jrytio/desiccant-dryer/docs/datasheets/README.md

# Component datasheets

Reference copies of the manufacturer documents for the parts in the
hardware BOMs ([protoboard](../hardware.md#bill-of-materials-protoboard-build),
[PCB](../hardware.md#printed-circuit-board-rev-a)), so the driver-stage numbers
and the protoboard layout can be checked against datasheets without leaving
the repo, and so a later re-check sees the same revision. All files were
retrieved on 2026-09-15 from the source in the table, except the SEFUSE
thermal-cutoff catalogue (2026-09-16), the PCB parts in `discretes/` (CJ, MDD,
NationStar, KENTO, UNI-ROYAL, Murata, YAGEO, Lelon), `fuses/`, `connectors/` and the two
module files in `power/` (K78, TSR-1), all retrieved 2026-10-14, the PTF-77, BLX-A and JST XH
files (2026-10-15, for the two-board rev A), and the four ESP32-C6 files
(2026-10-12, SparkFun's repository at commit `fb7352f`, which has no
`LICENSE.md` of its own; its README calls the hardware open source and
SparkFun's standing hardware licence is the CC BY-SA 4.0 in
`mcu/SPARKFUN-LICENSE.md`); the SHA-256 prefix is there to tell
whether a file was replaced. Manufacturer datasheets stay
their owners' copyright and are kept here for reference only; SparkFun's
hardware files are CC BY-SA 4.0 (`mcu/SPARKFUN-LICENSE.md`).

Prefer the manufacturer's current document when a number matters: a copy
here may be a revision behind. Where the manufacturer site refused a scripted
download, the table says whose copy this is.

| File | Part / where used | Document | Source | Pages | SHA-256 (first 16) | What to read |
|---|---|---|---|---|---|---|
| [mcu/sparkfun-esp32-s2-thing-plus.brd](mcu/sparkfun-esp32-s2-thing-plus.brd) | SparkFun ESP32-S2 Thing Plus (WRL-17743), the controller board | Eagle board file (CC BY-SA 4.0, see SPARKFUN-LICENSE.md) | [link](https://github.com/sparkfun/ESP32-S2_Thing_Plus/blob/main/Hardware/ESP32-S2_Thing_Plus.brd) |  | `3f91041525fae7df` | Outline (layer 20) is 22.86 × 64.77 mm; header pad positions; connector placement |
| [mcu/sparkfun-esp32-s2-thing-plus.sch](mcu/sparkfun-esp32-s2-thing-plus.sch) | SparkFun ESP32-S2 Thing Plus | Eagle schematic (CC BY-SA 4.0) | [link](https://github.com/sparkfun/ESP32-S2_Thing_Plus/blob/main/Hardware/ESP32-S2_Thing_Plus.sch) |  | `0bbf12487fef34cc` | Nets behind pinout-verification.md: V_USB → D2 → VIN → AP2112 → 3.3V; GPIO13 LED; USB jumper; no I2C pull-ups on the board |
| [mcu/sparkfun-esp32-s2-thing-plus-dimensions.pdf](mcu/sparkfun-esp32-s2-thing-plus-dimensions.pdf) | SparkFun ESP32-S2 Thing Plus | Dimensional drawing (inches) | [link](https://github.com/sparkfun/ESP32-S2_Thing_Plus/blob/main/Documents/ESP32-S2_Thing_Plus_DIMENSIONS.pdf) | 1 | `a04efc248ad8fc7d` | Board 2.55 × 0.90 in; header rows start 0.55 in (16-pin) and 0.95 in (12-pin) from the USB end; Qwiic at the USB end |
| [mcu/sparkfun-esp32-s2-thing-plus-dimensions.png](mcu/sparkfun-esp32-s2-thing-plus-dimensions.png) | SparkFun ESP32-S2 Thing Plus | Same drawing as PNG | [link](https://github.com/sparkfun/ESP32-S2_Thing_Plus/blob/main/Documents/ESP32-S2_Thing_Plus_DIMENSIONS.png) |  | `3d97430a1adcbfc2` |  |
| [mcu/espressif-esp32-s2-wroom-datasheet.pdf](mcu/espressif-esp32-s2-wroom-datasheet.pdf) | ESP32-S2-WROOM module on the Thing Plus | Espressif datasheet v1.1 (2020), SparkFun's copy | [link](https://github.com/sparkfun/ESP32-S2_Thing_Plus/blob/main/Documents/esp32-s2-wroom_esp32-s2-wroom-i_datasheet_en.pdf) | 27 | `f9521959bb886423` | Module pinout, antenna keep-out (Fig. 3, Fig. 8), current consumption (Tables 7–8: 310 mA peak) |
| [mcu/espressif-esp32-s2-datasheet.pdf](mcu/espressif-esp32-s2-datasheet.pdf) | ESP32-S2 chip | Espressif datasheet v1.1 (2020), SparkFun's copy | [link](https://github.com/sparkfun/ESP32-S2_Thing_Plus/blob/main/Documents/esp32-s2_datasheet_en.pdf) | 45 | `58cc0a634ddb939a` | Strapping pins, GPIO drive strength (Table 10), USB pins 19/20 |
| [mcu/sparkfun-esp32-c6-thing-plus.brd](mcu/sparkfun-esp32-c6-thing-plus.brd) | SparkFun Thing Plus ESP32-C6 (DEV-22924), the second supported controller board | Eagle board file (CC BY-SA 4.0, see SPARKFUN-LICENSE.md) | [link](https://github.com/sparkfun/SparkFun_Thing_Plus_ESP32_C6/blob/fb7352f770b885fa9d5767bd25a168b90a11d4e5/Hardware/Thing_Plus_ESP32_C6.brd) |  | `24b289329c3f9c98` | Outline is 22.86 × 58.42 mm; header pads at the same coordinates as the S2 board's (12-pin from 1.27, 24.13; 16-pin from 21.59, 13.97) |
| [mcu/sparkfun-esp32-c6-thing-plus.sch](mcu/sparkfun-esp32-c6-thing-plus.sch) | SparkFun Thing Plus ESP32-C6 | Eagle schematic (CC BY-SA 4.0) | [link](https://github.com/sparkfun/SparkFun_Thing_Plus_ESP32_C6/blob/fb7352f770b885fa9d5767bd25a168b90a11d4e5/Hardware/Thing_Plus_ESP32_C6.sch) |  | `aa89ff067b61ef02` | Nets behind pinout-verification.md: header J1; jumpers ALRT, SD_DET, LP, RGB, I2C; R1 100 kΩ on IO8; R11 100 kΩ on RESET; V_USB → D3 → RT9080 → 3.3V; USB D−/D+ straight to IO12/IO13 |
| [mcu/espressif-esp32-c6-wroom-1-datasheet.pdf](mcu/espressif-esp32-c6-wroom-1-datasheet.pdf) | ESP32-C6-WROOM-1 module on the C6 Thing Plus | Espressif datasheet, pre-release v0.6, SparkFun's copy | [link](https://github.com/sparkfun/SparkFun_Thing_Plus_ESP32_C6/blob/fb7352f770b885fa9d5767bd25a168b90a11d4e5/Documents/ESP32-C6-WROOM-1-Datasheet.pdf) | 37 | `b0ae5c4c27f051bb` | Module pin layout and pin descriptions |
| [mcu/espressif-esp32-c6-datasheet.pdf](mcu/espressif-esp32-c6-datasheet.pdf) | ESP32-C6 chip | Espressif datasheet, pre-release v0.5, SparkFun's copy | [link](https://github.com/sparkfun/SparkFun_Thing_Plus_ESP32_C6/blob/fb7352f770b885fa9d5767bd25a168b90a11d4e5/Documents/ESP32-C6-Datasheet.pdf) | 69 | `1338481686672951` | Section 2.6, strapping pins: Table 2-14 boot mode (GPIO8 low with GPIO9 low is invalid), Table 2-13 MTMS/MTDI |
| [relay/songle-srd-relay.pdf](relay/songle-srd-relay.pdf) | Songle SRD-05VDC-SL-C heater relays | Songle SRD series datasheet (2-page mirror hosted by circuitbasics.com) | [link](https://www.circuitbasics.com/wp-content/uploads/2015/11/SRD-05VDC-SL-C-Datasheet.pdf) | 2 | `9967e9a62db84c57` | Coil table (5 V: 70 Ω, 71.4 mA for the 0.36 W "L" coil), contact ratings, 1500 VAC coil–contact, outline and hole pattern |
| [thermal-fuse/nec-sefuse-thermal-cutoff.pdf](thermal-fuse/nec-sefuse-thermal-cutoff.pdf) | SEFUSE SF129E heater over-temp cutouts (sold as BOJACK SF129E) | NEC SCHOTT SEFUSE thermal cutoff catalogue, SF/SM series; distributor copy (Selli Fuse). The site answers a scripted download with a JavaScript challenge page, so this copy came from a browser download |  [link](http://www.sellifuse.com/pdf/NEC%20SEFUSE%20Thermal%20Cutoff.pdf) | 16 | `80c1d5b3843ec457` | SF/E standard rating table: SF129E is Tf 133 °C, operating 129 ± 2 °C, holding temperature Th 118 °C, maximum Tm 159 °C, 10 A / 250 VAC. Th is what the firmware `overtemp` limit has to stay below |
| [discretes/onsemi-pn2222a.pdf](discretes/onsemi-pn2222a.pdf) | PN2222A relay driver (the usual "2N2222" in TO-92) | onsemi PN2222/PN2222A, Rev. 1.1.0 | [link](https://web.archive.org/web/2022id_/https://www.onsemi.com/pdf/datasheet/pn2222a-d.pdf) | 8 | `f1eda8482f5f227f` | TO-92 pin order is E-B-C (flat face toward you, legs down); hFE and V<sub>CE(sat)</sub> tables |
| [discretes/onsemi-p2n2222a.pdf](discretes/onsemi-p2n2222a.pdf) | P2N2222A, an alternative TO-92 "2N2222" with the REVERSE pin order | onsemi P2N2222A, Rev. 7 | [link](https://cdn.sparkfun.com/datasheets/Components/General/P2N2222A-D.PDF) | 6 | `e8d9dd9bde7e379f` | Pin 1 is the collector: C-B-E. Check which part you have before fitting |
| [discretes/infineon-irlz44n.pdf](discretes/infineon-irlz44n.pdf) | IRLZ44N valve and fan drivers | Infineon / IR IRLZ44NPbF, PD-94831 | [link](https://www.infineon.com/dgdl/irlz44npbf.pdf?fileId=5546d462533600a40153567217c32129) | 10 | `b4f1361a4486b8ec` | V<sub>GS(th)</sub>, R<sub>DS(on)</sub> at 4 V and 5 V, transfer characteristic (3.3 V drive is not a specified point), TO-220 pin order G-D-S |
| [discretes/vishay-1n4001-1n4007.pdf](discretes/vishay-1n4001-1n4007.pdf) | 1N4007 flyback diodes | Vishay General Semiconductor, Revision 29-Apr-2020 | [link](https://www.vishay.com/docs/88503/1n4001.pdf) | 5 | `56a77c6615c90c11` | Ratings; the colour band marks the cathode, which goes to the supply side |
| [power/meanwell-lrs-35.pdf](power/meanwell-lrs-35.pdf) | Mean Well LRS-35-24 supply | Mean Well LRS-35 spec sheet, 2025-04-07 | [link](https://www.meanwell.com/Upload/PDF/LRS-35/LRS-35-SPEC.PDF) | 4 | `43ceb7255f0613bf` | 24 V / 1.5 A, hiccup overload 110–150 %, 45 A cold-start inrush, FG terminal, derating; an open-frame Class I component supply |
| [power/mps-mp1584.pdf](power/mps-mp1584.pdf) | MPS MP1584, the IC on the 24 V → 5 V "MP1584 mini" buck module | MPS MP1584 Rev. 1.0 (2011), RS Components' copy; monolithicpower.com serves datasheets through a viewer | [link](https://docs.rs-online.com/b924/A700000013716646.pdf) | 17 | `4b850bd18a8ce88b` | 4.5–28 V input, non-synchronous (cannot sink current), 3 A, feedback 0.8 V ±3 %, input capacitor requirement |
| [power/st-bat20j.pdf](power/st-bat20j.pdf) | BAT20J Schottky on the Thing Plus (D2, USB pin → VIN) | ST BAT20J, April 2004 Ed. 1 | [link](https://www.st.com/resource/en/datasheet/bat20j.pdf) | 5 | `c134fbb1f476bc20` | Forward drop vs current (0.40 V max at 100 mA, ~0.5 V at 400 mA): the drop budget when the buck feeds the USB pin |
| [power/diodes-ap2112.pdf](power/diodes-ap2112.pdf) | AP2112K-3.3 LDO on the Thing Plus (U3) | Diodes Inc. AP2112, DS39724 Rev. 2-2 (June 2017) | [link](https://www.diodes.com/assets/Datasheets/AP2112.pdf) | 18 | `ef8d376f2ec356e2` | 600 mA, dropout vs current, 6.0 V recommended / 6.5 V absolute maximum input |
| [power/diodes-dmg2307l.pdf](power/diodes-dmg2307l.pdf) | DMG2307L battery cut-off P-FET on the Thing Plus (Q1) | Diodes Inc. DMG2307L, DS35415 Rev. 6-3 (marked not for new design) | [link](https://www.diodes.com/assets/Datasheets/DMG2307L.pdf) | 7 | `51e506995ea31c15` | Why 5 V must not be fed into the BAT pin |
| [power/microchip-mcp73831.pdf](power/microchip-mcp73831.pdf) | MCP73831 LiPo charger on the Thing Plus (U4) | Microchip DS20001984H | [link](https://ww1.microchip.com/downloads/aemDocuments/documents/APID/ProductDocuments/DataSheets/MCP73831-Family-Data-Sheet-DS20001984H.pdf) | 29 | `75297f2a52355993` | Behaviour with no battery while V_USB is fed from the buck; 7 V absolute maximum input |
| [sensors/sensirion-sht4x.pdf](sensors/sensirion-sht4x.pdf) | Sensirion SHT45 outlet humidity sensor | Sensirion SHT4x datasheet, Version 7.3 (June 2026) | [link](https://sensirion.com/resource/datasheet/sht4x) | 25 | `8db4a43f17149b76` | Supply range, I2C address 0x44, accuracy at low RH (Fig. 5, Fig. 9), bus pull-up limits, heater |
| [sensors/analog-ds18b20.pdf](sensors/analog-ds18b20.pdf) | DS18B20 pack and case temperature probes | Maxim / Analog Devices DS18B20 (REV 042208), Adafruit's copy; analog.com refuses scripted downloads | [link](https://cdn-shop.adafruit.com/datasheets/DS18B20.pdf) | 22 | `39d191cd1fb657e4` | 3.0–5.5 V supply, ~5 kΩ pull-up, die −55 to +125 °C, ±0.5 °C only from −10 to +85 °C (±2 °C above), +85 °C power-on value |
| [sensors/sitronix-st7789v.pdf](sensors/sitronix-st7789v.pdf) | ST7789V controller in the 1.54" 240×240 display | Sitronix ST7789V, Version 1.3 (hosted by Newhaven Display) | [link](https://www.newhavendisplay.com/appnotes/datasheets/LCDs/ST7789V.pdf) | 316 | `8ecf0e438aa25554` | Logic supply range, 4-line SPI timing (16 ns write cycle), reset timing |
| [sensors/lcdwiki-msp1541-user-manual.pdf](sensors/lcdwiki-msp1541-user-manual.pdf) | LCDWIKI MSP1541, a typical 1.54" 8-pin ST7789 module | LCDWIKI MSP1541 user manual Rev1.0 | [link](http://www.lcdwiki.com/res/MSP1541/1.54inch_4-line-SPI_IPS_Module_MSP1541_User_Manual_EN.pdf) | 18 | `f942da1ba5fbb2ce` | Pin order GND VCC SCL SDA RES DC CS BLK (matches the display header in the layout); 3.3 V only |
| [sensors/lcdwiki-msp1541-schematic.pdf](sensors/lcdwiki-msp1541-schematic.pdf) | LCDWIKI MSP1541 module schematic | QDtech, 2019-11-14 | [link](https://www.lcdwiki.com/res/MSP1541/1.54IPS_MSP1541_Schematic.pdf) | 1 | `75ed8127fa6adc81` | BLK drives an S8050 transistor through 1 kΩ (10 kΩ pull-up to VCC), so a GPIO can drive it directly and the backlight defaults on |
| [sensors/waveshare-1.54inch-lcd-module-schematic.pdf](sensors/waveshare-1.54inch-lcd-module-schematic.pdf) | Waveshare 1.54inch LCD Module, another common ST7789 module | Waveshare schematic, 2020 | [link](https://files.waveshare.com/wiki/1.54inch_LCD_Module/1.54inch_LCD_Module_SchDoc.pdf) | 2 | `dc7c6c569e05ea48` | Different header order (VCC GND DIN CLK CS DC RST BL): a straight cable from the layout's header would swap power and ground |
| [sensors/adafruit-1.54in-ips-tft-schematic.png](sensors/adafruit-1.54in-ips-tft-schematic.png) | Adafruit 1.54" IPS TFT (product 3787) | Adafruit schematic rev G, 2019 | [link](https://cdn-learn.adafruit.com/assets/assets/000/079/157/original/adafruit_products_1-54in_IPS_TFT_Sch.png) |  | `7912d71e033c8786` | Backlight through a BSS138; third example of a transistor-driven BLK |
| [valves/smc-vdw-series-catalog-current.pdf](valves/smc-vdw-series-catalog-current.pdf) | SMC VDW22QABXB vent valves | SMC "Compact Direct Operated 2 Port Solenoid Valve, VDW Series" (current series, catalogue pp. 453–470, 2022 revision) | [link](https://content2.smcetech.com/pdf/VDWb.pdf) | 20 | `f2e8a214297826bc` | How-to-order table that decodes VDW22QABXB (size 2, water type, brass 1/8 NPT ø3.2, 24 VDC grommet, bracket); 3 W DC coil, no built-in suppressor; 50 °C limit; 0.2 MPa differential for ø3.2 |
| [valves/smc-vdw10-20-30-catalog-discontinued.pdf](valves/smc-vdw10-20-30-catalog-discontinued.pdf) | SMC VDW10/20/30 (previous series) | SMC "VDW Series for Water and Air", catalogue pp. 471–495, marked discontinued | [link](https://content2.smcetech.com/pdf/VDW.pdf) | 25 | `734f57eeaacf824a` | The catalogue a search for "VDW22" finds first; its hyphenated ordering table cannot decode the BOM part number |
| [fan/sunon-mf80252v1-1000u-g99.pdf](fan/sunon-mf80252v1-1000u-g99.pdf) | Example 24 V 80 mm case fan (Sunon MF80252V1-1000U-G99); no fan has been chosen yet | Sunon specification D08064510G-01, rev 2021-07-26 (distributor copy) | [link](https://www.fansco.com/datasheets/sunon/MF80252V1-1000U-G99.pdf) | 15 | `84b13dafba699f3b` | 24 V, 65 mA rated / 75 mA max, 8–27.6 V operating, polarity protected: sizes the fan channel |
| [discretes/cj-mmbt2222a.pdf](discretes/cj-mmbt2222a.pdf) | CJ MMBT2222A 1P (LCSC C8512), PCB relay drivers Q1, Q2 | Changjiang (JCET) MMBT2222A, LCSC's copy | [link](https://wmsc.lcsc.com/wmsc/upload/file/pdf/v2/lcsc/1811081957_Jiangsu-Changjing-Electronics-Technology-Co---Ltd--MMBT2222A-1P_C8512.pdf) | 2 | `af383629b6a3bbb5` | SOT-23 pin order 1 B, 2 E, 3 C; 600 mA, 40 V |
| [discretes/cj-cj2310.pdf](discretes/cj-cj2310.pdf) | CJ CJ2310 (LCSC C75882), PCB valve and fan switches Q3–Q5 | Changjiang (JCET) CJ2310, LCSC's copy | [link](https://wmsc.lcsc.com/wmsc/upload/file/pdf/v2/lcsc/1810010214_Jiangsu-Changjing-Electronics-Technology-Co---Ltd--CJ2310_C75882.pdf) | 5 | `8095c146e18963bb` | 60 V; V<sub>GS(th)</sub> 0.5–2 V; R<sub>DS(on)</sub> 125 mΩ max at 4.5 V (3.3 V is not a specified point); pins 1 G, 2 S, 3 D |
| [discretes/mdd-m7.pdf](discretes/mdd-m7.pdf) | MDD M7 (LCSC C95872), PCB flyback diodes D1, D2, D5–D7 (the S1M rating) | MDD M1–M7, LCSC's copy | [link](https://wmsc.lcsc.com/wmsc/upload/file/pdf/v2/lcsc/2407101107_MDD-Microdiode-Semiconductor-M7_C95872.pdf) | 3 | `ab203b9979af54e0` | 1 A, 1000 V, SMA; the band marks the cathode |
| [discretes/mdd-ss34.pdf](discretes/mdd-ss34.pdf) | MDD SS34 (LCSC C8678), PCB D11 reverse-polarity and D14 USB feed | MDD SS32–SS320, LCSC's copy | [link](https://wmsc.lcsc.com/wmsc/upload/file/pdf/v2/lcsc/2407101107_MDD-Microdiode-Semiconductor-SS34_C8678.pdf) | 3 | `fb49708757796969` | 3 A, 40 V, 0.55 V at 3 A |
| [discretes/nationstar-ncd0805r1.pdf](discretes/nationstar-ncd0805r1.pdf) | NationStar NCD0805R1 red LED (LCSC C84256), PCB D3, D4 | NationStar NCD0805R1, LCSC's copy | [link](https://wmsc.lcsc.com/wmsc/upload/file/pdf/v2/lcsc/2409272203_Foshan-NationStar-Optoelectronics-NCD0805R1_C84256.pdf) | 2 | `3a6caf350b158166` | V<sub>F</sub> 1.5–2.6 V at 20 mA; polarity mark |
| [discretes/kento-kt-0805y.pdf](discretes/kento-kt-0805y.pdf) | KENTO KT-0805Y yellow LED (LCSC C2296), PCB D8–D10 | KENTO KT-0805Y, LCSC's copy | [link](https://wmsc.lcsc.com/wmsc/upload/file/pdf/v2/lcsc/1806151129_Hubei-KENTO-Elec-KT-0805Y_C2296.pdf) | 11 | `d8a2b8369f288161` | V<sub>F</sub> 1.8–2.4 V at 10 mA |
| [discretes/kento-kt-0805g.pdf](discretes/kento-kt-0805g.pdf) | KENTO KT-0805G green LED (LCSC C2297), PCB D12, D13 | KENTO KT-0805G, LCSC's copy | [link](https://wmsc.lcsc.com/wmsc/upload/file/pdf/v2/lcsc/1806151820_Hubei-KENTO-Elec-KT-0805G_C2297.pdf) | 11 | `853e6752f600e247` | V<sub>F</sub> 2.6–3.1 V at 5 mA |
| [discretes/uniroyal-0805w8f.pdf](discretes/uniroyal-0805w8f.pdf) | UNI-ROYAL 0805W8F thick-film resistors, all PCB resistors (LCSC C17408, C17513, C17520, C27834, C17414) | UNI-ROYAL chip resistor series, LCSC's copy (the same file for every value) | [link](https://wmsc.lcsc.com/wmsc/upload/file/pdf/v2/lcsc/2411221126_UNI-ROYAL-Uniroyal-Elec-0805W8F1000T5E_C17408.pdf) | 9 | `11cd644d5d8a34a6` | 1 %, 125 mW, 150 V working voltage at 0805 |
| [discretes/murata-grm21br61h106ke43l.pdf](discretes/murata-grm21br61h106ke43l.pdf) | Murata GRM21BR61H106KE43L (LCSC C440198), PCB C2 | Murata product datasheet, LCSC's copy | [link](https://wmsc.lcsc.com/wmsc/upload/file/pdf/v2/lcsc/2411041759_Murata-Electronics-GRM21BR61H106KE43L_C440198.pdf) | 31 | `ff8de8901544f5f4` | 10 µF 50 V X5R 0805; DC-bias derating |
| [discretes/yageo-cc0805-x7r.pdf](discretes/yageo-cc0805-x7r.pdf) | YAGEO CC0805KRX7R9BB104 (LCSC C49678), PCB C5 | YAGEO CC series X7R, LCSC's copy | [link](https://wmsc.lcsc.com/wmsc/upload/file/pdf/v2/lcsc/2304140030_YAGEO-CC0805KRX7R9BB104_C49678.pdf) | 29 | `61a606825ab314ea` | 100 nF 50 V X7R 0805 |
| [discretes/lelon-vzh.pdf](discretes/lelon-vzh.pdf) | Lelon VZH electrolytics, PCB C1 (VZH101M1HTR-0810, LCSC C294509) and C4 (VZH101M1CTR-0607, LCSC C231174) | Lelon VZH series, Cat. 2025E3, LCSC's copy (the same file for both) | [link](https://wmsc.lcsc.com/wmsc/upload/file/pdf/v2/lcsc/2304140030_Lelon-VZH101M1HTR-0810_C294509.pdf) | 3 | `c50f58036daa6123` | Dimension table: 8 × 10 terminals 3.1 mm apart, 9.0 overall; 6.3 × 7.7 terminals 2.0 apart, 7.2 overall (both inside the KiCad CP_Elec pads) |
| [fuses/littelfuse-1812l.pdf](fuses/littelfuse-1812l.pdf) | Littelfuse 1812L110/33MR (LCSC C142747), PCB F2 24 V input PPTC | Littelfuse 1812L series, LCSC's copy | [link](https://wmsc.lcsc.com/wmsc/upload/file/pdf/v2/lcsc/2304140030_Littelfuse-1812L110-33MR_C142747.pdf) | 7 | `6208de21968a51c9` | 1812L110/33: I<sub>hold</sub> 1.10 A, I<sub>trip</sub> 1.95 A, 33 V max |
| [fuses/xfcn-ptf-76-b.pdf](fuses/xfcn-ptf-76-b.pdf) | XFCN PTF-76-B covered 5 × 20 mm fuse holder (LCSC C48603682), mains-board F1 again from 2026-10-16 (the single-board rev A's choice; the holders on hand do not fit beside the vertical plug) | XFCN drawing PTF-76-B rev A1 (2025-04-23), LCSC's copy | [link](https://wmsc.lcsc.com/wmsc/upload/file/pdf/v2/lcsc/2504281715_XFCN-PTF-76-B_C48603682.pdf) | 1 | `866386d6da1c64c0` | Pins 15 mm apart, 0.5 × 1.03 mm, PCB hole Ø1.6; body 24.4 × 9.4 × 15 mm; UL 250 VAC 20 A, VDE 6.3 A; PC1 shock-safe cap |
| [fuses/xfcn-ptf-77.pdf](fuses/xfcn-ptf-77.pdf) | XFCN PTF-77 covered 5 × 20 mm fuse holder (LCSC C717030), a 22.5 mm covered holder; not an alternative for mains-board F1 beside the vertical plug (its body would reach into the plug's courtyard), only for a right-angle-plug layout | XFCN drawing PTF-77 rev A2 (2024-10-31), LCSC's copy | [link](https://datasheet.lcsc.com/datasheet/pdf/4d0d950ca032c4cb948cbbb43ce1e88c.pdf?productCode=C717030) | 1 | `1149838c5e30dc7b` | Pins 22.50 mm apart, 0.5 × 1.03 mm, PCB hole Ø1.6; the PTF-76-B body (24.4 × 9.4, 15 mm tall); UL 250 VAC 20 A, VDE 6.3 A |
| [fuses/jksemi-blx-a.pdf](fuses/jksemi-blx-a.pdf) | BLX-A covered 5 × 20 mm PCB fuse holder, the moulding the holders on hand (Amazon B0FCS5MK1Y, 10 A 250 V) match by their dimensions; not fitted on the mains board (the body does not fit beside the vertical plug) | JKSEMI BLX-A rev 1.0 | [link](https://img03.71360.com/w3/772o3g/20250716/01c82b612508a7961211755f06253753.pdf) | 2 | `c2f9afe90a399a08` | Pins 22.3 ± 1.0 mm apart (21.5 to 22.7 accepted), 1.31 mm blades, R 1.5 pads; base 25.8 × 9.7 × 10.2, 13.45 mm with the cover; the Amazon listing's drawing gives the same 25.8 and 13.4 but no pitch; the reviewer's first 12.5 mm reading (2026-10-15) came from the listing's picture; he then confirmed about 22 mm on the holders, matching this sheet |
| [connectors/dorabo-db2erc-5.08.pdf](connectors/dorabo-db2erc-5.08.pdf) | DORABO DB2ERC-5.08-8P-GN right-angle header (LCSC C395786), PCB J_MAINS until 2026-10-15; the vertical DB2EV-5.08-8P-GN (LCSC C395787, 630 V 15 A per LCSC) replaced it and its drawing is not retrieved (LCSC: `datasheet/C395787.pdf`) | DORABO drawing DB2ERC-5.08-XXP-C rev M1, LCSC's copy | [link](https://wmsc.lcsc.com/wmsc/upload/file/pdf/v2/lcsc/2303271530_DORABO-DB2ERC-5-08-8P-GN_C395786.pdf) | 1 | `87e383dca46af68b` | Pitch 5.08, 1.0 mm pins, hole Ø1.7, body 12.0 deep with the pins 2.0 from the rear; UL 300 V 15 A, IEC 250 V/15 A (III/3) |
| [connectors/dorabo-db2evc-5.08.pdf](connectors/dorabo-db2evc-5.08.pdf) | DORABO DB2EVC-5.08 vertical headers, PCB J_LOADS (6P, LCSC C395768) and J_24V (2P, LCSC C395734) | DORABO drawing DB2EVC-5.08-XXP-C rev M1, LCSC's copy (the same file for both) | [link](https://wmsc.lcsc.com/wmsc/upload/file/pdf/v2/lcsc/2303271600_DORABO-DB2EVC-5-08-6P-GN_C395768.pdf) | 1 | `ca60a84814ef0e6e` | Pitch 5.08, 1.0 mm pins, hole Ø1.7, body 7.8 deep (8.65 with the latch), pins 3.9 from the back |
| [connectors/dorabo-db2evc-3.5.pdf](connectors/dorabo-db2evc-3.5.pdf) | DORABO DB2EVC-3.5-9P-GN vertical header (LCSC C430559), PCB J_SENS | DORABO drawing DB2EVC-3.5-XXP-C rev T0-1, LCSC's copy | [link](https://wmsc.lcsc.com/wmsc/upload/file/pdf/v2/lcsc/2303271530_DORABO-DB2EVC-3-5-9P-GN_C430559.pdf) | 1 | `30e5f93cc9237795` | Pitch 3.5, 0.8 × 0.8 mm pins, hole Ø1.4, body N × 3.5 + 1.0 by 7.0 |
| [connectors/dorabo-db2ek-5.08.pdf](connectors/dorabo-db2ek-5.08.pdf) | DORABO DB2EK-5.08 screw plugs (loose): 8P C395791, 6P C395774, 2P C395732 | DORABO drawing DB2EK-5.08, LCSC's copy (the same file for all three) | [link](https://wmsc.lcsc.com/wmsc/upload/file/pdf/v2/lcsc/2303271530_DORABO-DB2EK-5-08-8P-GN-S_C395791.pdf) | 1 | `18b9159a3f026e80` | Mating plugs for J_MAINS, J_LOADS, J_24V; wire range |
| [connectors/dorabo-db2ek-3.5.pdf](connectors/dorabo-db2ek-3.5.pdf) | DORABO DB2EK-3.5-9P-GN-S screw plug (loose, LCSC C430561) | DORABO drawing DB2EK-3.5, LCSC's copy | [link](https://wmsc.lcsc.com/wmsc/upload/file/pdf/v2/lcsc/2301061509_DORABO-DB2EK-3-5-9P-GN-S_C430561.pdf) | 1 | `5e8dfb0508795183` | Mating plug for J_SENS |
| [connectors/xfcn-pz254v-11-08p.pdf](connectors/xfcn-pz254v-11-08p.pdf) | XFCN PZ254V-11-08P pin header (LCSC C492407), PCB J_DISP | XFCN drawing, LCSC's copy | [link](https://wmsc.lcsc.com/wmsc/upload/file/pdf/v2/lcsc/2003191006_XFCN-PZ254V-11-08P_C492407.pdf) | 1 | `d4cb67e0fd15267b` | 2.54 pitch, 0.64 mm square pins, hole Ø1.02 |
| [connectors/kinghelm-kh-2.54fh-1x16p-h8.5.pdf](connectors/kinghelm-kh-2.54fh-1x16p-h8.5.pdf) | Kinghelm KH-2.54FH-1X16P-H8.5 socket (LCSC C2905421), PCB J_ESP16 | Kinghelm drawing, LCSC's copy | [link](https://wmsc.lcsc.com/wmsc/upload/file/pdf/v2/lcsc/2110191530_Shenzhen-Kinghelm-Elec-KH-2-54FH-1X16P-H8-5_C2905421.pdf) | 1 | `3146e4188cce064f` | 2.54 pitch, 8.5 mm insulator, 0.64 × 0.4 mm pins, hole Ø1.02 |
| [connectors/kinghelm-kh-2.54fh-1x12p-h8.5.pdf](connectors/kinghelm-kh-2.54fh-1x12p-h8.5.pdf) | Kinghelm KH-2.54FH-1X12P-H8.5 socket (LCSC C2905419), PCB J_ESP12 | Kinghelm drawing, LCSC's copy | [link](https://wmsc.lcsc.com/wmsc/upload/file/pdf/v2/lcsc/2110191530_Shenzhen-Kinghelm-Elec-KH-2-54FH-1X12P-H8-5_C2905419.pdf) | 1 | `9dbea449c7a25dd6` | As the 16-pin |
| [connectors/jst-xh.pdf](connectors/jst-xh.pdf) | JST XH series, B4B-XH-A(LF)(SN) 4-way header (LCSC C144395), PCB J_RLY (controller) and J_CTRL (mains), the board-to-board link; XHP-4 housing and SXH crimps for the cable | JST XH connector catalogue, jst-mfg.com | [link](https://www.jst-mfg.com/product/pdf/eng/eXH.pdf) | 9 | `9426b136902f1190` | 2.50 mm pitch, 0.64 mm square pins, PCB hole Ø0.9 (KiCad's footprint drills 0.95); B4B-XH-A top-entry dimensions; 3 A, 250 V |
| [connectors/sofng-ss-12d00.pdf](connectors/sofng-ss-12d00.pdf) | SOFNG SS-12D00-G3 slide switch (LCSC C22355741), PCB SW1 (SW-USB) | SOFNG SS-12D00 series, LCSC's copy | [link](https://wmsc.lcsc.com/wmsc/upload/file/pdf/v2/lcsc/2405291526_SOFNG-SS-12D00-G3_C22355741.pdf) | 1 | `c7b840388e60f1b7` | Pitch 2.5 mm (not 2.54), 0.5 × 0.3 mm pins, body 8.8 × 3.9; 0.5 A 24 V DC; middle pin common |
| [power/mornsun-k78xx-1000r3.pdf](power/mornsun-k78xx-1000r3.pdf) | MornSun K7805-1000R3 5 V module, PCB U1 (hand-fitted) | MornSun K78xx-1000R3(L), 2021.01.8-A/3, chipdip.ru's copy (mornsun-power.com's direct link is 404) | [link](https://static.chipdip.ru/lib/187/DOC043187583.pdf) | 4 | `8377b7879d3c08d9` | Pin 1 +Vin, 2 GND, 3 +Vout; 22 µF/50 V input capacitor above 30 V in |
| [power/traco-tsr-1.pdf](power/traco-tsr-1.pdf) | TRACO TSR 1-2450, the TSR-1 footprint's own part and U1's Mouser source (495-TSR-1-2450) | TRACO TSR-1 series datasheet | [link](https://www.tracopower.com/sites/default/files/products/datasheets/tsr1_datasheet.pdf) | 4 | `bedf240fea9eebaf` | Same 78xx pinout and SIP-3 outline as the K78; input range |

## Not included

- Songle's current SRD revision (V1, 3 pages, 13 MB, a CorelDRAW print with a
  broken text layer) is at
  <https://www.songlerelay.com/upload/8670/srd-t73-relay-290486.pdf>. Left
  out for its size; the 2-page mirror above is the earlier revision with the
  same coil table and hole pattern (COM at the coil end, 2.0 mm outboard;
  rows 12.0 mm and columns 12.2 mm apart; holes 1.3 mm).
- The DS18B20 document's canonical home is
  <https://www.analog.com/media/en/technical-documentation/data-sheets/DS18B20.pdf>
  (Rev 6 there); analog.com refuses scripted downloads, so the copy here is
  Adafruit's, an older revision with the same tables.
- The buck module itself has no datasheet: "MP1584 mini" boards come from
  many vendors at 22 × 17 mm with a trimmer and no fixed part number. The
  MPS datasheet above covers the IC.
- The Samsung CL21A MLCC catalogue for PCB C3 (CL21A226MAQNNNE, LCSC C45783) and C6
  (CL21A106KAYNNNE, LCSC C15850) is at
  <https://wmsc.lcsc.com/wmsc/upload/file/pdf/v2/lcsc/2304140030_Samsung-Electro-Mechanics-CL21A226MAQNNNE_C45783.pdf>.
  Left out for its size (84 pages, 7.8 MB).
- KENTO's red KT-0805R (LCSC C2295) has no datasheet at LCSC or JLCPCB, which is why the
  red LEDs are NationStar NCD0805R1 instead (checked 2026-10-14).
