jrytio/desiccant-dryer/docs/superpowers/plans/2026-10-14-pcb-design-kicad.md

# PCB Design in KiCad Implementation Plan

> **For agentic workers:** REQUIRED SUB-SKILL: Use superpowers:subagent-driven-development (recommended) or superpowers:executing-plans to implement this plan task-by-task. Steps use checkbox (`- [ ]`) syntax for tracking.

**Goal:** One fab-assembled KiCad 10 board, generated from Python in `hardware/`, that replaces the two protoboards, with ERC, DRC (including a 6 mm mains clearance rule) and fab exports run by `scripts/hardware.sh` locally and in CI.

**Architecture:** `hardware/dryer_board/circuit.py` is the single table of parts, pins and nets; everything else derives from it. `schematic.py` writes a label-style `.kicad_sch` by embedding stock symbols; `board.py` builds the `.kicad_pcb` through KiCad's bundled `pcbnew` Python from a placement table and exports a DSN; `route.py` runs Freerouting in Docker and imports the SES; `kicad-cli` checks and exports. The committed KiCad files are regenerated by the generator and compared in CI; routing stays local.

**Deviation from the spec:** exports are driven by `export.py` calling `kicad-cli` directly instead of a `.kicad_jobset`; same commands, no GUI-authored JSON to maintain.

**Tech Stack:** KiCad 10.0.6 (`kicad-cli`, bundled Python 3.9 with `pcbnew`), Docker image `ghcr.io/freerouting/freerouting:2.5.0`, CI image `kicad/kicad:10.0`, Python 3.9 standard library only (no pip), bash.

**Spec:** `docs/superpowers/specs/2026-10-14-pcb-design-kicad-design.md`

## Global Constraints

- Python in `hardware/` runs under KiCad's bundled Python **3.9** (no `match`, no `X | Y` type unions, no pip packages). Tests use `unittest`.
- **No Java on the Mac.** Freerouting runs only as `ghcr.io/freerouting/freerouting:2.5.0` in Docker.
- Generated files are deterministic: UUIDs from `uuid.uuid5(NAMESPACE, "dryer/<key>")`, dictionaries emitted in sorted order, no timestamps.
- Mains nets are exactly `L_IN`, `L_FUSED`, `L_SW_A`, `L_SW_B`, `N`; they form netclass `MAINS` (1.5 mm tracks, 1.0 mm in-class clearance, no pours). Mains to any other net: 6 mm, relaxed to 3.5 mm only inside rule areas named `relay_pads`. Copper to edge and slot 0.5 mm; mains copper to edge 1 mm.
- Relay K1/K2: pad 1 = COM, pads 2 and 5 = coil, **pad 3 = NO** (heater), **pad 4 = NC** (no copper). Derived from the KiCad `SANYOU_SRD_Form_C` symbol drawing and Songle's wiring diagram; the first-article continuity check confirms it on the real part.
- The pin map by header position is fixed (spec, `pinmap.py`); 12-pin positions 9 and 10 and 16-pin positions 15 and 16 stay unconnected; I2C stays on the ESP's Qwiic connector.
- Part choices: every part carries an LCSC number or `hand_fit=True`; no part is "tested" or "verified" in docs unless it was.
- Repo rules: no device IPs, no VMD-08/Azco branding in titles, numbers sourced from `docs/datasheets/`, unverified values marked as such.
- Commit after every task with a message in the repo's style (imperative, what and why); end commit messages with `Co-Authored-By: Claude Fable 5.1 <noreply@anthropic.com>`.
- Never `cp` onto `esphome/secrets.yaml` in a worktree (it is a symlink to the real secrets).

## Review Focus

1. **A footprint whose pad numbers do not match the symbol's pin numbers** (the slide switch and fuse holder are the likely ones): the part would be wired to the wrong pads. Task 5's test asserts every footprint has every pad number the model assigns.
2. **Relay NO/NC swapped**: the heater would be live with the relay off. Task 3's test pins K1/K2 pad 3 to `L_SW_x` and pad 4 to NC, and Task 17's continuity check confirms it on the real relay.
3. **A mains net left out of the `MAINS` netclass pattern** (`N` does not match `L_*`): the 6 mm rule would silently not apply. Task 8's test asserts each of the five mains nets resolves to `MAINS` and no other net does.
4. **Copper under the antenna**: a track or pour routed into the keep-out would detune the WiFi antenna. Task 10's test scans the routed board for any copper inside the antenna rectangle.
5. **Electrolytic or LED polarity reversed in the model**: a reversed 100 µF at 24 V vents. Task 3's test asserts pad 1 of every `C_Polarized` is on a rail and pad 2 on GND, and that every LED's anode side goes to its resistor and its cathode to the switched node or GND.

---

## File Structure

```
hardware/
  README.md                      how to generate, route, check, export; tool locations
  dryer_board/
    __init__.py
    kicad_env.py                 find kicad-cli, KiCad's python, symbol and footprint dirs
    sexp.py                      S-expression parse/dump (schematic, libraries)
    circuit.py                   REVISION, nets, the parts table, netlist(), invariants
    pinmap.py                    header position -> function (shared with tests/test_pinmap.py)
    libs.py                      read stock symbols (flatten `extends`), locate footprints, pad numbers
    schematic.py                 write dryer-controller.kicad_sch, sym-lib-table, fp-lib-table
    project.py                   write dryer-controller.kicad_pro and .kicad_dru
    placement.py                 board outline, zones, slot gaps, placement table, silkscreen text
    board.py                     build/update dryer-controller.kicad_pcb with pcbnew; export DSN
    route.py                     Freerouting in Docker; import SES; fill zones
    export.py                    kicad-cli exports, JLCPCB BOM/CPL conversion, renders, zip
    check_sync.py                committed files == regenerated model
    cli.py                       `python -m dryer_board <generate|route|check|export|test>`
  dryer-controller/
    dryer-controller.kicad_pro   generated
    dryer-controller.kicad_sch   generated
    dryer-controller.kicad_pcb   generated + routed (tracks are the only hand/route-owned content)
    dryer-controller.kicad_dru   generated
    sym-lib-table, fp-lib-table  generated
    lib/dryer.pretty/            local footprints (only if a stock one is missing)
  tests/
    test_sexp.py test_circuit.py test_libs.py test_schematic.py test_project.py
    test_board.py test_route.py test_export.py
  out/                           gitignored fab outputs
scripts/hardware.sh              wrapper: finds KiCad, runs the subcommands
tests/test_pinmap.py             repo-level: firmware board packages vs pinmap (plain python3)
.github/workflows/hardware.yml   check + export + release on pcb-* tags
docs/hardware/                   schematic.pdf, top.svg, render-top.png, render-iso.png
```

The tasks run in this order; each is independently testable. Tasks 1 to 7 need no Docker. Task 10 needs Docker. Task 15 needs internet (LCSC lookups).

---

### Task 1: Tool locator and wrapper script

**Files:**
- Create: `hardware/dryer_board/__init__.py`, `hardware/dryer_board/kicad_env.py`, `hardware/dryer_board/cli.py`, `scripts/hardware.sh`, `hardware/README.md`
- Create: `hardware/tests/__init__.py`, `hardware/tests/test_kicad_env.py`
- Modify: `.gitignore` (add `hardware/out/`)

**Interfaces:**
- Produces: `kicad_env.kicad_cli() -> str`, `kicad_env.symbol_dir() -> str`, `kicad_env.footprint_dir() -> str`, `kicad_env.run_cli(*args) -> subprocess.CompletedProcess` (raises on nonzero), `kicad_env.REPO`, `kicad_env.PROJECT_DIR` (`hardware/dryer-controller`), `kicad_env.OUT_DIR` (`hardware/out`).

- [ ] **Step 1: Write the failing test**

```python
# hardware/tests/test_kicad_env.py
import os, unittest
from dryer_board import kicad_env

class KicadEnv(unittest.TestCase):
    def test_tools_exist(self):
        self.assertTrue(os.path.isfile(kicad_env.kicad_cli()))
        self.assertTrue(os.path.isfile(os.path.join(kicad_env.symbol_dir(), "Device.kicad_sym")))
        self.assertTrue(os.path.isdir(os.path.join(kicad_env.footprint_dir(), "Relay_THT.pretty")))

    def test_run_cli_version(self):
        out = kicad_env.run_cli("version").stdout
        self.assertRegex(out.strip(), r"^10\.")

    def test_paths(self):
        self.assertTrue(kicad_env.PROJECT_DIR.endswith("hardware/dryer-controller"))
        self.assertTrue(os.path.isfile(os.path.join(kicad_env.REPO, "CLAUDE.md")))
```

- [ ] **Step 2: Run it to see it fail**

Run: `/Applications/KiCad/KiCad.app/Contents/Frameworks/Python.framework/Versions/Current/bin/python3 -m unittest discover -s hardware/tests -t hardware -v`
Expected: `ModuleNotFoundError: No module named 'dryer_board'`

- [ ] **Step 3: Write kicad_env.py**

```python
# hardware/dryer_board/kicad_env.py
"""Where KiCad lives. macOS app bundle first, then the kicad/kicad Docker image layout,
then anything on PATH. Override with KICAD_CLI, KICAD_SYMBOL_DIR, KICAD_FOOTPRINT_DIR."""
import os, shutil, subprocess

HERE = os.path.dirname(os.path.abspath(__file__))
REPO = os.path.abspath(os.path.join(HERE, "..", ".."))
PROJECT_DIR = os.path.join(REPO, "hardware", "dryer-controller")
OUT_DIR = os.path.join(REPO, "hardware", "out")
PROJECT = "dryer-controller"

_MAC_APP = "/Applications/KiCad/KiCad.app/Contents"
_CANDIDATES = {
    "cli": [os.environ.get("KICAD_CLI", ""), _MAC_APP + "/MacOS/kicad-cli", "/usr/bin/kicad-cli"],
    "symbols": [os.environ.get("KICAD_SYMBOL_DIR", ""), _MAC_APP + "/SharedSupport/symbols", "/usr/share/kicad/symbols"],
    "footprints": [os.environ.get("KICAD_FOOTPRINT_DIR", ""), _MAC_APP + "/SharedSupport/footprints", "/usr/share/kicad/footprints"],
}

def _first(kind, test):
    for c in _CANDIDATES[kind]:
        if c and test(c):
            return c
    found = shutil.which("kicad-cli") if kind == "cli" else None
    if found:
        return found
    raise FileNotFoundError("KiCad %s not found; set KICAD_CLI / KICAD_SYMBOL_DIR / KICAD_FOOTPRINT_DIR" % kind)

def kicad_cli():
    return _first("cli", os.path.isfile)

def symbol_dir():
    return _first("symbols", os.path.isdir)

def footprint_dir():
    return _first("footprints", os.path.isdir)

def run_cli(*args, cwd=None):
    """Run kicad-cli with args; raise with stdout+stderr on failure."""
    proc = subprocess.run([kicad_cli(), *args], cwd=cwd, capture_output=True, text=True)
    if proc.returncode != 0:
        raise RuntimeError("kicad-cli %s failed (%d):\n%s\n%s" % (" ".join(args), proc.returncode, proc.stdout, proc.stderr))
    return proc
```

- [ ] **Step 4: Write cli.py and scripts/hardware.sh**

```python
# hardware/dryer_board/cli.py
"""python -m dryer_board <command>. Commands are added by later tasks; keep this table in step."""
import sys, unittest, os
from . import kicad_env

def cmd_test(_args):
    suite = unittest.defaultTestLoader.discover(os.path.join(kicad_env.REPO, "hardware", "tests"),
                                                top_level_dir=os.path.join(kicad_env.REPO, "hardware"))
    result = unittest.TextTestRunner(verbosity=1).run(suite)
    return 0 if result.wasSuccessful() else 1

def cmd_env(_args):
    print("kicad-cli:", kicad_env.kicad_cli())
    print("symbols:  ", kicad_env.symbol_dir())
    print("footprints:", kicad_env.footprint_dir())
    print("python:   ", sys.executable, sys.version.split()[0])
    return 0

COMMANDS = {"test": cmd_test, "env": cmd_env}

def main(argv):
    if len(argv) < 2 or argv[1] not in COMMANDS:
        print("usage: python -m dryer_board <%s>" % "|".join(sorted(COMMANDS)))
        return 2
    return COMMANDS[argv[1]](argv[2:])

if __name__ == "__main__":
    sys.exit(main(sys.argv))
```

```python
# hardware/dryer_board/__main__.py
import sys
from .cli import main
sys.exit(main(sys.argv))
```

```bash
#!/usr/bin/env bash
# scripts/hardware.sh — run the board generator with KiCad's own Python.
#   scripts/hardware.sh env|test|generate|route|check|export
# KiCad's bundled interpreter has pcbnew; a plain python3 does not. In the
# kicad/kicad Docker image (CI) python3 is that interpreter.
set -euo pipefail
cd "$(dirname "$0")/.."
PY="${KICAD_PYTHON:-}"
if [[ -z "$PY" ]]; then
  for c in /Applications/KiCad/KiCad.app/Contents/Frameworks/Python.framework/Versions/Current/bin/python3 /usr/bin/python3; do
    if [[ -x "$c" ]] && "$c" -c 'import pcbnew' 2>/dev/null; then PY="$c"; break; fi
  done
fi
[[ -n "$PY" ]] || { echo "no Python with pcbnew found; install KiCad or set KICAD_PYTHON" >&2; exit 1; }
export PYTHONPATH="hardware${PYTHONPATH:+:$PYTHONPATH}"
exec "$PY" -m dryer_board "$@" 2> >(grep -v 'assert ""traits"" failed' >&2)
```

The `grep -v` hides one harmless wx assertion KiCad's Python prints on import outside the GUI.

- [ ] **Step 5: Write hardware/README.md (first version) and gitignore**

```markdown
# Hardware: the controller PCB

Generated from `dryer_board/` (see `docs/superpowers/specs/2026-10-14-pcb-design-kicad-design.md`).

    scripts/hardware.sh env       # where KiCad was found
    scripts/hardware.sh test      # unit tests (KiCad's Python)
    scripts/hardware.sh generate  # schematic, project, board (keeps existing tracks)
    scripts/hardware.sh route     # Freerouting in Docker, imports the result
    scripts/hardware.sh check     # committed files match the model; ERC; DRC
    scripts/hardware.sh export    # fab files to hardware/out/, renders to docs/hardware/

Needs KiCad 10 (`brew install --cask kicad`) and Docker for `route`. No Java.
```

Append `hardware/out/` to `.gitignore`.

- [ ] **Step 6: Run the tests**

Run: `chmod +x scripts/hardware.sh && scripts/hardware.sh test`
Expected: 3 tests OK.

- [ ] **Step 7: Commit**

```bash
git add hardware scripts/hardware.sh .gitignore
git commit -m "Add the hardware generator scaffold and KiCad locator"
```

---

### Task 2: S-expression reader and writer

**Files:**
- Create: `hardware/dryer_board/sexp.py`, `hardware/tests/test_sexp.py`

**Interfaces:**
- Produces: `sexp.parse(text) -> list` (nested lists; atoms are `str`, quoted strings become `Str` instances so they round-trip quoted), `sexp.dump(node, indent=0) -> str`, `sexp.Str(str)`, `sexp.find(node, key) -> first child list whose head == key or None`, `sexp.find_all(node, key) -> list`.

- [ ] **Step 1: Write the failing tests**

```python
# hardware/tests/test_sexp.py
import unittest
from dryer_board import sexp

class Sexp(unittest.TestCase):
    def test_roundtrip_quoted_and_bare(self):
        src = '(pin passive line (at 0 3.81 270) (name "~" (effects (font (size 1.27 1.27)))) (number "1"))'
        tree = sexp.parse(src)
        self.assertEqual(tree[0], "pin")
        self.assertEqual(sexp.find(tree, "number")[1], "1")
        self.assertIsInstance(sexp.find(tree, "number")[1], sexp.Str)
        self.assertEqual(sexp.dump(tree, indent=None), src)

    def test_escapes(self):
        tree = sexp.parse(r'(property "Value" "1 \"kΩ\" x")')
        self.assertEqual(tree[2], '1 "kΩ" x')
        self.assertEqual(sexp.dump(tree, indent=None), r'(property "Value" "1 \"kΩ\" x")')

    def test_find_all(self):
        tree = sexp.parse('(a (pin 1) (pin 2) (x))')
        self.assertEqual([p[1] for p in sexp.find_all(tree, "pin")], ["1", "2"])
        self.assertIsNone(sexp.find(tree, "nope"))
```

- [ ] **Step 2: Run to see failure**

Run: `scripts/hardware.sh test`
Expected: `ImportError` for `sexp`.

- [ ] **Step 3: Implement**

```python
# hardware/dryer_board/sexp.py
"""Minimal S-expression support for KiCad files. Quoted strings parse to Str so they
are written back quoted; bare tokens stay str."""
import re

class Str(str):
    """A token that was (and must be) double-quoted."""

_TOKEN = re.compile(r'\(|\)|"(?:[^"\\]|\\.)*"|[^\s()"]+')

def _unescape(s):
    return s.replace('\\"', '"').replace("\\\\", "\\")

def _escape(s):
    return s.replace("\\", "\\\\").replace('"', '\\"')

def parse(text):
    stack = [[]]
    for tok in _TOKEN.findall(text):
        if tok == "(":
            stack.append([])
        elif tok == ")":
            done = stack.pop()
            stack[-1].append(done)
        elif tok.startswith('"'):
            stack[-1].append(Str(_unescape(tok[1:-1])))
        else:
            stack[-1].append(tok)
    if len(stack) != 1 or len(stack[0]) != 1:
        raise ValueError("unbalanced S-expression")
    return stack[0][0]

def _atom(a):
    if isinstance(a, Str):
        return '"%s"' % _escape(a)
    return a

def dump(node, indent=0):
    """indent=None gives one line; an int gives KiCad-like one-child-per-line output."""
    if not isinstance(node, list):
        return _atom(node)
    if indent is None or not any(isinstance(c, list) for c in node):
        return "(" + " ".join(dump(c, None) for c in node) + ")"
    pad = "\t" * (indent + 1)
    head = [dump(c, None) for c in node if not isinstance(c, list)]
    kids = [pad + dump(c, indent + 1) for c in node if isinstance(c, list)]
    return "(" + " ".join(head) + "\n" + "\n".join(kids) + "\n" + "\t" * indent + ")"

def find(node, key):
    for c in node:
        if isinstance(c, list) and c and c[0] == key:
            return c
    return None

def find_all(node, key):
    return [c for c in node if isinstance(c, list) and c and c[0] == key]
```

- [ ] **Step 4: Run the tests** — Expected: all OK.

- [ ] **Step 5: Commit**

```bash
git add hardware/dryer_board/sexp.py hardware/tests/test_sexp.py
git commit -m "Add an S-expression reader and writer for KiCad files"
```

---

### Task 3: The circuit model

**Files:**
- Create: `hardware/dryer_board/pinmap.py`, `hardware/dryer_board/circuit.py`, `hardware/tests/test_circuit.py`

**Interfaces:**
- Produces: `pinmap.FUNCTIONS: dict[str, tuple[int, int]]` function → (header, position); `pinmap.POSITION_GPIO: dict[str, dict[tuple[int,int], int]]` board id (`"s2"`, `"c6"`) → position → GPIO.
- Produces: `circuit.REVISION = "A"`, `circuit.PROJECT = "dryer-controller"`, `circuit.Part` dataclass `(ref, value, symbol, footprint, pins: dict[str,str], lcsc="", hand_fit=False, description="")`, `circuit.PARTS: list[Part]`, `circuit.MAINS_NETS`, `circuit.NETCLASSES`, `circuit.NC = "NC"`, `circuit.by_ref(ref) -> Part`, `circuit.nets() -> dict[str, list[tuple[str,str]]]` net → [(ref, pad)], `circuit.check() -> list[str]` (invariant violations, empty when sound).

- [ ] **Step 1: Write the failing tests**

```python
# hardware/tests/test_circuit.py
import unittest
from dryer_board import circuit, pinmap

class Circuit(unittest.TestCase):
    def test_invariants_hold(self):
        self.assertEqual(circuit.check(), [])

    def test_refs_unique_and_pins_named(self):
        refs = [p.ref for p in circuit.PARTS]
        self.assertEqual(len(refs), len(set(refs)))
        for p in circuit.PARTS:
            for pad, net in p.pins.items():
                self.assertTrue(net, "%s pad %s has an empty net" % (p.ref, pad))

    def test_relay_contacts(self):
        for ref, lsw in (("K1", "L_SW_A"), ("K2", "L_SW_B")):
            k = circuit.by_ref(ref)
            self.assertEqual(k.pins["1"], "L_FUSED")   # COM
            self.assertEqual(k.pins["3"], lsw)         # NO -> heater
            self.assertEqual(k.pins["4"], circuit.NC)  # NC: no copper
            self.assertEqual(k.pins["2"], "+5V")       # coil
            self.assertIn(k.pins["5"], ("COIL_A", "COIL_B"))

    def test_heater_interlock_wiring(self):
        """Each heater has its own relay, driver and header pins; nothing shared but L_FUSED and N."""
        nets = circuit.nets()
        self.assertEqual(sorted(r for r, _ in nets["L_SW_A"]), ["J_MAINS", "K1"])
        self.assertEqual(sorted(r for r, _ in nets["L_SW_B"]), ["J_MAINS", "K2"])
        self.assertEqual(sorted(r for r, _ in nets["L_FUSED"]), ["F1", "J_MAINS", "K1", "K2"])
        self.assertEqual(sorted(r for r, _ in nets["L_IN"]), ["F1", "J_MAINS"])

    def test_sockets_follow_pinmap(self):
        j16, j12 = circuit.by_ref("J_ESP16"), circuit.by_ref("J_ESP12")
        self.assertEqual(j12.pins[str(pinmap.FUNCTIONS["heater_a"][1])], "HTR_A")
        self.assertEqual(j12.pins[str(pinmap.FUNCTIONS["fan"][1])], "FAN")
        self.assertEqual(j16.pins[str(pinmap.FUNCTIONS["onewire"][1])], "OW_DQ")
        self.assertEqual(j16.pins[str(pinmap.FUNCTIONS["lcd_cs"][1])], "LCD_CS")
        for pos in (9, 10, 11, 12, 1, 2):
            self.assertEqual(j12.pins[str(pos)], circuit.NC, "12-pin %d must be free" % pos)
        for pos in (1, 3, 6, 7, 14, 15, 16):
            self.assertEqual(j16.pins[str(pos)], circuit.NC, "16-pin %d must be free" % pos)
        self.assertEqual(j12.pins["3"], "VBUS")
        self.assertEqual(j16.pins["2"], "+3V3")
        self.assertEqual(j16.pins["4"], "GND")

    def test_polarity(self):
        for p in circuit.PARTS:
            if p.symbol == "Device:C_Polarized":
                self.assertIn(p.pins["1"], ("+24V", "+5V"), p.ref)
                self.assertEqual(p.pins["2"], "GND", p.ref)
            if p.symbol == "Device:LED":
                self.assertTrue(p.pins["2"].startswith("LED_"), "%s anode must go to its resistor" % p.ref)
                self.assertIn(p.pins["1"], ("GND", "COIL_A", "COIL_B", "SW_VA", "SW_VB", "SW_FAN"), p.ref)
            if p.symbol in ("Device:D", "Device:D_Schottky") and p.ref in ("D1", "D2"):
                self.assertEqual(p.pins["1"], "+5V")   # flyback cathode to the coil supply
            if p.ref in ("D5", "D6", "D7"):
                self.assertEqual(p.pins["1"], "+24V")

    def test_mains_nets_declared(self):
        nets = circuit.nets()
        for n in circuit.MAINS_NETS:
            self.assertIn(n, nets)
        for n in circuit.MAINS_NETS:
            for ref, _ in nets[n]:
                self.assertIn(ref, ("J_MAINS", "F1", "K1", "K2"), "%s touches mains net %s" % (ref, n))

    def test_every_part_has_catalogue_status(self):
        for p in circuit.PARTS:
            if p.symbol.startswith("Mechanical:") or p.symbol.startswith("power:") or p.symbol == "Connector:TestPoint":
                continue
            self.assertTrue(p.lcsc or p.hand_fit, "%s needs an LCSC number or hand_fit" % p.ref)
```

The last test fails until Task 15 fills the LCSC numbers; mark it `@unittest.expectedFailure` now and remove the decorator in Task 15.

- [ ] **Step 2: Run to see failure** — Expected: ImportError.

- [ ] **Step 3: Write pinmap.py**

```python
# hardware/dryer_board/pinmap.py
"""Header position -> function, the wiring the main board commits to. The GPIO behind a
position differs per Thing Plus and lives in esphome/packages/board-*.yaml; tests/test_pinmap.py
holds both against each other. Source: docs/pinout-verification.md."""

# function: (header pin count, position counted from the USB end)
FUNCTIONS = {
    "usb_5v":    (12, 3),
    "heater_a":  (12, 4),
    "heater_b":  (12, 5),
    "valve_a":   (12, 6),
    "valve_b":   (12, 7),
    "fan":       (12, 8),
    "i2c_scl":   (12, 11),   # Qwiic; not wired on the main board
    "i2c_sda":   (12, 12),   # Qwiic; not wired on the main board
    "3v3":       (16, 2),
    "gnd":       (16, 4),
    "lcd_bl":    (16, 5),
    "lcd_rst":   (16, 8),
    "lcd_dc":    (16, 9),
    "lcd_cs":    (16, 10),
    "spi_clk":   (16, 11),
    "spi_mosi":  (16, 12),
    "onewire":   (16, 13),
}

# Positions that must stay unconnected because a board gives them a job.
RESERVED = {(12, 9): "C6 RGB LED data", (12, 10): "C6 boot strap GPIO15",
            (16, 15): "C6 UART0 TX", (16, 16): "C6 BOOT strap GPIO9",
            (16, 1): "ESP reset", (12, 2): "LDO enable", (12, 1): "battery"}

# position -> GPIO, per board, from docs/pinout-verification.md
POSITION_GPIO = {
    "s2": {(16, 5): 17, (16, 8): 9, (16, 9): 7, (16, 10): 5, (16, 11): 36, (16, 12): 35, (16, 13): 37,
           (12, 4): 13, (12, 5): 12, (12, 6): 11, (12, 7): 10, (12, 8): 8, (12, 11): 2, (12, 12): 1},
    "c6": {(16, 5): 0, (16, 8): 3, (16, 9): 4, (16, 10): 5, (16, 11): 19, (16, 12): 20, (16, 13): 21,
           (12, 4): 18, (12, 5): 22, (12, 6): 11, (12, 7): 10, (12, 8): 8, (12, 11): 7, (12, 12): 6},
}

# firmware substitution name -> function
SUBSTITUTIONS = {"pin_heater_a": "heater_a", "pin_heater_b": "heater_b", "pin_valve_a": "valve_a",
                 "pin_valve_b": "valve_b", "pin_fan": "fan", "pin_i2c_sda": "i2c_sda", "pin_i2c_scl": "i2c_scl",
                 "pin_onewire": "onewire", "pin_spi_clk": "spi_clk", "pin_spi_mosi": "spi_mosi",
                 "pin_lcd_cs": "lcd_cs", "pin_lcd_dc": "lcd_dc", "pin_lcd_rst": "lcd_rst", "pin_lcd_bl": "lcd_bl"}
```

- [ ] **Step 4: Write circuit.py**

Symbols and footprints below were checked against KiCad 10.0.6's stock libraries; pin numbers come from the symbol files (relay: 1 COM, 2/5 coil, 3 NO, 4 NC; MMBT2222A: 1 B, 2 E, 3 C; Q_NMOS_GSD: 1 G, 2 S, 3 D; LED and diodes: 1 K, 2 A; SW_SPDT: 2 is the common pole; TSR_1-2450: 1 Vin, 2 GND, 3 Vout; C_Polarized: 1 is +). LCSC numbers are filled in Task 15; three parts are marked for a footprint decision there (SW1, F1, J_SENS).

```python
# hardware/dryer_board/circuit.py
"""The circuit: one table of parts, their pins and the nets they join. Everything
(schematic, board, BOM, position file) derives from this file. Values and reasoning:
docs/hardware.md and the spec."""
from dataclasses import dataclass, field
from typing import Dict, List, Tuple
from . import pinmap

REVISION = "A"
PROJECT = "dryer-controller"
TITLE = "ESP32 desiccant dryer controller"
NC = "NC"

MAINS_NETS = ["L_IN", "L_FUSED", "L_SW_A", "L_SW_B", "N"]

# name -> (track width mm, clearance mm, via diameter mm, via drill mm, net name patterns)
NETCLASSES = {
    "Default": (0.3, 0.2, 0.6, 0.3, []),
    "MAINS":   (1.5, 1.0, 1.2, 0.6, MAINS_NETS),
    "P24":     (0.8, 0.2, 0.8, 0.4, ["+24V*", "SW_VA", "SW_VB", "SW_FAN"]),
    "P5":      (0.8, 0.2, 0.8, 0.4, ["+5V", "V5_D", "VBUS", "COIL_A", "COIL_B"]),
}

@dataclass(frozen=True)
class Part:
    ref: str
    value: str
    symbol: str          # "Library:Name" in KiCad's stock symbol libraries
    footprint: str       # "Library:Name" in KiCad's stock footprint libraries (or dryer:Name, local)
    pins: Dict[str, str] # pad/pin number -> net name, or NC
    lcsc: str = ""       # LCSC part number, filled by Task 15
    hand_fit: bool = False
    description: str = ""

def _r(ref, value, a, b, lcsc="", desc=""):
    return Part(ref, value, "Device:R", "Resistor_SMD:R_0805_2012Metric", {"1": a, "2": b}, lcsc, False, desc)

def _c(ref, value, a, b, lcsc="", desc=""):
    return Part(ref, value, "Device:C", "Capacitor_SMD:C_0805_2012Metric", {"1": a, "2": b}, lcsc, False, desc)

def _led(ref, colour, k, a, lcsc=""):
    return Part(ref, "LED " + colour, "Device:LED", "LED_SMD:LED_0805_2012Metric", {"1": k, "2": a}, lcsc, False, colour + " 0805")

def _s1m(ref, k, a, lcsc=""):
    return Part(ref, "S1M", "Device:D", "Diode_SMD:D_SMA", {"1": k, "2": a}, lcsc, False, "1 A 1000 V flyback, SMA")

def _npn(ref, base, emitter, collector, lcsc=""):
    return Part(ref, "MMBT2222A", "Transistor_BJT:MMBT2222A", "Package_TO_SOT_SMD:SOT-23",
                {"1": base, "2": emitter, "3": collector}, lcsc, False, "relay driver")

def _nfet(ref, gate, source, drain, lcsc=""):
    return Part(ref, "SI2308", "Transistor_FET:Q_NMOS_GSD", "Package_TO_SOT_SMD:SOT-23",
                {"1": gate, "2": source, "3": drain}, lcsc, False, "60 V logic-level N-MOSFET, SOT-23")

def _socket_pins(header):
    """Net for every position of the 16- or 12-pin socket from pinmap."""
    net_for = {"usb_5v": "VBUS", "heater_a": "HTR_A", "heater_b": "HTR_B", "valve_a": "VLV_A",
               "valve_b": "VLV_B", "fan": "FAN", "3v3": "+3V3", "gnd": "GND", "lcd_bl": "LCD_BL",
               "lcd_rst": "LCD_RST", "lcd_dc": "LCD_DC", "lcd_cs": "LCD_CS", "spi_clk": "SPI_CLK",
               "spi_mosi": "SPI_MOSI", "onewire": "OW_DQ"}
    pins = {str(i): NC for i in range(1, header + 1)}
    for fn, (hdr, pos) in pinmap.FUNCTIONS.items():
        if hdr == header and fn in net_for:
            pins[str(pos)] = net_for[fn]
    return pins

PARTS: List[Part] = [
    # ESP sockets (female headers). Rotated 180 on the board so pin 1 is at the USB end.
    Part("J_ESP16", "Thing Plus 16-pin", "Connector_Generic:Conn_01x16",
         "Connector_PinSocket_2.54mm:PinSocket_1x16_P2.54mm_Vertical", _socket_pins(16), description="ESP socket, 16-pin row"),
    Part("J_ESP12", "Thing Plus 12-pin", "Connector_Generic:Conn_01x12",
         "Connector_PinSocket_2.54mm:PinSocket_1x12_P2.54mm_Vertical", _socket_pins(12), description="ESP socket, 12-pin row"),

    # 24 V input: plug -> PPTC -> Schottky -> bulk -> LED
    Part("J_24V", "24 V in", "Connector_Generic:Conn_01x02",
         "Connector_Phoenix_MSTB:PhoenixContact_MSTBVA_2,5_2-G-5,08_1x02_P5.08mm_Vertical", {"1": "+24V_RAW", "2": "GND"},
         description="24 V supply, 2-pin 5.08 mm pluggable header"),
    Part("F2", "PPTC 1.1 A 30 V", "Device:Polyfuse", "Fuse:Fuse_1812_4532Metric", {"1": "+24V_RAW", "2": "+24V_F"},
         description="resettable fuse on the 24 V input (F-03, G-11)"),
    Part("D11", "SS34", "Device:D_Schottky", "Diode_SMD:D_SMA", {"1": "+24V", "2": "+24V_F"},
         description="reverse-polarity series Schottky"),
    Part("C1", "100u 50V", "Device:C_Polarized", "Capacitor_SMD:CP_Elec_8x10.5", {"1": "+24V", "2": "GND"},
         description="24 V bulk"),
    _r("R16", "10k", "+24V", "LED_24V_R"),
    _led("D12", "green", "GND", "LED_24V_R"),

    # 5 V: fixed module in the TSR-1 / 78xx footprint
    Part("U1", "K7805-1000R3", "Converter_DCDC:TSR_1-2450", "Converter_DCDC:Converter_DCDC_TRACO_TSR-1_THT",
         {"1": "+24V", "2": "GND", "3": "+5V"}, description="fixed 5 V 1 A switching module, 78xx pinout"),
    _c("C2", "10u 50V", "+24V", "GND", desc="module input, per datasheet"),
    _c("C3", "22u 10V", "+5V", "GND", desc="module output, per datasheet"),
    Part("C4", "100u 16V", "Device:C_Polarized", "Capacitor_SMD:CP_Elec_6.3x7.7", {"1": "+5V", "2": "GND"},
         description="5 V bulk for the relay coils"),
    _r("R17", "2.2k", "+5V", "LED_5V_R"),
    _led("D13", "green", "GND", "LED_5V_R"),

    # USB pin feed: 5 V -> Schottky -> slide switch -> ESP 12-pin 3
    Part("D14", "SS34", "Device:D_Schottky", "Diode_SMD:D_SMA", {"1": "V5_D", "2": "+5V"},
         description="blocks a USB host back-feeding the 5 V bus"),
    Part("SW1", "SW-USB", "Switch:SW_SPDT", "Button_Switch_THT:SW_Slide_SPDT_Straight_CK_OS102011MS2Q",
         {"1": "VBUS", "2": "V5_D", "3": NC}, description="OFF before any USB-C cable; footprint pinned in Task 15"),

    # Relay stage A (heater A): 1k series, 1k pulldown, MMBT2222A, S1M flyback, LED, Songle relay
    _r("R1", "1k", "HTR_A", "BASE_A"), _r("R2", "1k", "BASE_A", "GND"),
    _npn("Q1", "BASE_A", "GND", "COIL_A"),
    _s1m("D1", "+5V", "COIL_A"),
    _r("R3", "2.2k", "+5V", "LED_HA_R"), _led("D3", "red", "COIL_A", "LED_HA_R"),
    Part("K1", "SRD-05VDC-SL-C", "Relay:SANYOU_SRD_Form_C", "Relay_THT:Relay_SPDT_SANYOU_SRD_Series_Form_C",
         {"1": "L_FUSED", "2": "+5V", "5": "COIL_A", "3": "L_SW_A", "4": NC}, "C35449", False, "heater A relay"),
    # Relay stage B (heater B)
    _r("R4", "1k", "HTR_B", "BASE_B"), _r("R5", "1k", "BASE_B", "GND"),
    _npn("Q2", "BASE_B", "GND", "COIL_B"),
    _s1m("D2", "+5V", "COIL_B"),
    _r("R6", "2.2k", "+5V", "LED_HB_R"), _led("D4", "red", "COIL_B", "LED_HB_R"),
    Part("K2", "SRD-05VDC-SL-C", "Relay:SANYOU_SRD_Form_C", "Relay_THT:Relay_SPDT_SANYOU_SRD_Series_Form_C",
         {"1": "L_FUSED", "2": "+5V", "5": "COIL_B", "3": "L_SW_B", "4": NC}, "C35449", False, "heater B relay"),

    # MOSFET stages: valve A, valve B, fan (100 R gate, 10k pulldown, S1M flyback, LED from 24 V)
    _r("R7", "100", "VLV_A", "GATE_A"), _r("R8", "10k", "GATE_A", "GND"),
    _nfet("Q3", "GATE_A", "GND", "SW_VA"), _s1m("D5", "+24V", "SW_VA"),
    _r("R9", "10k", "+24V", "LED_VA_R"), _led("D8", "yellow", "SW_VA", "LED_VA_R"),
    _r("R10", "100", "VLV_B", "GATE_B"), _r("R11", "10k", "GATE_B", "GND"),
    _nfet("Q4", "GATE_B", "GND", "SW_VB"), _s1m("D6", "+24V", "SW_VB"),
    _r("R12", "10k", "+24V", "LED_VB_R"), _led("D9", "yellow", "SW_VB", "LED_VB_R"),
    _r("R13", "100", "FAN", "GATE_C"), _r("R14", "10k", "GATE_C", "GND"),
    _nfet("Q5", "GATE_C", "GND", "SW_FAN"), _s1m("D7", "+24V", "SW_FAN"),
    _r("R15", "10k", "+24V", "LED_FAN_R"), _led("D10", "yellow", "SW_FAN", "LED_FAN_R"),

    # Mains: fuse and the single 8-pin plug
    Part("F1", "T 3.15 A 5x20", "Device:Fuse", "Fuse:Fuseholder_Clip-5x20mm_Littelfuse_111_Inline_P20.00x5.00mm_D1.05mm_Horizontal",
         {"1": "L_IN", "2": "L_FUSED"}, description="covered holder chosen in Task 15; clips are the stand-in footprint"),
    Part("J_MAINS", "120 VAC", "Connector_Generic:Conn_01x08",
         "Connector_Phoenix_MSTB:PhoenixContact_MSTBA_2,5_8-G-5,08_1x08_P5.08mm_Horizontal",
         {"1": "L_IN", "2": "N", "3": "L_SW_A", "4": "N", "5": "L_SW_B", "6": "N", "7": "L_FUSED", "8": "N"},
         description="L in, N in, heater A L-sw/N, heater B L-sw/N, PSU L (fused)/N; 300 V rated"),

    # 24 V loads and sensors
    Part("J_LOADS", "valves + fan", "Connector_Generic:Conn_01x06",
         "Connector_Phoenix_MSTB:PhoenixContact_MSTBVA_2,5_6-G-5,08_1x06_P5.08mm_Vertical",
         {"1": "+24V", "2": "SW_VA", "3": "+24V", "4": "SW_VB", "5": "+24V", "6": "SW_FAN"},
         description="valve A, valve B, fan: 24+ and SW each"),
    Part("J_SENS", "DS18B20 x3", "Connector_Generic:Conn_01x09",
         "Connector_Phoenix_MC:PhoenixContact_MCV_1,5_9-G-3.5_1x09_P3.50mm_Vertical",
         {"1": "+3V3", "2": "OW_DQ", "3": "GND", "4": "+3V3", "5": "OW_DQ", "6": "GND", "7": "+3V3", "8": "OW_DQ", "9": "GND"},
         description="three 3V3/DQ/GND triples, 3.5 mm pluggable"),
    _r("R18", "5.1k", "+3V3", "OW_DQ", desc="1-wire pullup"),
    _c("C5", "100n", "+3V3", "GND", desc="3V3 at the sensor header"),
    _c("C6", "10u 10V", "+3V3", "GND", desc="3V3 at the sensor header"),
    Part("J_DISP", "ST7789 240x240", "Connector_Generic:Conn_01x08",
         "Connector_PinHeader_2.54mm:PinHeader_1x08_P2.54mm_Vertical",
         {"1": "GND", "2": "+3V3", "3": "SPI_CLK", "4": "SPI_MOSI", "5": "LCD_RST", "6": "LCD_DC", "7": "LCD_CS", "8": "LCD_BL"},
         description="GND 3V3 SCL SDA RES DC CS BLK"),

    # Test points, mounting holes, power flags
    Part("TP1", "GND", "Connector:TestPoint", "TestPoint:TestPoint_Pad_D1.5mm", {"1": "GND"}),
    Part("TP2", "3V3", "Connector:TestPoint", "TestPoint:TestPoint_Pad_D1.5mm", {"1": "+3V3"}),
    Part("TP3", "5V", "Connector:TestPoint", "TestPoint:TestPoint_Pad_D1.5mm", {"1": "+5V"}),
    Part("TP4", "24V", "Connector:TestPoint", "TestPoint:TestPoint_Pad_D1.5mm", {"1": "+24V"}),
    Part("TP5", "HTR_A", "Connector:TestPoint", "TestPoint:TestPoint_Pad_D1.5mm", {"1": "HTR_A"}),
    Part("TP6", "HTR_B", "Connector:TestPoint", "TestPoint:TestPoint_Pad_D1.5mm", {"1": "HTR_B"}),
    Part("TP7", "VLV_A", "Connector:TestPoint", "TestPoint:TestPoint_Pad_D1.5mm", {"1": "VLV_A"}),
    Part("TP8", "VLV_B", "Connector:TestPoint", "TestPoint:TestPoint_Pad_D1.5mm", {"1": "VLV_B"}),
    Part("TP9", "FAN", "Connector:TestPoint", "TestPoint:TestPoint_Pad_D1.5mm", {"1": "FAN"}),
    Part("H1", "M3", "Mechanical:MountingHole", "MountingHole:MountingHole_3.2mm_M3", {}),
    Part("H2", "M3", "Mechanical:MountingHole", "MountingHole:MountingHole_3.2mm_M3", {}),
    Part("H3", "M3", "Mechanical:MountingHole", "MountingHole:MountingHole_3.2mm_M3", {}),
    Part("H4", "M3", "Mechanical:MountingHole", "MountingHole:MountingHole_3.2mm_M3", {}),
    Part("#FLG1", "PWR_FLAG", "power:PWR_FLAG", "", {"1": "+24V"}),
    Part("#FLG2", "PWR_FLAG", "power:PWR_FLAG", "", {"1": "GND"}),
    Part("#FLG3", "PWR_FLAG", "power:PWR_FLAG", "", {"1": "+3V3"}),
]

def by_ref(ref):
    for p in PARTS:
        if p.ref == ref:
            return p
    raise KeyError(ref)

def nets():
    out = {}
    for p in PARTS:
        for pad, net in sorted(p.pins.items()):
            if net != NC:
                out.setdefault(net, []).append((p.ref, pad))
    return out

def board_parts():
    """Parts that exist on the PCB (everything with a footprint)."""
    return [p for p in PARTS if p.footprint]

def check():
    """Invariants the table must satisfy. Returns a list of violations."""
    errs = []
    n = nets()
    for net, pads in n.items():
        if len(pads) < 2:
            errs.append("net %s has one connection: %s" % (net, pads))
    for hdr, pos in pinmap.RESERVED:
        ref = "J_ESP16" if hdr == 16 else "J_ESP12"
        if by_ref(ref).pins[str(pos)] != NC:
            errs.append("%s position %d is reserved (%s)" % (ref, pos, pinmap.RESERVED[(hdr, pos)]))
    for k in ("K1", "K2"):
        if by_ref(k).pins["4"] != NC:
            errs.append("%s NC contact must stay unconnected" % k)
    for net in MAINS_NETS:
        for ref, _ in n.get(net, []):
            if ref not in ("J_MAINS", "F1", "K1", "K2"):
                errs.append("mains net %s reaches %s" % (net, ref))
    return errs
```

- [ ] **Step 5: Run the tests** — Expected: all OK except the expected failure on catalogue status.

- [ ] **Step 6: Commit**

```bash
git add hardware/dryer_board/pinmap.py hardware/dryer_board/circuit.py hardware/tests/test_circuit.py
git commit -m "Describe the controller board as a parts and nets table"
```

---

### Task 4: Pin-map guard between firmware and hardware

**Files:**
- Create: `tests/test_pinmap.py`
- Modify: `.github/workflows/build.yml` (lint-config job: run the test), `tests/README.md` (one paragraph)

**Interfaces:**
- Consumes: `hardware/dryer_board/pinmap.py` (`FUNCTIONS`, `POSITION_GPIO`, `SUBSTITUTIONS`), `esphome/packages/board-s2.yaml`, `board-c6.yaml`.

- [ ] **Step 1: Write the test (it is the deliverable; it must pass against today's packages)**

```python
#!/usr/bin/env python3
"""The main board is wired by header position; each board package names the GPIO behind
each position. This holds the two against each other so neither can drift. Plain python3,
no PyYAML: the substitutions are parsed with a regex."""
import os, re, sys, unittest

REPO = os.path.dirname(os.path.dirname(os.path.abspath(__file__)))
sys.path.insert(0, os.path.join(REPO, "hardware"))
from dryer_board import pinmap  # noqa: E402

def substitutions(path):
    """pin_* -> GPIO number from a board package. Handles `pin_x: GPIO8` and the nested
    `pin_x:\n    number: GPIO8` form."""
    text = open(path, encoding="utf-8").read()
    out = {}
    for m in re.finditer(r"^  (pin_\w+):(?:[ \t]+GPIO(\d+)|\s*\n\s+number:\s*GPIO(\d+))", text, re.M):
        out[m.group(1)] = int(m.group(2) or m.group(3))
    return out

class PinMap(unittest.TestCase):
    def check(self, board, path):
        subs = substitutions(path)
        for sub, fn in pinmap.SUBSTITUTIONS.items():
            self.assertIn(sub, subs, "%s missing from %s" % (sub, path))
            pos = pinmap.FUNCTIONS[fn]
            self.assertEqual(subs[sub], pinmap.POSITION_GPIO[board][pos],
                             "%s: %s is GPIO%d but position %s carries GPIO%d" % (board, sub, subs[sub], pos, pinmap.POSITION_GPIO[board][pos]))
        self.assertEqual(set(subs), set(pinmap.SUBSTITUTIONS), "substitution list changed; update pinmap.py")

    def test_s2(self):
        self.check("s2", os.path.join(REPO, "esphome", "packages", "board-s2.yaml"))

    def test_c6(self):
        self.check("c6", os.path.join(REPO, "esphome", "packages", "board-c6.yaml"))

    def test_reserved_positions_have_no_function(self):
        for pos in pinmap.RESERVED:
            self.assertNotIn(pos, pinmap.FUNCTIONS.values())

if __name__ == "__main__":
    unittest.main()
```

- [ ] **Step 2: Run it**

Run: `python3 tests/test_pinmap.py -v`
Expected: 3 tests OK. If `test_s2` fails on a GPIO, the regex or `POSITION_GPIO` is wrong, not the firmware: fix the test side.

- [ ] **Step 3: Add to CI**

In `.github/workflows/build.yml`, lint-config job, after "Test the release manifest script":

```yaml
      - name: Hold the firmware pin map against the hardware pin map
        run: python3 tests/test_pinmap.py
```

Add to `tests/README.md` under the runners list: "`tests/test_pinmap.py` holds `esphome/packages/board-*.yaml` against `hardware/dryer_board/pinmap.py` (the PCB's header-position wiring); it runs in the `lint-config` job and in `hardware.yml`."

- [ ] **Step 4: Commit**

```bash
git add tests/test_pinmap.py tests/README.md .github/workflows/build.yml
git commit -m "Hold the firmware pin substitutions against the board's pin map"
```

---

### Task 5: Stock library access: symbols, footprints, pad numbers

**Files:**
- Create: `hardware/dryer_board/libs.py`, `hardware/tests/test_libs.py`

**Interfaces:**
- Consumes: `sexp`, `kicad_env.symbol_dir()`, `kicad_env.footprint_dir()`, `circuit.PARTS`.
- Produces: `libs.load_symbol(lib_id) -> list` (the symbol's S-expression, flattened if it `extends` another, renamed to `"Lib:Name"`), `libs.symbol_pins(lib_id) -> dict[str, tuple[float, float, int, str]]` number → (x, y, angle, electrical type) in symbol units (mm, y up), `libs.footprint_path(lib_id) -> str` (the `.pretty` directory; raises if missing), `libs.footprint_pads(lib_id) -> set[str]`.

- [ ] **Step 1: Write the failing tests**

```python
# hardware/tests/test_libs.py
import unittest
from dryer_board import libs, circuit, sexp

class Libs(unittest.TestCase):
    def test_plain_symbol(self):
        pins = libs.symbol_pins("Device:R")
        self.assertEqual(set(pins), {"1", "2"})
        self.assertEqual(pins["1"][:3], (0.0, 3.81, 270))

    def test_extends_is_flattened(self):
        sym = libs.load_symbol("Transistor_BJT:MMBT2222A")
        self.assertEqual(sym[1], "Transistor_BJT:MMBT2222A")
        self.assertIsNone(sexp.find(sym, "extends"))
        pins = libs.symbol_pins("Transistor_BJT:MMBT2222A")
        self.assertEqual({n: p[3] for n, p in pins.items()}, {"1": "input", "2": "passive", "3": "passive"})
        units = [u[1] for u in sexp.find_all(sym, "symbol")]
        self.assertTrue(all(u.startswith("MMBT2222A_") for u in units), units)
        self.assertEqual(sexp.find(sym, "property")[1], "Reference")
        values = [p[2] for p in sexp.find_all(sym, "property") if p[1] == "Value"]
        self.assertEqual(values, ["MMBT2222A"])

    def test_every_part_symbol_and_footprint(self):
        for p in circuit.PARTS:
            pins = libs.symbol_pins(p.symbol)
            self.assertTrue(set(p.pins) <= set(pins), "%s: pins %s not in symbol %s" % (p.ref, set(p.pins) - set(pins), p.symbol))
            if p.footprint:
                pads = libs.footprint_pads(p.footprint)
                self.assertTrue(set(p.pins) <= pads, "%s: pads %s not in footprint %s" % (p.ref, set(p.pins) - pads, p.footprint))

    def test_relay_pad_geometry_matches_songle(self):
        """docs/hardware.md: COM (0,0), coil (2.0, ±6.0), NO/NC (14.2, ±6.0); KiCad's SANYOU pattern is within 0.1 mm."""
        pos = libs.footprint_pad_positions("Relay_THT:Relay_SPDT_SANYOU_SRD_Series_Form_C")
        self.assertAlmostEqual(pos["1"][0], 0.0, delta=0.1); self.assertAlmostEqual(pos["1"][1], 0.0, delta=0.1)
        for pad in ("2", "5"):
            self.assertAlmostEqual(pos[pad][0], 2.0, delta=0.1); self.assertAlmostEqual(abs(pos[pad][1]), 6.0, delta=0.1)
        for pad in ("3", "4"):
            self.assertAlmostEqual(pos[pad][0], 14.2, delta=0.1); self.assertAlmostEqual(abs(pos[pad][1]), 6.0, delta=0.1)
        self.assertGreater(pos["3"][1], 0)   # NO at +y (KiCad y-down); NC at -y
        self.assertLess(pos["4"][1], 0)

    def test_regulator_footprint_pitch(self):
        pos = libs.footprint_pad_positions("Converter_DCDC:Converter_DCDC_TRACO_TSR-1_THT")
        self.assertAlmostEqual(pos["2"][0] - pos["1"][0], 2.54, delta=0.01)
        self.assertAlmostEqual(pos["3"][0] - pos["2"][0], 2.54, delta=0.01)
```

- [ ] **Step 2: Run to see failure** — Expected: ImportError.

- [ ] **Step 3: Implement libs.py**

```python
# hardware/dryer_board/libs.py
"""Read KiCad's stock symbol and footprint libraries. A derived symbol (`extends`) is
flattened the way KiCad embeds it in a schematic: the parent's drawing and pins with the
child's properties, units renamed to the child's name."""
import os, functools
from . import sexp, kicad_env

def split(lib_id):
    lib, name = lib_id.split(":", 1)
    return lib, name

@functools.lru_cache(maxsize=None)
def _library(lib):
    path = os.path.join(kicad_env.symbol_dir(), lib + ".kicad_sym")
    return sexp.parse(open(path, encoding="utf-8").read())

def _raw_symbol(lib, name):
    for node in _library(lib)[1:]:
        if isinstance(node, list) and node and node[0] == "symbol" and node[1] == name:
            return node
    raise KeyError("symbol %s:%s not in the stock libraries" % (lib, name))

def load_symbol(lib_id):
    lib, name = split(lib_id)
    sym = list(_raw_symbol(lib, name))
    ext = sexp.find(sym, "extends")
    if ext:
        parent_name = ext[1]
        parent = list(_raw_symbol(lib, parent_name))
        child_props = {p[1]: p for p in sexp.find_all(sym, "property")}
        merged = []
        seen = set()
        for node in parent:
            if isinstance(node, list) and node and node[0] == "property":
                merged.append(child_props.get(node[1], node)); seen.add(node[1])
            elif isinstance(node, list) and node and node[0] == "symbol":
                unit = list(node); unit[1] = sexp.Str(name + node[1][len(parent_name):]); merged.append(unit)
            else:
                merged.append(node)
        extra = [p for k, p in child_props.items() if k not in seen]
        sym = merged[:2] + extra + merged[2:]
    sym[1] = sexp.Str(lib_id)
    return sym

def symbol_pins(lib_id):
    out = {}
    for unit in sexp.find_all(load_symbol(lib_id), "symbol"):
        for pin in sexp.find_all(unit, "pin"):
            at = sexp.find(pin, "at")
            number = sexp.find(pin, "number")[1]
            out[number] = (float(at[1]), float(at[2]), int(float(at[3])), pin[1])
    return out

def footprint_path(lib_id):
    lib, name = split(lib_id)
    if lib == "dryer":
        base = os.path.join(kicad_env.PROJECT_DIR, "lib", "dryer.pretty")
    else:
        base = os.path.join(kicad_env.footprint_dir(), lib + ".pretty")
    if not os.path.isfile(os.path.join(base, name + ".kicad_mod")):
        raise FileNotFoundError("footprint %s not found under %s" % (lib_id, base))
    return base

@functools.lru_cache(maxsize=None)
def _footprint(lib_id):
    base = footprint_path(lib_id)
    return sexp.parse(open(os.path.join(base, split(lib_id)[1] + ".kicad_mod"), encoding="utf-8").read())

def footprint_pad_positions(lib_id):
    """pad number -> (x, y) mm in the footprint's frame (KiCad: y down). Unnumbered pads are skipped."""
    out = {}
    for pad in sexp.find_all(_footprint(lib_id), "pad"):
        if pad[1] == "":
            continue
        at = sexp.find(pad, "at")
        out[pad[1]] = (float(at[1]), float(at[2]))
    return out

def footprint_pads(lib_id):
    return set(footprint_pad_positions(lib_id))
```

- [ ] **Step 4: Run the tests**

Run: `scripts/hardware.sh test`
Expected: OK. If `test_every_part_symbol_and_footprint` reports a missing footprint, check the name with `ls /Applications/KiCad/KiCad.app/Contents/SharedSupport/footprints/<Lib>.pretty | grep <fragment>` and fix the name in `circuit.py`; do not invent names. The three vertical Phoenix headers (`MSTBVA_2,5_2-G-5,08`, `MSTBVA_2,5_6-G-5,08` in `Connector_Phoenix_MSTB`, `MCV_1,5_9-G-3.5` in `Connector_Phoenix_MC`) were confirmed present in 10.0.6; note the `MSTBVA` spelling.

- [ ] **Step 5: Commit**

```bash
git add hardware/dryer_board/libs.py hardware/tests/test_libs.py
git commit -m "Read stock symbols and footprints, flattening derived symbols"
```

---

### Task 6: Generate the schematic and library tables

**Files:**
- Create: `hardware/dryer_board/schematic.py`, `hardware/tests/test_schematic.py`
- Modify: `hardware/dryer_board/cli.py` (add `generate`, which for now writes only the schematic and tables)

**Interfaces:**
- Consumes: `circuit`, `libs`, `sexp`, `kicad_env`.
- Produces: `schematic.write(project_dir) -> str` (path of the `.kicad_sch`), `schematic.write_lib_tables(project_dir)`, `schematic.netlist_from_kicad(sch_path) -> dict[str, set[tuple[str,str]]]` (nets as `kicad-cli sch export netlist` sees them), `schematic.uuid_for(key) -> str`.

**Layout rules.** One A2 sheet. Parts in `circuit.PARTS` order on a grid of 38.1 mm cells, 10 per row, origin (25.4, 25.4). Each symbol at its cell origin, rotation 0. For every pin: connection point = `(cx + px, cy - py)` (symbol y is up, sheet y is down); a global label with the net name sits exactly there, angled away from the body (pin angle 0 → label 180, 180 → 0, 90 → 270, 270 → 90); an `NC` pin gets a `no_connect` marker instead. Reference text 2.54 mm above the origin, value 2.54 mm below. All coordinates are multiples of 1.27 mm so ERC's off-grid check stays quiet.

- [ ] **Step 1: Write the failing tests**

```python
# hardware/tests/test_schematic.py
import os, tempfile, unittest
from dryer_board import schematic, circuit, kicad_env

class Schematic(unittest.TestCase):
    @classmethod
    def setUpClass(cls):
        cls.dir = tempfile.mkdtemp()
        schematic.write_lib_tables(cls.dir)
        cls.sch = schematic.write(cls.dir)

    def test_deterministic(self):
        a = open(self.sch).read()
        schematic.write(self.dir)
        self.assertEqual(a, open(self.sch).read())

    def test_kicad_sees_the_model_netlist(self):
        got = schematic.netlist_from_kicad(self.sch)
        want = {net: set(pads) for net, pads in circuit.nets().items()}
        for net in want:
            want[net] = {(r, p) for r, p in want[net] if not r.startswith("#")}
        self.assertEqual(got, want)

    def test_erc_clean(self):
        rpt = os.path.join(self.dir, "erc.rpt")
        proc = kicad_env.run_cli("sch", "erc", "--severity-all", "-o", rpt, self.sch)
        text = open(rpt).read()
        self.assertIn("** ERC messages: 0", text, text)
```

- [ ] **Step 2: Run to see failure** — Expected: ImportError.

- [ ] **Step 3: Implement schematic.py**

```python
# hardware/dryer_board/schematic.py
"""Write the schematic as a net-label grid: every symbol in its own cell, a global label on
every pin. KiCad 8 file format (version 20231120), which KiCad 10 reads."""
import os, re, uuid
from . import circuit, libs, sexp, kicad_env

NAMESPACE = uuid.uuid5(uuid.NAMESPACE_URL, "https://github.com/jrytio/desiccant-dryer/hardware")
CELL = 38.1
COLS = 10
ORIGIN = 25.4
ROOT = None  # set in write()

def uuid_for(key):
    return str(uuid.uuid5(NAMESPACE, "dryer/" + key))

def _q(s):
    return '"%s"' % str(s).replace("\\", "\\\\").replace('"', '\\"')

def _prop(name, value, x, y, hide=False, size=1.27):
    h = " (hide yes)" if hide else ""
    return '(property %s %s (at %.2f %.2f 0) (effects (font (size %s %s))%s))' % (_q(name), _q(value), x, y, size, size, h)

def _symbol_instance(part, cx, cy):
    props = [_prop("Reference", part.ref, cx, cy - 2.54), _prop("Value", part.value, cx, cy + 2.54),
             _prop("Footprint", part.footprint, cx, cy, hide=True), _prop("Datasheet", "~", cx, cy, hide=True),
             _prop("LCSC", part.lcsc, cx, cy, hide=True), _prop("Description", part.description, cx, cy, hide=True)]
    if part.hand_fit:
        props.append(_prop("Hand fit", "yes", cx, cy, hide=True))
    pins = " ".join('(pin %s (uuid %s))' % (_q(n), _q(uuid_for(part.ref + "/pin/" + n))) for n in sorted(libs.symbol_pins(part.symbol)))
    in_bom = "no" if part.ref.startswith("#") else "yes"
    return ('(symbol (lib_id %s) (at %.2f %.2f 0) (unit 1) (exclude_from_sim no) (in_bom %s) (on_board yes) (dnp no) (uuid %s) %s %s '
            '(instances (project %s (path %s (reference %s) (unit 1)))))'
            % (_q(part.symbol), cx, cy, in_bom, _q(uuid_for(part.ref)), " ".join(props), pins,
               _q(circuit.PROJECT), _q("/" + ROOT), _q(part.ref)))

_LABEL_ANGLE = {0: 180, 180: 0, 90: 270, 270: 90}

def _label(net, x, y, angle, key):
    return ('(global_label %s (shape input) (at %.2f %.2f %d) (effects (font (size 1.27 1.27)) (justify left)) (uuid %s))'
            % (_q(net), x, y, angle, _q(uuid_for("label/" + key))))

def _no_connect(x, y, key):
    return '(no_connect (at %.2f %.2f) (uuid %s))' % (x, y, _q(uuid_for("nc/" + key)))

def _cell(i):
    return ORIGIN + (i % COLS) * CELL, ORIGIN + (i // COLS) * CELL

def write(project_dir):
    global ROOT
    ROOT = uuid_for("root")
    body, embedded, seen = [], [], set()
    for i, part in enumerate(circuit.PARTS):
        cx, cy = _cell(i)
        if part.symbol not in seen:
            seen.add(part.symbol); embedded.append(sexp.dump(libs.load_symbol(part.symbol), indent=None))
        body.append(_symbol_instance(part, cx, cy))
        pins = libs.symbol_pins(part.symbol)
        for number, (px, py, angle, _etype) in sorted(pins.items()):
            x, y = cx + px, cy - py
            net = part.pins.get(number, circuit.NC)
            key = part.ref + "/" + number
            if net == circuit.NC:
                body.append(_no_connect(x, y, key))
            else:
                body.append(_label(net, x, y, _LABEL_ANGLE[angle % 360], key))
    doc = ('(kicad_sch (version 20231120) (generator "dryer_board") (generator_version "1.0") (uuid %s) (paper "A2")\n'
           '(title_block (title %s) (rev %s) (company "AGPL-3.0, github.com/jrytio/desiccant-dryer"))\n'
           '(lib_symbols %s)\n%s\n(sheet_instances (path "/" (page "1"))))\n'
           % (_q(ROOT), _q(circuit.TITLE), _q(circuit.REVISION), "\n".join(embedded), "\n".join(body)))
    path = os.path.join(project_dir, circuit.PROJECT + ".kicad_sch")
    with open(path, "w", encoding="utf-8") as f:
        f.write(doc)
    return path

def write_lib_tables(project_dir):
    """Project-local tables for the stock libraries the parts use, plus the local footprint
    library. kicad-cli has no global tables in CI, so these are required for ERC and DRC."""
    sym_libs = sorted({libs.split(p.symbol)[0] for p in circuit.PARTS})
    fp_libs = sorted({libs.split(p.footprint)[0] for p in circuit.PARTS if p.footprint and not p.footprint.startswith("dryer:")})
    with open(os.path.join(project_dir, "sym-lib-table"), "w") as f:
        f.write("(sym_lib_table (version 7)\n")
        for lib in sym_libs:
            f.write('  (lib (name "%s") (type "KiCad") (uri "${KICAD10_SYMBOL_DIR}/%s.kicad_sym") (options "") (descr ""))\n' % (lib, lib))
        f.write(")\n")
    with open(os.path.join(project_dir, "fp-lib-table"), "w") as f:
        f.write("(fp_lib_table (version 7)\n")
        for lib in fp_libs:
            f.write('  (lib (name "%s") (type "KiCad") (uri "${KICAD10_FOOTPRINT_DIR}/%s.pretty") (options "") (descr ""))\n' % (lib, lib))
        f.write('  (lib (name "dryer") (type "KiCad") (uri "${KIPRJMOD}/lib/dryer.pretty") (options "") (descr "local footprints"))\n')
        f.write(")\n")
    os.makedirs(os.path.join(project_dir, "lib", "dryer.pretty"), exist_ok=True)

def netlist_from_kicad(sch_path):
    out_path = sch_path + ".net"
    kicad_env.run_cli("sch", "export", "netlist", "--format", "kicadsexpr", "-o", out_path, sch_path)
    tree = sexp.parse(open(out_path, encoding="utf-8").read())
    nets = {}
    for net in sexp.find_all(sexp.find(tree, "nets"), "net"):
        name = sexp.find(net, "name")[1]
        nodes = {(sexp.find(n, "ref")[1], sexp.find(n, "pin")[1]) for n in sexp.find_all(net, "node")}
        nodes = {(r, p) for r, p in nodes if not r.startswith("#")}
        if len(nodes) > 1:
            nets[name] = nodes
    return nets
```

Add to `cli.py`:

```python
def cmd_generate(_args):
    from . import schematic
    os.makedirs(kicad_env.PROJECT_DIR, exist_ok=True)
    schematic.write_lib_tables(kicad_env.PROJECT_DIR)
    print("wrote", schematic.write(kicad_env.PROJECT_DIR))
    return 0
COMMANDS["generate"] = cmd_generate
```

- [ ] **Step 4: Run the tests and fix what ERC reports**

Run: `scripts/hardware.sh test`
Expected: OK. If `test_erc_clean` fails, read the report in the assertion message. Known causes and fixes: a label at an off-grid point means a symbol whose pin offsets are not multiples of 1.27 (check `libs.symbol_pins`); "Input Power pin not driven" means a net with a `power_in` pin and no PWR_FLAG: add a `#FLGn` part on that net in `circuit.py`; "Label connected to only one pin" means a net with a single connection, which `circuit.check()` should already have caught. Nets named by KiCad with a leading "/" are local labels, which this generator never emits.

- [ ] **Step 5: Generate and commit the schematic**

Run: `scripts/hardware.sh generate && ls hardware/dryer-controller`
Expected: `dryer-controller.kicad_sch`, `sym-lib-table`, `fp-lib-table`, `lib/`.

```bash
git add hardware/dryer_board/schematic.py hardware/dryer_board/cli.py hardware/tests/test_schematic.py hardware/dryer-controller
git commit -m "Generate the schematic as a labelled grid from the circuit table"
```

---

### Task 7: Project file and the mains clearance rules

**Files:**
- Create: `hardware/dryer_board/project.py`, `hardware/tests/test_project.py`
- Modify: `hardware/dryer_board/cli.py` (`generate` also writes the project and rules)

**Interfaces:**
- Consumes: `circuit.NETCLASSES`, `circuit.PROJECT`.
- Produces: `project.write(project_dir)` → writes `<project>.kicad_pro` and `<project>.kicad_dru`; `project.RULES` (the `.kicad_dru` text); `project.netclass_patterns() -> list[tuple[str, str]]` (pattern, class).

- [ ] **Step 1: Write the failing tests**

The red/green boards are built directly with `pcbnew`: two parallel tracks, one on `L_IN` (class MAINS) and one on `GND`, 4 mm apart (red) or 8 mm apart (green). DRC must fail the red one with the rule by name and pass the green one. This is the test that proves CI's DRC actually enforces the mains rule.

```python
# hardware/tests/test_project.py
import os, json, tempfile, unittest
import pcbnew
from dryer_board import project, circuit, kicad_env

def _two_track_board(path, gap_mm):
    b = pcbnew.BOARD()
    edge = pcbnew.PCB_SHAPE(b); edge.SetShape(pcbnew.SHAPE_T_RECT)
    edge.SetStart(pcbnew.VECTOR2I_MM(0, 0)); edge.SetEnd(pcbnew.VECTOR2I_MM(60, 40))
    edge.SetLayer(pcbnew.Edge_Cuts); edge.SetWidth(pcbnew.FromMM(0.1)); b.Add(edge)
    for name, y, w in (("L_IN", 10, 1.5), ("GND", 10 + gap_mm, 0.3)):
        net = pcbnew.NETINFO_ITEM(b, name); b.Add(net)
        t = pcbnew.PCB_TRACK(b); t.SetStart(pcbnew.VECTOR2I_MM(10, y)); t.SetEnd(pcbnew.VECTOR2I_MM(50, y))
        t.SetWidth(pcbnew.FromMM(w)); t.SetLayer(pcbnew.F_Cu); t.SetNet(net); b.Add(t)
    pcbnew.SaveBoard(path, b)

class Project(unittest.TestCase):
    def setUp(self):
        self.dir = tempfile.mkdtemp()
        project.write(self.dir)

    def _drc(self, gap):
        pcb = os.path.join(self.dir, circuit.PROJECT + ".kicad_pcb")
        _two_track_board(pcb, gap)
        rpt = os.path.join(self.dir, "drc.rpt")
        proc = kicad_env.run_cli("pcb", "drc", "--severity-error", "-o", rpt, pcb)
        return open(rpt).read()

    def test_red_board_fails_the_mains_rule(self):
        text = self._drc(4.0)
        self.assertIn("rule 'mains to selv'", text, text)

    def test_green_board_passes(self):
        text = self._drc(8.0)
        self.assertIn("** Found 0 DRC violations **", text, text)

    def test_project_json(self):
        pro = json.load(open(os.path.join(self.dir, circuit.PROJECT + ".kicad_pro")))
        names = [c["name"] for c in pro["net_settings"]["classes"]]
        self.assertEqual(names[0], "Default")
        self.assertIn("MAINS", names)
        self.assertIn({"netclass": "MAINS", "pattern": "N"}, pro["net_settings"]["netclass_patterns"])
        self.assertEqual(pro["net_settings"]["meta"]["version"], 5)
```

- [ ] **Step 2: Run to see failure** — Expected: ImportError.

- [ ] **Step 3: Implement project.py**

```python
# hardware/dryer_board/project.py
"""The KiCad project file (netclasses, DRC severities, board rules) and the custom DRC rules.
Net settings use the schema KiCad 10 writes (net_settings meta version 5); an older or
sparser schema is silently ignored by kicad-cli, which is how a rule can fail to apply."""
import json, os
from . import circuit

RULES = """(version 1)
(rule "mains track width"
  (condition "A.NetClass == 'MAINS'")
  (constraint track_width (min 1.5mm)))
(rule "mains to board edge"
  (condition "A.NetClass == 'MAINS'")
  (constraint edge_clearance (min 1mm)))
(rule "mains to selv"
  (condition "A.NetClass == 'MAINS' && B.NetClass != 'MAINS'")
  (constraint clearance (min 6mm)))
(rule "mains to selv at relay pads"
  (condition "A.NetClass == 'MAINS' && B.NetClass != 'MAINS' && A.insideArea('relay_pads')")
  (constraint clearance (min 3.5mm)))
"""

def _class(name, track, clearance, via, drill, priority):
    return {"bus_width": 12, "clearance": clearance, "diff_pair_gap": 0.25, "diff_pair_via_gap": 0.25,
            "diff_pair_width": 0.2, "line_style": 0, "microvia_diameter": 0.3, "microvia_drill": 0.1,
            "name": name, "pcb_color": "rgba(0, 0, 0, 0.000)", "priority": priority,
            "schematic_color": "rgba(0, 0, 0, 0.000)", "track_width": track, "via_diameter": via,
            "via_drill": drill, "wire_width": 6}

def netclass_patterns():
    out = []
    for name, (_t, _c, _v, _d, patterns) in circuit.NETCLASSES.items():
        for p in patterns:
            out.append((p, name))
    return out

def project_dict():
    classes = []
    for i, (name, (track, clearance, via, drill, _p)) in enumerate(circuit.NETCLASSES.items()):
        classes.append(_class(name, track, clearance, via, drill, 2147483647 if name == "Default" else i))
    return {
        "board": {"design_settings": {
            "rules": {"min_clearance": 0.2, "min_track_width": 0.2, "min_copper_edge_clearance": 0.5,
                      "min_via_diameter": 0.6, "min_via_annular_width": 0.15, "min_through_hole_diameter": 0.3,
                      "min_hole_clearance": 0.25, "min_hole_to_hole": 0.5, "min_silk_clearance": 0.0},
            # Silk-over-pad and silk-overlap are cosmetic and the fab clips silk on pads;
            # ignoring them keeps "DRC clean" about copper, clearance and connectivity.
            "rule_severities": {"track_dangling": "warning", "via_dangling": "warning",
                                "silk_overlap": "ignore", "silk_over_copper": "ignore",
                                "silk_edge_clearance": "ignore", "lib_footprint_issues": "ignore",
                                "lib_footprint_mismatch": "ignore"}}},
        "meta": {"filename": circuit.PROJECT + ".kicad_pro", "version": 3},
        "net_settings": {"classes": classes, "meta": {"version": 5}, "net_colors": None,
                         "netclass_assignments": None,
                         "netclass_patterns": [{"netclass": c, "pattern": p} for p, c in netclass_patterns()]},
        "text_variables": {"REVISION": circuit.REVISION},
    }

def write(project_dir):
    with open(os.path.join(project_dir, circuit.PROJECT + ".kicad_pro"), "w") as f:
        json.dump(project_dict(), f, indent=2, sort_keys=True)
        f.write("\n")
    with open(os.path.join(project_dir, circuit.PROJECT + ".kicad_dru"), "w") as f:
        f.write(RULES)
```

In `cli.py`'s `cmd_generate`, call `project.write(kicad_env.PROJECT_DIR)` before the schematic.

- [ ] **Step 4: Run the tests**

Run: `scripts/hardware.sh test`
Expected: OK. If the red test passes DRC (no violation), the project file was not picked up: confirm the `.kicad_pro` sits beside the `.kicad_pcb` with the same stem, and compare the JSON against a demo project in `/Library/Application Support/kicad/demos/*/`.

- [ ] **Step 5: Commit**

```bash
scripts/hardware.sh generate
git add hardware/dryer_board/project.py hardware/tests/test_project.py hardware/dryer_board/cli.py hardware/dryer-controller
git commit -m "Write the project file with netclasses and the mains clearance rules"
```

---

### Task 8: Placement table and board builder

**Files:**
- Create: `hardware/dryer_board/placement.py`, `hardware/dryer_board/board.py`, `hardware/tests/test_board.py`
- Modify: `hardware/dryer_board/cli.py` (`generate` builds the board after the schematic)

**Interfaces:**
- Consumes: `circuit`, `libs`, `project`, `kicad_env`, `pcbnew`.
- Produces: `placement.BOARD_W, BOARD_H`, `placement.PLACE: dict[str, tuple[float, float, int]]` ref → (x, y, rotation), `placement.SLOT_X`, `placement.SLOT_SEGMENTS`, `placement.ANTENNA_KEEPOUT`, `placement.MAINS_ZONE`, `placement.RELAY_AREAS`, `placement.SELV_POUR`, `placement.SILK: list[tuple[str, float, float, float, int, str, str]]` (text, x, y, size, rot, layer, justify), `board.build(pcb_path, fresh=False) -> pcbnew.BOARD`, `board.apply_netclasses(b)`, `board.export_dsn(b, dsn_path)`, `board.drc_report(pcb_path) -> str`.

**Geometry (mm, origin top-left, y down).** Board 110 × 85. Holes at (4,4), (106,4), (4,81), (106,81). Slot x 70.5 to 72.5, in segments y [3,14], [18,26], [30,52], [56,64], [68,82]; the four gaps are where the relay coil tracks cross (relay A coil pads at y 16 and 28, relay B at 54 and 66). Mains zone x ≥ 72.5. Antenna keep-out (5,16)–(36,34.5), no copper on either layer. Relay rule areas `relay_pads` (66,12)–(86,32) and (66,50)–(86,70). GND pour on both layers over (2,2)–(69.5,83). ESP: 12-pin socket pin 1 at (10.27, 63.87), 16-pin socket pin 1 at (30.59, 74.03), both rotated 180 so pin 1 is at the USB end, which overhangs the bottom edge by 3 mm. Every coordinate below was checked against the stock courtyards; DRC's courtyard check is the arbiter, and the implementer moves a part within its block if DRC reports an overlap.

- [ ] **Step 1: Write the failing tests**

```python
# hardware/tests/test_board.py
import os, re, tempfile, unittest
import pcbnew
from dryer_board import board, placement, circuit, project, schematic, kicad_env

class Board(unittest.TestCase):
    @classmethod
    def setUpClass(cls):
        cls.dir = tempfile.mkdtemp()
        project.write(cls.dir); schematic.write_lib_tables(cls.dir); schematic.write(cls.dir)
        cls.pcb = os.path.join(cls.dir, circuit.PROJECT + ".kicad_pcb")
        cls.b = board.build(cls.pcb, fresh=True)

    def test_every_board_part_placed_once(self):
        refs = sorted(f.GetReference() for f in self.b.GetFootprints())
        self.assertEqual(refs, sorted(p.ref for p in circuit.board_parts()))
        self.assertEqual(set(placement.PLACE), set(p.ref for p in circuit.board_parts()))

    def test_pad_nets_match_model(self):
        for part in circuit.board_parts():
            fp = self.b.FindFootprintByReference(part.ref)
            for pad in fp.Pads():
                want = part.pins.get(pad.GetNumber(), circuit.NC)
                got = pad.GetNetname()
                self.assertEqual(got, "" if want == circuit.NC else want, "%s pad %s" % (part.ref, pad.GetNumber()))

    def test_mains_netclass_resolution(self):
        for i in range(1, self.b.GetNetCount()):
            net = self.b.GetNetInfo().GetNetItem(i)
            is_mains = net.GetNetname() in circuit.MAINS_NETS
            self.assertEqual(net.GetNetClassName() == "MAINS", is_mains, net.GetNetname())

    def test_geometry(self):
        bb = self.b.GetBoardEdgesBoundingBox()
        self.assertAlmostEqual(bb.GetWidth() / 1e6, placement.BOARD_W, delta=0.2)
        self.assertAlmostEqual(bb.GetHeight() / 1e6, placement.BOARD_H, delta=0.2)
        names = sorted(z.GetZoneName() for z in self.b.Zones() if z.GetIsRuleArea())
        self.assertEqual(names, ["antenna_keepout", "mains_nopour", "relay_pads", "relay_pads"])
        pours = [z for z in self.b.Zones() if not z.GetIsRuleArea()]
        self.assertEqual(sorted(z.GetNetname() for z in pours), ["GND", "GND"])

    def test_mains_parts_in_mains_zone(self):
        x0 = placement.MAINS_ZONE[0]
        for ref in ("J_MAINS", "F1"):
            self.assertGreater(placement.PLACE[ref][0], x0, ref)
        for part in circuit.board_parts():
            if part.ref in ("J_MAINS", "F1", "K1", "K2"):
                continue
            self.assertLess(placement.PLACE[part.ref][0], placement.SLOT_X[0] - 1, part.ref)

    def test_unrouted_drc_has_only_unconnected_items(self):
        text = board.drc_report(self.pcb)
        bad = [l for l in text.splitlines() if l.startswith("[") and not l.startswith("[unconnected_items]")]
        self.assertEqual(bad, [], "\n".join(bad) + "\n\n" + text)

    def test_dsn_carries_netclasses_and_keepouts(self):
        dsn = os.path.join(self.dir, "t.dsn")
        board.export_dsn(self.b, dsn)
        text = open(dsn).read()
        self.assertIn("(class MAINS", text)
        self.assertIn("(width 1500)", text)
        self.assertGreaterEqual(text.count("(keepout"), 4)

    def test_rebuild_keeps_tracks(self):
        gnd = self.b.FindNet("GND")
        t = pcbnew.PCB_TRACK(self.b); t.SetStart(pcbnew.VECTOR2I_MM(40, 40)); t.SetEnd(pcbnew.VECTOR2I_MM(45, 40))
        t.SetWidth(pcbnew.FromMM(0.3)); t.SetLayer(pcbnew.F_Cu); t.SetNet(gnd); self.b.Add(t)
        pcbnew.SaveBoard(self.pcb, self.b)
        b2 = board.build(self.pcb, fresh=False)
        self.assertEqual(len([x for x in b2.GetTracks()]), 1)
        b3 = board.build(self.pcb, fresh=True)
        self.assertEqual(len([x for x in b3.GetTracks()]), 0)
```

- [ ] **Step 2: Run to see failure** — Expected: ImportError.

- [ ] **Step 3: Write placement.py**

```python
# hardware/dryer_board/placement.py
"""Where everything sits. mm, origin at the board's top-left corner, y down (KiCad's frame).
Rotation is KiCad's (degrees, counter-clockwise on screen). Sources: spec section
'Board layout and clearance'; ESP header positions from docs/pinout-verification.md."""

BOARD_W, BOARD_H = 110.0, 85.0
HOLES = {"H1": (4, 4), "H2": (106, 4), "H3": (4, 81), "H4": (106, 81)}

SLOT_X = (70.5, 72.5)
SLOT_SEGMENTS = [(3, 14), (18, 26), (30, 52), (56, 64), (68, 82)]
MAINS_ZONE = (72.5, 0.0, 110.0, 85.0)
ANTENNA_KEEPOUT = (5.0, 16.0, 36.0, 34.5)
RELAY_AREAS = [(66.0, 12.0, 86.0, 32.0), (66.0, 50.0, 86.0, 70.0)]
SELV_POUR = (2.0, 2.0, 69.5, 83.0)

# ESP sockets: pin 1 at the USB end (y = 88 is the USB-C face, 3 mm past the edge).
_USB_Y = 88.0
_ESP_X = 9.0

PLACE = {
    "J_ESP12": (_ESP_X + 1.27, _USB_Y - 24.13, 180),
    "J_ESP16": (_ESP_X + 21.59, _USB_Y - 13.97, 180),
    "H1": (4, 4, 0), "H2": (106, 4, 0), "H3": (4, 81, 0), "H4": (106, 81, 0),
    # mains zone
    "K1": (76, 22, 0), "K2": (76, 60, 0),
    "F1": (77, 7, 0),
    "J_MAINS": (99.5, 62, 90),
    # top strip: sensors, display
    "J_SENS": (37, 8, 0),
    "J_DISP": (38.3, 17, 90),
    "R18": (40, 21.5, 0), "C5": (44, 21.5, 0), "C6": (48, 21.5, 0),
    # 5 V block
    "U1": (44, 30, 0), "C2": (38.5, 30, 90), "C3": (55, 30, 90), "C4": (62, 29, 0),
    "R17": (40, 36, 0), "D13": (45, 36, 0),
    "D14": (52, 35.5, 0), "SW1": (62, 37, 0),
    # test points
    "TP1": (34, 39.3, 0), "TP2": (37.5, 39.3, 0), "TP3": (41, 39.3, 0), "TP4": (44.5, 39.3, 0),
    "TP5": (48, 39.3, 0), "TP6": (51.5, 39.3, 0), "TP7": (55, 39.3, 0), "TP8": (34, 55, 0), "TP9": (34, 58.5, 0),
    # 24 V input
    "J_24V": (38, 47, 0), "F2": (52, 44, 0), "D11": (60, 44, 0), "C1": (54, 51, 0),
    "R16": (40, 55.5, 0), "D12": (45, 55.5, 0),
    # relay driver A (beside relay A)
    "R1": (62, 14.5, 0), "R2": (62, 17.5, 0), "Q1": (67, 16, 0), "D1": (67, 21.5, 90), "R3": (62, 20.5, 0), "D3": (62, 23.5, 0),
    # relay driver B
    "R4": (64, 48.5, 0), "R5": (64, 51, 0), "D2": (63, 56, 90), "Q2": (67.5, 55, 0), "R6": (67.5, 59.5, 0), "D4": (67.5, 62.5, 0),
    # MOSFET stages A, B, C in columns x = 38, 47.5, 57
    "R7": (38, 58, 0), "R8": (38, 61, 0), "Q3": (38, 65, 0), "D5": (38, 70, 0), "D8": (42.5, 61, 0), "R9": (42.5, 65, 0),
    "R10": (47.5, 58, 0), "R11": (47.5, 61, 0), "Q4": (47.5, 65, 0), "D6": (47.5, 70, 0), "D9": (52, 61, 0), "R12": (52, 65, 0),
    "R13": (57, 58, 0), "R14": (57, 61, 0), "Q5": (57, 65, 0), "D7": (57, 70, 0), "D10": (61.5, 61, 0), "R15": (61.5, 65, 0),
    "J_LOADS": (38, 78, 0),
}

# (text, x, y, size, rotation, layer, justify)
SILK = [
    ("ESP32 desiccant dryer controller  rev ${REVISION}  AGPL-3.0  github.com/jrytio/desiccant-dryer", 53, 1.4, 0.9, 0, "F.SilkS", "center"),
    ("MAINS 120 VAC", 91, 75, 2.0, 0, "F.SilkS", "center"),
    ("keep 6 mm from SELV", 91, 78, 1.0, 0, "F.SilkS", "center"),
    ("SW-USB: OFF before any USB-C cable", 63.5, 40.8, 0.8, 0, "F.SilkS", "center"),
    ("GND 3V3 SCL SDA RES DC CS BLK", 46.5, 19.6, 0.8, 0, "F.SilkS", "center"),
    ("3V3 DQ GND  3V3 DQ GND  3V3 DQ GND", 51, 12.6, 0.8, 0, "F.SilkS", "center"),
    ("24V+  0V", 40.5, 52.3, 0.8, 0, "F.SilkS", "center"),
    ("VA+  VA-  VB+  VB-  F+  F-", 50.7, 84.0, 0.8, 0, "F.SilkS", "center"),
    ("24V", 45, 53.3, 0.7, 0, "F.SilkS", "center"), ("5V", 45, 33.8, 0.7, 0, "F.SilkS", "center"),
    ("HTR A", 57.5, 23.5, 0.7, 0, "F.SilkS", "center"), ("HTR B", 67.5, 64.7, 0.7, 0, "F.SilkS", "center"),
    ("VLV A", 42.5, 58.8, 0.7, 0, "F.SilkS", "center"), ("VLV B", 52, 58.8, 0.7, 0, "F.SilkS", "center"), ("FAN", 61.5, 63.0, 0.7, 0, "F.SilkS", "center"),
    ("1", 10.27, 66.5, 0.8, 0, "F.SilkS", "center"), ("12", 10.27, 33.3, 0.8, 0, "F.SilkS", "center"),
    ("1", 30.59, 76.7, 0.8, 0, "F.SilkS", "center"), ("16", 30.59, 33.3, 0.8, 0, "F.SilkS", "center"),
    ("USB end", 20, 83, 0.8, 0, "B.SilkS", "center"),
]
# Mains header pins, left of the pads, one per position (pin 1 at y 62, pitch 5.08 upward).
SILK += [(name, 97.0, 62 - i * 5.08, 0.8, 0, "F.SilkS", "right")
         for i, name in enumerate(["L IN", "N IN", "HTR A", "N", "HTR B", "N", "PSU L", "PSU N"])]
# Socket functions on the back (readable with the board upside down), mirrored by board.py.
_P12 = {4: "HTR A", 5: "HTR B", 6: "VLV A", 7: "VLV B", 8: "FAN", 3: "USB 5V"}
_P16 = {2: "3V3", 4: "GND", 5: "BL", 8: "RST", 9: "DC", 10: "CS", 11: "SCK", 12: "MOSI", 13: "1-WIRE"}
SILK += [(n, PLACE["J_ESP12"][0] + 3.5, PLACE["J_ESP12"][1] - (p - 1) * 2.54, 0.8, 0, "B.SilkS", "left") for p, n in _P12.items()]
SILK += [(n, PLACE["J_ESP16"][0] - 3.5, PLACE["J_ESP16"][1] - (p - 1) * 2.54, 0.8, 0, "B.SilkS", "right") for p, n in _P16.items()]
```

- [ ] **Step 4: Write board.py**

```python
# hardware/dryer_board/board.py
"""Build or update the .kicad_pcb with pcbnew. The generator owns footprints, nets, outline,
zones, rule areas and text; tracks and vias survive a rebuild unless their net left the
model or fresh=True."""
import os, subprocess
import pcbnew
from . import circuit, libs, placement, kicad_env

MM = pcbnew.VECTOR2I_MM
def mm(v): return pcbnew.FromMM(v)

_JUSTIFY = {"left": pcbnew.GR_TEXT_H_ALIGN_LEFT, "right": pcbnew.GR_TEXT_H_ALIGN_RIGHT, "center": pcbnew.GR_TEXT_H_ALIGN_CENTER}
_LAYER = {"F.SilkS": pcbnew.F_SilkS, "B.SilkS": pcbnew.B_SilkS}

def _rect(b, layer, x1, y1, x2, y2, width=0.1):
    s = pcbnew.PCB_SHAPE(b); s.SetShape(pcbnew.SHAPE_T_RECT)
    s.SetStart(MM(x1, y1)); s.SetEnd(MM(x2, y2)); s.SetLayer(layer); s.SetWidth(mm(width)); b.Add(s)

def _segment(b, layer, x1, y1, x2, y2, width=0.3):
    s = pcbnew.PCB_SHAPE(b); s.SetShape(pcbnew.SHAPE_T_SEGMENT)
    s.SetStart(MM(x1, y1)); s.SetEnd(MM(x2, y2)); s.SetLayer(layer); s.SetWidth(mm(width)); b.Add(s)

def _poly(b, layer, pts, width=0.1):
    s = pcbnew.PCB_SHAPE(b); s.SetShape(pcbnew.SHAPE_T_POLY)
    sps = pcbnew.SHAPE_POLY_SET(); sps.NewOutline()
    for x, y in pts:
        sps.Append(MM(x, y))
    s.SetPolyShape(sps); s.SetLayer(layer); s.SetWidth(mm(width)); s.SetFilled(False); b.Add(s)

def _zone_outline(z, x1, y1, x2, y2):
    o = z.Outline(); o.NewOutline()
    for x, y in ((x1, y1), (x2, y1), (x2, y2), (x1, y2)):
        o.Append(MM(x, y))

def _rule_area(b, name, rect, fills=True, tracks=False, vias=False, pads=False):
    z = pcbnew.ZONE(b); z.SetIsRuleArea(True); z.SetZoneName(name); z.SetLayerSet(pcbnew.LSET.AllCuMask(2))
    z.SetDoNotAllowZoneFills(fills); z.SetDoNotAllowTracks(tracks); z.SetDoNotAllowVias(vias)
    z.SetDoNotAllowPads(pads); z.SetDoNotAllowFootprints(False)
    _zone_outline(z, *rect); b.Add(z)

def _pour(b, layer, net, rect):
    z = pcbnew.ZONE(b); z.SetLayer(layer); z.SetNet(net); z.SetZoneName("gnd_" + ("F" if layer == pcbnew.F_Cu else "B"))
    z.SetLocalClearance(mm(0.3)); z.SetMinThickness(mm(0.25)); z.SetPadConnection(pcbnew.ZONE_CONNECTION_THERMAL)
    _zone_outline(z, *rect); b.Add(z)

def _text(b, text, x, y, size, rot, layer, justify):
    t = pcbnew.PCB_TEXT(b); t.SetText(text); t.SetPosition(MM(x, y)); t.SetLayer(_LAYER[layer])
    t.SetTextSize(MM(size, size)); t.SetTextThickness(mm(max(0.12, size * 0.15)))
    t.SetHorizJustify(_JUSTIFY[justify]); t.SetTextAngleDegrees(rot)
    if layer == "B.SilkS":
        t.SetMirrored(True)
    b.Add(t)

def _clear_generated(b):
    """Remove everything the generator owns: shapes, zones, text. Footprints are reconciled
    separately; tracks are kept."""
    for item in list(b.GetDrawings()):
        b.Remove(item)
    for z in list(b.Zones()):
        b.Remove(z)

def _net(b, name):
    net = b.FindNet(name)
    if net is None:
        net = pcbnew.NETINFO_ITEM(b, name); b.Add(net)
    return net

def _reconcile_footprints(b):
    existing = {f.GetReference(): f for f in b.GetFootprints()}
    for ref, fp in existing.items():
        part = next((p for p in circuit.board_parts() if p.ref == ref), None)
        if part is None or str(fp.GetFPID().Format()) != part.footprint:
            b.Remove(fp)
    for part in circuit.board_parts():
        fp = b.FindFootprintByReference(part.ref)
        if fp is None:
            fp = pcbnew.FootprintLoad(libs.footprint_path(part.footprint), libs.split(part.footprint)[1])
            fp.SetFPIDAsString(part.footprint); fp.SetReference(part.ref); b.Add(fp)
        fp.SetValue(part.value)
        x, y, rot = placement.PLACE[part.ref]
        fp.SetOrientationDegrees(0); fp.SetPosition(MM(x, y)); fp.SetOrientationDegrees(rot)
        for pad in fp.Pads():
            net = part.pins.get(pad.GetNumber(), circuit.NC)
            if net == circuit.NC:
                pad.SetNetCode(0)
            else:
                pad.SetNet(_net(b, net))

def apply_netclasses(b):
    ns = b.GetDesignSettings().m_NetSettings
    for name, (track, clearance, via, drill, patterns) in circuit.NETCLASSES.items():
        if name == "Default":
            continue
        nc = pcbnew.NETCLASS(name)
        nc.SetTrackWidth(mm(track)); nc.SetClearance(mm(clearance)); nc.SetViaDiameter(mm(via)); nc.SetViaDrill(mm(drill))
        ns.SetNetclass(name, nc)
        for p in patterns:
            ns.SetNetclassPatternAssignment(p, name)
    b.SynchronizeNetsAndNetClasses(False)

def _drop_orphan_tracks(b):
    names = set(circuit.nets())
    for t in list(b.GetTracks()):
        if t.GetNetname() not in names:
            b.Remove(t)

def build(pcb_path, fresh=False):
    if os.path.exists(pcb_path) and not fresh:
        b = pcbnew.LoadBoard(pcb_path)
        _clear_generated(b)
    else:
        b = pcbnew.BOARD()
    for name in circuit.nets():
        _net(b, name)
    _reconcile_footprints(b)
    if fresh:
        for t in list(b.GetTracks()):
            b.Remove(t)
    else:
        _drop_orphan_tracks(b)
    # outline and slot
    _rect(b, pcbnew.Edge_Cuts, 0, 0, placement.BOARD_W, placement.BOARD_H)
    x1, x2 = placement.SLOT_X
    for y1, y2 in placement.SLOT_SEGMENTS:
        _poly(b, pcbnew.Edge_Cuts, [(x1, y1), (x2, y1), (x2, y2), (x1, y2)])
    # rule areas and pours
    _rule_area(b, "antenna_keepout", placement.ANTENNA_KEEPOUT, fills=True, tracks=True, vias=True, pads=True)
    _rule_area(b, "mains_nopour", placement.MAINS_ZONE, fills=True)
    for r in placement.RELAY_AREAS:
        _rule_area(b, "relay_pads", r, fills=False)
    gnd = _net(b, "GND")
    _pour(b, pcbnew.F_Cu, gnd, placement.SELV_POUR)
    _pour(b, pcbnew.B_Cu, gnd, placement.SELV_POUR)
    # silkscreen
    for text, x, y, size, rot, layer, justify in placement.SILK:
        _text(b, text.replace("${REVISION}", circuit.REVISION), x, y, size, rot, layer, justify)
    _segment(b, pcbnew.F_SilkS, 73.5, 3, 73.5, 82)
    apply_netclasses(b)
    pcbnew.ZONE_FILLER(b).Fill(b.Zones())
    pcbnew.SaveBoard(pcb_path, b)
    return b

def export_dsn(b, dsn_path):
    if not pcbnew.ExportSpecctraDSN(b, dsn_path):
        raise RuntimeError("DSN export failed")
    return dsn_path

def drc_report(pcb_path):
    """Run DRC and return the report text. kicad-cli exits 5 on violations, so this does
    not go through run_cli."""
    rpt = pcb_path + ".drc.rpt"
    subprocess.run([kicad_env.kicad_cli(), "pcb", "drc", "--severity-all", "--refill-zones", "-o", rpt, pcb_path],
                   capture_output=True, text=True)
    return open(rpt).read()
```

Add to `cli.py`'s `cmd_generate`, after the schematic:

```python
    from . import board, circuit
    pcb = os.path.join(kicad_env.PROJECT_DIR, circuit.PROJECT + ".kicad_pcb")
    board.build(pcb, fresh="--fresh" in _args)
    print("wrote", pcb)
```

- [ ] **Step 5: Run the tests and iterate on placement**

Run: `scripts/hardware.sh test`
Expected: OK. `test_unrouted_drc_has_only_unconnected_items` is the one that iterates: each `[courtyards_overlap]` line names two references; move one of them inside its block (the comment groups in `PLACE`) and rerun. `[copper_edge_clearance]` near the slot means a pad within 0.5 mm of it. `[clearance]` with "mains to selv" names a SELV part too close to a mains pad; if it is a relay coil item, enlarge that `RELAY_AREAS` rectangle, otherwise move the part. Also confirm `test_mains_netclass_resolution` passes: if `N` resolves to Default, the pattern list in `circuit.NETCLASSES` is wrong.

- [ ] **Step 6: Generate, look, commit**

Run: `scripts/hardware.sh generate --fresh && /Applications/KiCad/KiCad.app/Contents/MacOS/kicad-cli pcb render -o /tmp/top.png --width 1600 --height 1200 hardware/dryer-controller/dryer-controller.kicad_pcb` and open `/tmp/top.png`. Check: ESP sockets at the left with the USB end over the bottom edge, mains header on the right edge, relays straddling the slot, nothing inside the antenna box.

```bash
git add hardware/dryer_board/placement.py hardware/dryer_board/board.py hardware/dryer_board/cli.py hardware/tests/test_board.py hardware/dryer-controller
git commit -m "Build the board from the placement table with pcbnew"
```

---

### Task 9: Route with Freerouting in Docker

**Files:**
- Create: `hardware/dryer_board/route.py`, `hardware/tests/test_route.py`
- Modify: `hardware/dryer_board/cli.py` (`route` command), `hardware/README.md`

**Interfaces:**
- Consumes: `board.build`, `board.export_dsn`, `pcbnew.ImportSpecctraSES`.
- Produces: `route.IMAGE = "ghcr.io/freerouting/freerouting:2.5.0"`, `route.run_freerouting(dsn_path, ses_path, passes=50) -> None` (raises if no SES appears), `route.route(pcb_path, passes=50) -> int` (number of tracks after import).

Verified on this machine: the image's entrypoint runs `exec "$@"`, so the full `java -jar /app/freerouting-executable.jar ...` command is passed; `--user_data_path` must point at a writable mount or log4j fails before routing; flags are `-de`, `-do`, `-mp`, `-mt`.

- [ ] **Step 1: Write the failing test**

```python
# hardware/tests/test_route.py
import os, shutil, tempfile, unittest
import pcbnew
from dryer_board import route, board, circuit, project, schematic

@unittest.skipUnless(shutil.which("docker"), "docker not available")
class Route(unittest.TestCase):
    def test_small_board_routes(self):
        """Two footprints, one net, must come back with at least one track."""
        d = tempfile.mkdtemp()
        b = pcbnew.BOARD()
        F = "/Applications/KiCad/KiCad.app/Contents/SharedSupport/footprints"
        from dryer_board import kicad_env, libs
        edge = pcbnew.PCB_SHAPE(b); edge.SetShape(pcbnew.SHAPE_T_RECT)
        edge.SetStart(pcbnew.VECTOR2I_MM(0, 0)); edge.SetEnd(pcbnew.VECTOR2I_MM(30, 20))
        edge.SetLayer(pcbnew.Edge_Cuts); edge.SetWidth(pcbnew.FromMM(0.1)); b.Add(edge)
        net = pcbnew.NETINFO_ITEM(b, "A"); b.Add(net)
        for ref, x in (("R1", 8), ("R2", 22)):
            fp = pcbnew.FootprintLoad(libs.footprint_path("Resistor_SMD:R_0805_2012Metric"), "R_0805_2012Metric")
            fp.SetReference(ref); fp.SetPosition(pcbnew.VECTOR2I_MM(x, 10)); b.Add(fp)
            list(fp.Pads())[0].SetNet(net)
        pcb = os.path.join(d, "t.kicad_pcb"); pcbnew.SaveBoard(pcb, b)
        n = route.route(pcb, passes=5)
        self.assertGreaterEqual(n, 1)
```

- [ ] **Step 2: Run to see failure** — Expected: ImportError (or skip if Docker is absent; it is present here).

- [ ] **Step 3: Implement route.py**

```python
# hardware/dryer_board/route.py
"""Autoroute with Freerouting running in Docker (no Java on the host). Routing is not
deterministic; the routed board is committed and CI never routes."""
import os, subprocess, shutil
import pcbnew

IMAGE = "ghcr.io/freerouting/freerouting:2.5.0"

def run_freerouting(dsn_path, ses_path, passes=50):
    work = os.path.dirname(os.path.abspath(dsn_path))
    os.makedirs(os.path.join(work, ".freerouting"), exist_ok=True)
    cmd = ["docker", "run", "--rm", "-u", "%d:%d" % (os.getuid(), os.getgid()),
           "-v", work + ":/work", IMAGE,
           "java", "-jar", "/app/freerouting-executable.jar",
           "--user_data_path=/work/.freerouting", "--gui-enabled=false",
           "-de", "/work/" + os.path.basename(dsn_path), "-do", "/work/" + os.path.basename(ses_path),
           "-mp", str(passes), "-mt", "4"]
    proc = subprocess.run(cmd, capture_output=True, text=True)
    if not os.path.isfile(ses_path):
        raise RuntimeError("Freerouting produced no SES:\n%s\n%s" % (proc.stdout[-3000:], proc.stderr[-3000:]))
    shutil.rmtree(os.path.join(work, ".freerouting"), ignore_errors=True)

def route(pcb_path, passes=50):
    b = pcbnew.LoadBoard(pcb_path)
    from . import board as board_mod
    board_mod.apply_netclasses(b)
    dsn = pcb_path[:-len(".kicad_pcb")] + ".dsn"
    ses = pcb_path[:-len(".kicad_pcb")] + ".ses"
    for p in (dsn, ses):
        if os.path.exists(p):
            os.remove(p)
    board_mod.export_dsn(b, dsn)
    run_freerouting(dsn, ses, passes)
    if not pcbnew.ImportSpecctraSES(b, ses):
        raise RuntimeError("SES import failed")
    pcbnew.ZONE_FILLER(b).Fill(b.Zones())
    pcbnew.SaveBoard(pcb_path, b)
    for p in (dsn, ses):
        os.remove(p)
    return len(list(b.GetTracks()))
```

Add to `cli.py`:

```python
def cmd_route(args):
    from . import route, circuit
    pcb = os.path.join(kicad_env.PROJECT_DIR, circuit.PROJECT + ".kicad_pcb")
    passes = int(args[0]) if args else 50
    print("tracks:", route.route(pcb, passes))
    return 0
COMMANDS["route"] = cmd_route
```

- [ ] **Step 4: Run the test**

Run: `scripts/hardware.sh test`
Expected: OK. If Freerouting exits without an SES, run the Docker command by hand with `-h` to check the flag spelling against the installed image, and look for "Couldn't get screen resolution" followed by routing progress lines in stdout; a `--gui-enabled` rejection shows up there.

- [ ] **Step 5: Route the real board and commit**

Run: `scripts/hardware.sh route 100` (several minutes). Then `scripts/hardware.sh test` again (the DRC test in Task 8 builds its own board, so it is unaffected). Add `*.dsn`, `*.ses` and `.freerouting/` to `.gitignore`.

```bash
git add hardware/dryer_board/route.py hardware/dryer_board/cli.py hardware/tests/test_route.py hardware/dryer-controller .gitignore hardware/README.md
git commit -m "Route the board with Freerouting in Docker and keep the result"
```

---

### Task 10: The routed-board gate

**Files:**
- Create: `hardware/tests/test_routed_board.py`
- Modify: `hardware/dryer_board/cli.py` (`check` command, first half: ERC and DRC on the committed files)

**Interfaces:**
- Consumes: the committed `hardware/dryer-controller/dryer-controller.kicad_pcb` and `.kicad_sch`, `board.drc_report`, `kicad_env.run_cli`.
- Produces: `cli.cmd_check` (exit 1 on any ERC or DRC violation, prints the reports).

- [ ] **Step 1: Write the tests (they run against the committed board, so they are the gate)**

```python
# hardware/tests/test_routed_board.py
import os, unittest
import pcbnew
from dryer_board import board, circuit, placement, kicad_env

PCB = os.path.join(kicad_env.PROJECT_DIR, circuit.PROJECT + ".kicad_pcb")

@unittest.skipUnless(os.path.exists(PCB), "no committed board yet")
class RoutedBoard(unittest.TestCase):
    @classmethod
    def setUpClass(cls):
        cls.b = pcbnew.LoadBoard(PCB)

    def test_drc_clean(self):
        text = board.drc_report(PCB)
        bad = [l for l in text.splitlines() if l.startswith("[")]
        self.assertEqual(bad, [], "\n".join(bad))

    def test_fully_routed(self):
        self.assertIn("** Found 0 unconnected pads **", board.drc_report(PCB))

    def test_no_copper_in_antenna_keepout(self):
        x1, y1, x2, y2 = placement.ANTENNA_KEEPOUT
        box = pcbnew.BOX2I(pcbnew.VECTOR2I_MM(x1, y1), pcbnew.VECTOR2I_MM(x2 - x1, y2 - y1))
        for t in self.b.GetTracks():
            self.assertFalse(t.GetBoundingBox().Intersects(box), "track in the antenna keep-out at %s" % t.GetStart())
        for z in self.b.Zones():
            if z.GetIsRuleArea():
                continue
            for layer in (pcbnew.F_Cu, pcbnew.B_Cu):
                fill = z.GetFilledPolysList(layer)
                self.assertFalse(fill.BBox().Intersects(box) and fill.Collide(box.Centre()), "pour inside the antenna keep-out")

    def test_mains_tracks_are_wide(self):
        for t in self.b.GetTracks():
            if t.GetNetname() in circuit.MAINS_NETS and t.GetClass() == "PCB_TRACK":
                self.assertGreaterEqual(t.GetWidth(), pcbnew.FromMM(1.5), t.GetNetname())

    def test_nc_pads_bare(self):
        for ref in ("K1", "K2"):
            fp = self.b.FindFootprintByReference(ref)
            pad4 = [p for p in fp.Pads() if p.GetNumber() == "4"][0]
            self.assertEqual(pad4.GetNetCode(), 0)
            for t in self.b.GetTracks():
                self.assertFalse(t.HitTest(pad4.GetPosition()), "%s NC pad has a track" % ref)
```

- [ ] **Step 2: Run** — Expected: `test_drc_clean` and `test_fully_routed` may fail on the first routed board. Remedies, in order: run `scripts/hardware.sh route 200`; for a stubborn unconnected pair, nudge the two parts closer in `placement.py`, `generate` (keeps tracks), `route` again; for a `[clearance]` "mains to selv" hit on a coil track, widen the slot gap or the `relay_pads` rectangle. Repeat until all five pass.

- [ ] **Step 3: Add the `check` command (first half)**

```python
def cmd_check(_args):
    from . import board as board_mod, circuit
    sch = os.path.join(kicad_env.PROJECT_DIR, circuit.PROJECT + ".kicad_sch")
    pcb = os.path.join(kicad_env.PROJECT_DIR, circuit.PROJECT + ".kicad_pcb")
    ok = True
    import subprocess
    erc = subprocess.run([kicad_env.kicad_cli(), "sch", "erc", "--severity-all", "--exit-code-violations", "-o", sch + ".erc.rpt", sch], capture_output=True, text=True)
    print(open(sch + ".erc.rpt").read()); ok &= erc.returncode == 0
    text = board_mod.drc_report(pcb); print(text); ok &= "** Found 0 DRC violations **" in text and "** Found 0 unconnected pads **" in text
    return 0 if ok else 1
COMMANDS["check"] = cmd_check
```

Add `*.rpt` to `.gitignore`.

- [ ] **Step 4: Run `scripts/hardware.sh check`** — Expected: exit 0, both reports printed with zero violations.

- [ ] **Step 5: Commit**

```bash
git add hardware/tests/test_routed_board.py hardware/dryer_board/cli.py hardware/dryer-controller .gitignore
git commit -m "Gate the routed board on DRC, full routing and the antenna keep-out"
```

---

### Task 11: Committed files match the model (the CI sync check)

**Files:**
- Create: `hardware/dryer_board/check_sync.py`, `hardware/tests/test_check_sync.py`
- Modify: `hardware/dryer_board/cli.py` (`check` runs the sync check before ERC and DRC)

**Interfaces:**
- Consumes: `schematic.write`, `schematic.netlist_from_kicad`, `project.project_dict`, `project.RULES`, `placement.PLACE`, `circuit.board_parts`, `pcbnew`.
- Produces: `check_sync.schematic_diffs(project_dir) -> list[str]`, `check_sync.board_diffs(pcb_path) -> list[str]`, `check_sync.all_diffs(project_dir) -> list[str]`.

- [ ] **Step 1: Write the failing tests**

```python
# hardware/tests/test_check_sync.py
import os, shutil, tempfile, unittest
from unittest import mock
from dryer_board import check_sync, project, schematic, board, circuit, placement

class CheckSync(unittest.TestCase):
    def setUp(self):
        self.dir = tempfile.mkdtemp()
        project.write(self.dir); schematic.write_lib_tables(self.dir); schematic.write(self.dir)
        self.pcb = os.path.join(self.dir, circuit.PROJECT + ".kicad_pcb")
        board.build(self.pcb, fresh=True)

    def test_fresh_output_is_in_sync(self):
        self.assertEqual(check_sync.all_diffs(self.dir), [])

    def test_moved_part_is_reported(self):
        moved = dict(placement.PLACE); moved["R1"] = (20, 20, 0)
        with mock.patch.object(placement, "PLACE", moved):
            diffs = check_sync.board_diffs(self.pcb)
        self.assertTrue(any("R1" in d for d in diffs), diffs)

    def test_edited_rules_are_reported(self):
        with open(os.path.join(self.dir, circuit.PROJECT + ".kicad_dru"), "a") as f:
            f.write("\n; edited by hand\n")
        self.assertTrue(any("kicad_dru" in d for d in check_sync.all_diffs(self.dir)))

    def test_renetted_pad_is_reported(self):
        import pcbnew
        b = pcbnew.LoadBoard(self.pcb)
        fp = b.FindFootprintByReference("R1")
        list(fp.Pads())[0].SetNet(b.FindNet("GND")); pcbnew.SaveBoard(self.pcb, b)
        self.assertTrue(any("R1" in d and "pad" in d for d in check_sync.board_diffs(self.pcb)))
```

- [ ] **Step 2: Run to see failure** — Expected: ImportError.

- [ ] **Step 3: Implement check_sync.py**

```python
# hardware/dryer_board/check_sync.py
"""Is the committed KiCad project what the model would generate? Compared semantically
(netlists, footprints, pad nets, positions, rules), not byte for byte, so a GUI re-save that
changes only formatting still passes."""
import json, os, tempfile
import pcbnew
from . import circuit, placement, project, schematic

def schematic_diffs(project_dir):
    diffs = []
    tmp = tempfile.mkdtemp()
    schematic.write_lib_tables(tmp); schematic.write(tmp); project.write(tmp)
    committed = os.path.join(project_dir, circuit.PROJECT + ".kicad_sch")
    if not os.path.exists(committed):
        return ["%s missing" % committed]
    want = schematic.netlist_from_kicad(os.path.join(tmp, circuit.PROJECT + ".kicad_sch"))
    got = schematic.netlist_from_kicad(committed)
    for net in sorted(set(want) | set(got)):
        if want.get(net) != got.get(net):
            diffs.append("schematic net %s: model %s, committed %s" % (net, sorted(want.get(net, [])), sorted(got.get(net, []))))
    for name in (circuit.PROJECT + ".kicad_dru", "sym-lib-table", "fp-lib-table"):
        if open(os.path.join(tmp, name)).read() != open(os.path.join(project_dir, name)).read():
            diffs.append("%s differs from the generator's output" % name)
    pro = circuit.PROJECT + ".kicad_pro"
    if json.load(open(os.path.join(tmp, pro))) != json.load(open(os.path.join(project_dir, pro))):
        diffs.append("%s differs from the generator's output" % pro)
    return diffs

def board_diffs(pcb_path):
    diffs = []
    if not os.path.exists(pcb_path):
        return ["%s missing" % pcb_path]
    b = pcbnew.LoadBoard(pcb_path)
    have = {f.GetReference(): f for f in b.GetFootprints()}
    for part in circuit.board_parts():
        fp = have.pop(part.ref, None)
        if fp is None:
            diffs.append("%s missing from the board" % part.ref); continue
        if str(fp.GetFPID().Format()) != part.footprint:
            diffs.append("%s footprint %s, model %s" % (part.ref, fp.GetFPID().Format(), part.footprint))
        x, y, rot = placement.PLACE[part.ref]
        px, py = fp.GetPosition().x / 1e6, fp.GetPosition().y / 1e6
        if abs(px - x) > 0.01 or abs(py - y) > 0.01 or (fp.GetOrientationDegrees() - rot) % 360 > 0.01:
            diffs.append("%s at (%.2f, %.2f, %.0f), model (%.2f, %.2f, %d)" % (part.ref, px, py, fp.GetOrientationDegrees(), x, y, rot))
        for pad in fp.Pads():
            want = part.pins.get(pad.GetNumber(), circuit.NC)
            got = pad.GetNetname() or circuit.NC
            if want != got:
                diffs.append("%s pad %s on %s, model %s" % (part.ref, pad.GetNumber(), got, want))
    for ref in have:
        diffs.append("%s on the board but not in the model" % ref)
    names = sorted(z.GetZoneName() for z in b.Zones() if z.GetIsRuleArea())
    if names != ["antenna_keepout", "mains_nopour", "relay_pads", "relay_pads"]:
        diffs.append("rule areas %s" % names)
    return diffs

def all_diffs(project_dir):
    return schematic_diffs(project_dir) + board_diffs(os.path.join(project_dir, circuit.PROJECT + ".kicad_pcb"))
```

In `cli.py`'s `cmd_check`, before ERC:

```python
    from . import check_sync
    diffs = check_sync.all_diffs(kicad_env.PROJECT_DIR)
    for d in diffs:
        print("OUT OF SYNC:", d)
    ok = not diffs
```

(and keep `ok &= ...` for ERC and DRC as before).

- [ ] **Step 4: Run the tests and `scripts/hardware.sh check`** — Expected: OK and exit 0.

- [ ] **Step 5: Commit**

```bash
git add hardware/dryer_board/check_sync.py hardware/dryer_board/cli.py hardware/tests/test_check_sync.py
git commit -m "Check the committed KiCad files against the generator in CI"
```

---

### Task 12: Fab exports, JLCPCB BOM and position files, renders

**Files:**
- Create: `hardware/dryer_board/export.py`, `hardware/tests/test_export.py`, `docs/hardware/` (renders)
- Modify: `hardware/dryer_board/cli.py` (`export` command), `hardware/README.md` (ordering section)

**Interfaces:**
- Consumes: `kicad_env.run_cli`, the committed project.
- Produces: `export.export_all(project_dir, out_dir, docs_dir=None) -> dict[str, str]` of produced paths; `export.jlc_cpl(kicad_pos_csv, out_csv)`; `export.GERBER_LAYERS`.

Verified `kicad-cli` options (10.0.6): `pcb export gerbers -o DIR -l LAYERS` (protel extensions by default, which JLCPCB expects), `pcb export drill -o DIR --format excellon --excellon-units mm --generate-map --map-format gerberx2`, `pcb export pos --format csv --units mm --side front --exclude-dnp -o FILE` (columns `Ref,Val,Package,PosX,PosY,Rot,Side`), `sch export bom --fields --labels --group-by --exclude-dnp`, `sch export pdf -o FILE`, `pcb export svg -l LAYERS --page-size-mode 2 --exclude-drawing-sheet --mode-single -o FILE`, `pcb render -o FILE.png --width --height [--rotate 'X,Y,Z' --perspective]`.

- [ ] **Step 1: Write the failing test**

```python
# hardware/tests/test_export.py
import csv, os, tempfile, unittest, zipfile
from dryer_board import export, circuit, kicad_env

PCB = os.path.join(kicad_env.PROJECT_DIR, circuit.PROJECT + ".kicad_pcb")

@unittest.skipUnless(os.path.exists(PCB), "no committed board yet")
class Export(unittest.TestCase):
    @classmethod
    def setUpClass(cls):
        cls.out = tempfile.mkdtemp()
        cls.paths = export.export_all(kicad_env.PROJECT_DIR, cls.out)

    def test_files(self):
        for key in ("gerber_zip", "bom", "cpl", "schematic_pdf", "top_svg", "render_top", "render_iso", "erc", "drc"):
            self.assertTrue(os.path.isfile(self.paths[key]), key)
        names = zipfile.ZipFile(self.paths["gerber_zip"]).namelist()
        self.assertEqual(len([n for n in names if n.endswith((".gbr", ".gtl", ".gbl", ".gts", ".gbs", ".gto", ".gbo", ".gtp", ".gbp", ".gm1"))]), 9)
        self.assertTrue(any(n.endswith(".drl") for n in names))

    def test_cpl_format(self):
        rows = list(csv.reader(open(self.paths["cpl"])))
        self.assertEqual(rows[0], ["Designator", "Mid X", "Mid Y", "Layer", "Rotation"])
        self.assertTrue(all(r[3] == "Top" for r in rows[1:]))
        self.assertIn("K1", [r[0] for r in rows[1:]])
        self.assertNotIn("H1", [r[0] for r in rows[1:]])

    def test_bom_format(self):
        rows = list(csv.reader(open(self.paths["bom"])))
        self.assertEqual(rows[0], ["Comment", "Designator", "Footprint", "LCSC Part #"])
        relay = [r for r in rows if "K1" in r[1]][0]
        self.assertEqual(relay[3], "C35449")
        self.assertFalse(any("H1" in r[1] for r in rows[1:]))
```

- [ ] **Step 2: Run to see failure** — Expected: ImportError.

- [ ] **Step 3: Implement export.py**

```python
# hardware/dryer_board/export.py
"""Everything the fab and the reviewer need, from the committed project, with kicad-cli."""
import csv, os, shutil, subprocess, zipfile
from . import circuit, kicad_env

GERBER_LAYERS = "F.Cu,B.Cu,F.Paste,B.Paste,F.SilkS,B.SilkS,F.Mask,B.Mask,Edge.Cuts"

def _cli(*args):
    return subprocess.run([kicad_env.kicad_cli(), *args], capture_output=True, text=True)

def jlc_cpl(kicad_csv, out_csv):
    """KiCad position CSV -> JLCPCB CPL. Mounting holes and test points carry no part, so
    rows without a package in the BOM sense are kept anyway: JLCPCB ignores designators
    absent from the BOM. Rotation is KiCad's; JLCPCB's viewer is where any per-footprint
    offset (SOT-23, SMA) is corrected before ordering."""
    with open(kicad_csv) as f, open(out_csv, "w", newline="") as g:
        r = csv.DictReader(f); w = csv.writer(g)
        w.writerow(["Designator", "Mid X", "Mid Y", "Layer", "Rotation"])
        for row in r:
            if row["Ref"].startswith(("H", "TP")):
                continue
            w.writerow([row["Ref"], row["PosX"], row["PosY"], "Top" if row["Side"] == "top" else "Bottom", row["Rot"]])

def export_all(project_dir, out_dir, docs_dir=None):
    sch = os.path.join(project_dir, circuit.PROJECT + ".kicad_sch")
    pcb = os.path.join(project_dir, circuit.PROJECT + ".kicad_pcb")
    stem = "%s-rev%s" % (circuit.PROJECT, circuit.REVISION)
    os.makedirs(out_dir, exist_ok=True)
    gerbers = os.path.join(out_dir, "gerbers"); shutil.rmtree(gerbers, ignore_errors=True); os.makedirs(gerbers)
    paths = {}
    paths["erc"] = os.path.join(out_dir, "erc.rpt"); _cli("sch", "erc", "--severity-all", "-o", paths["erc"], sch)
    paths["drc"] = os.path.join(out_dir, "drc.rpt"); _cli("pcb", "drc", "--severity-all", "--refill-zones", "-o", paths["drc"], pcb)
    kicad_env.run_cli("pcb", "export", "gerbers", "-o", gerbers + "/", "-l", GERBER_LAYERS, pcb)
    kicad_env.run_cli("pcb", "export", "drill", "-o", gerbers + "/", "--format", "excellon", "--excellon-units", "mm",
                      "--generate-map", "--map-format", "gerberx2", pcb)
    paths["gerber_zip"] = os.path.join(out_dir, stem + "-gerbers.zip")
    with zipfile.ZipFile(paths["gerber_zip"], "w", zipfile.ZIP_DEFLATED) as z:
        for name in sorted(os.listdir(gerbers)):
            z.write(os.path.join(gerbers, name), name)
    kpos = os.path.join(out_dir, "pos-kicad.csv")
    kicad_env.run_cli("pcb", "export", "pos", "--format", "csv", "--units", "mm", "--side", "front", "--exclude-dnp", "-o", kpos, pcb)
    paths["cpl"] = os.path.join(out_dir, stem + "-cpl.csv"); jlc_cpl(kpos, paths["cpl"])
    paths["bom"] = os.path.join(out_dir, stem + "-bom.csv")
    kicad_env.run_cli("sch", "export", "bom", "--fields", "Value,Reference,Footprint,LCSC",
                      "--labels", "Comment,Designator,Footprint,LCSC Part #", "--group-by", "Value,Footprint,LCSC",
                      "--exclude-dnp", "-o", paths["bom"], sch)
    paths["schematic_pdf"] = os.path.join(out_dir, stem + "-schematic.pdf"); kicad_env.run_cli("sch", "export", "pdf", "-o", paths["schematic_pdf"], sch)
    paths["top_svg"] = os.path.join(out_dir, stem + "-top.svg")
    kicad_env.run_cli("pcb", "export", "svg", "-l", "F.Cu,F.SilkS,F.Fab,Edge.Cuts", "--page-size-mode", "2",
                      "--exclude-drawing-sheet", "--mode-single", "-o", paths["top_svg"], pcb)
    paths["render_top"] = os.path.join(out_dir, stem + "-render-top.png")
    kicad_env.run_cli("pcb", "render", "-o", paths["render_top"], "--width", "1600", "--height", "1240", pcb)
    paths["render_iso"] = os.path.join(out_dir, stem + "-render-iso.png")
    kicad_env.run_cli("pcb", "render", "-o", paths["render_iso"], "--width", "1600", "--height", "1200",
                      "--rotate", "-45,0,45", "--perspective", "--zoom", "0.9", pcb)
    if docs_dir:
        os.makedirs(docs_dir, exist_ok=True)
        for key, name in (("schematic_pdf", "schematic.pdf"), ("top_svg", "top.svg"), ("render_top", "render-top.png"), ("render_iso", "render-iso.png")):
            shutil.copy(paths[key], os.path.join(docs_dir, name))
    return paths
```

The BOM's mounting holes: `Mechanical:MountingHole` symbols are `in_bom yes` in the schematic generator; set them `in_bom no` there (extend `_symbol_instance`: `in_bom = "no" if part.ref.startswith(("#", "H")) else "yes"`) so the fab BOM has no holes. Test points stay in the BOM with an empty LCSC number, which JLCPCB treats as "no part".

Add to `cli.py`:

```python
def cmd_export(_args):
    from . import export
    docs = os.path.join(kicad_env.REPO, "docs", "hardware")
    for k, v in sorted(export.export_all(kicad_env.PROJECT_DIR, kicad_env.OUT_DIR, docs).items()):
        print("%-14s %s" % (k, v))
    return 0
COMMANDS["export"] = cmd_export
```

- [ ] **Step 4: Run the tests, then export** — Expected: OK; `scripts/hardware.sh export` fills `hardware/out/` and `docs/hardware/`. Open `docs/hardware/render-top.png` and `top.svg`; print `top.svg` at 100 % and check the 110 mm width with a ruler.

- [ ] **Step 5: README and commit**

Add an "Ordering" section to `hardware/README.md`: upload `<stem>-gerbers.zip`, `<stem>-bom.csv`, `<stem>-cpl.csv` to JLCPCB; 2 layers, 1.6 mm, 1 oz, HASL lead-free, assembly top side; run JLCPCB's DFM analysis on the uploaded gerbers before paying; check rotations of SOT-23 and SMA parts in JLCPCB's placement preview; minimum order is five boards; the Songle relay is an extended part with a per-part loading fee; the mating plugs for the four pluggable headers are ordered separately and listed here with their LCSC numbers.

```bash
git add hardware/dryer_board/export.py hardware/dryer_board/cli.py hardware/dryer_board/schematic.py hardware/tests/test_export.py hardware/README.md docs/hardware hardware/dryer-controller
git commit -m "Export fab files, JLCPCB BOM and CPL, and review renders"
```

---

### Task 13: CI workflow

**Files:**
- Create: `.github/workflows/hardware.yml`
- Modify: `.github/workflows/build.yml` (`paths-ignore` gains `hardware/**`), `hardware/README.md`

**Interfaces:**
- Consumes: `scripts/hardware.sh test|check|export`, `tests/test_pinmap.py`.

- [ ] **Step 1: Prove the CI image works locally (this is the test)**

Run:

```bash
docker run --rm -v "$PWD:/w" -w /w --user root kicad/kicad:10.0 bash -c 'python3 -c "import pcbnew; print(pcbnew.GetBuildVersion())" && python3 tests/test_pinmap.py && scripts/hardware.sh test && scripts/hardware.sh check'
```

Expected: a 10.0.x version line, then the tests and check pass. `test_route` is skipped (no Docker inside the container). If `pcbnew` does not import, the spec's unverified item is answered: install `kicad-cli`'s python bindings in the workflow instead (`apt-get install -y python3-pcbnew` is not a package; the official image ships them, so a failure here means a wrong tag, not a missing package).

- [ ] **Step 2: Write the workflow**

```yaml
# .github/workflows/hardware.yml
name: hardware

on:
  push:
    branches: [main]
    tags: ['pcb-*']
    paths: ['hardware/**', 'scripts/hardware.sh', 'tests/test_pinmap.py', '.github/workflows/hardware.yml']
  pull_request:
    paths: ['hardware/**', 'scripts/hardware.sh', 'tests/test_pinmap.py', '.github/workflows/hardware.yml']

# The committed KiCad files are checked against the generator, then ERC, DRC and the fab
# exports run with the same KiCad version as the desktop. Routing never runs here: it is
# not deterministic, so the routed board is committed.
jobs:
  check:
    name: kicad check and export
    runs-on: ubuntu-latest
    container:
      image: kicad/kicad:10.0
      options: --user root
    steps:
      - uses: actions/checkout@v7
      - name: Hold the firmware pin map against the hardware pin map
        run: python3 tests/test_pinmap.py
      - name: Unit tests
        run: scripts/hardware.sh test
      - name: Generator sync, ERC, DRC
        run: scripts/hardware.sh check
      - name: Fab exports and renders
        run: scripts/hardware.sh export
      - uses: actions/upload-artifact@v4
        with:
          name: hardware-outputs
          path: hardware/out
  release:
    name: pcb release
    if: startsWith(github.ref, 'refs/tags/pcb-')
    needs: check
    runs-on: ubuntu-latest
    permissions:
      contents: write
    steps:
      - uses: actions/download-artifact@v4
        with:
          name: hardware-outputs
          path: out
      - name: Create the release with the fab files
        env:
          GH_TOKEN: ${{ github.token }}
        run: gh release create "$GITHUB_REF_NAME" --repo "$GITHUB_REPOSITORY" --title "PCB $GITHUB_REF_NAME" --notes "Fab files for board $GITHUB_REF_NAME (gerbers, JLCPCB BOM and CPL, schematic)." out/*.zip out/*.csv out/*.pdf
```

Note: the `paths` filter on `push` to `main` combined with `tags` means a tag push runs the workflow regardless of paths (GitHub evaluates `paths` only for branch pushes). Confirm on the first `pcb-*` tag.

In `build.yml`, add `- 'hardware/**'` to both `paths-ignore` lists.

- [ ] **Step 3: Commit and open the PR to see it run**

```bash
git add .github/workflows/hardware.yml .github/workflows/build.yml hardware/README.md
git commit -m "Check and export the board in CI with the KiCad 10 image"
```

The PR is opened at the end of the plan (owner's PR workflow in the global CLAUDE.md: rebase, watch CI, address Copilot). The `hardware` workflow must be green there.

---

### Task 14: Parts catalogue: LCSC numbers, the three footprint decisions, datasheets

**Files:**
- Modify: `hardware/dryer_board/circuit.py` (`lcsc=` on every part; footprints for SW1, F1 and any header that needs a local footprint), `hardware/tests/test_circuit.py` (drop `expectedFailure`)
- Create: `hardware/dryer-controller/lib/dryer.pretty/*.kicad_mod` as needed, `docs/datasheets/<group>/*.pdf`, rows in `docs/datasheets/README.md`

**Interfaces:**
- Consumes: jlcpcb.com parts search (`https://jlcpcb.com/parts` and `https://jlcpcb.com/partdetail/<C-number>`), LCSC product pages, the part datasheets.

This task is research with a test at the end. Record every C-number with its basic/extended status in the part's `description`.

- [ ] **Step 1: Look up each part at JLCPCB and record the C-number**

For each row, search the MPN or description, open the part page, confirm "Assembly: yes" and stock > 100, write `lcsc="C..."`:

| Ref | What to search | Notes |
|---|---|---|
| K1, K2 | SRD-05VDC-SL-C | C35449, extended (already recorded) |
| Q1, Q2 | MMBT2222A SOT-23 | basic part exists (e.g. Changjiang MMBT2222A); any vendor with 1 B, 2 E, 3 C |
| Q3–Q5 | SI2308 or another SOT-23 N-MOSFET, Vds ≥ 60 V, Vgs(th) ≤ 2.5 V max, Rds(on) ≤ 0.5 Ω at 4.5 V | confirm the pin order G S D on the datasheet |
| D1, D2, D5–D7 | S1M SMA | basic |
| D11, D14 | SS34 SMA | basic |
| D3, D4 | 0805 red LED; D8–D10 yellow; D12, D13 green | pick one series; note forward voltage |
| R1–R18 | 0805 1 %: 100 R, 1 k, 2.2 k, 5.1 k, 10 k | basic parts |
| C2 | 10 µF 50 V 0805 X5R/X7R; C3 22 µF 10 V; C5 100 nF 50 V; C6 10 µF 10 V | basic |
| C1 | 100 µF 50 V SMD electrolytic, 8 × 10.5 mm | confirm the pad pattern matches `CP_Elec_8x10.5` |
| C4 | 100 µF 16 V SMD electrolytic, 6.3 × 7.7 mm | as above |
| F2 | 1812 PPTC, 1.1 A hold, ≥ 30 V | e.g. Bourns MF-MSMF110 or a TECHFUSE equivalent |
| U1 | MornSun K7805-1000R3 | if absent or not assembly-eligible: `hand_fit=True`, lcsc="" and a Mouser number in the description |
| J_MAINS | 5.08 mm 8-pin pluggable header, right angle, rated ≥ 300 V 15 A (Degson 2EDGRC-5.08-08P or XUNPU DGB508) **plus the mating plug** | the plug is not assembled; list it in `hardware/README.md` as a loose part |
| J_LOADS, J_24V | 5.08 mm 6-pin and 2-pin pluggable headers, vertical (Degson 2EDGVC-5.08) plus plugs | |
| J_SENS | 3.5 mm 9-pin pluggable header, vertical (Degson 15EDGVC-3.5-09P or similar) plus plug | |
| J_DISP | 1 × 8 2.54 mm pin header | basic |
| J_ESP16, J_ESP12 | 1 × 16 and 1 × 12 2.54 mm female headers, 8.5 mm | |
| SW1 | SPDT slide switch, through-hole, 3 pins in a row at 2.54 mm (SS12D00G3 / MSS22D18 family) | |
| F1 | 5 × 20 PCB fuse holder with cover, through-hole, 250 V 10 A | read its pin pitch and hole size from the datasheet |
| TP1–TP9 | none | lcsc stays "", they are bare pads |

- [ ] **Step 2: Decide the three footprints**

For each chosen header, SW1 and F1, compare the datasheet's pin pattern with the KiCad footprint in `circuit.py`: same pitch, same pin count, hole ≥ pin diameter + 0.2 mm. Where the stock footprint matches, keep it. Where it does not (expected for SW1 and F1), write a local footprint:

```lisp
; hardware/dryer-controller/lib/dryer.pretty/SW_Slide_SPDT_P2.54mm.kicad_mod
(footprint "SW_Slide_SPDT_P2.54mm" (version 20240108) (generator "dryer_board")
  (layer "F.Cu")
  (descr "SPDT slide switch, 3 pins in a row at 2.54 mm, SS12D00-family; body 8.6 x 3.6 mm")
  (attr through_hole)
  (fp_text reference "REF**" (at 2.54 -3.2) (layer "F.SilkS") (effects (font (size 1 1) (thickness 0.15))))
  (fp_text value "SW-USB" (at 2.54 3.2) (layer "F.Fab") (effects (font (size 1 1) (thickness 0.15))))
  (fp_rect (start -2.05 -1.8) (end 7.13 1.8) (stroke (width 0.12) (type default)) (fill none) (layer "F.SilkS"))
  (fp_rect (start -2.3 -2.05) (end 7.38 2.05) (stroke (width 0.05) (type default)) (fill none) (layer "F.CrtYd"))
  (pad "1" thru_hole rect (at 0 0) (size 1.6 1.6) (drill 0.9) (layers "*.Cu" "*.Mask"))
  (pad "2" thru_hole circle (at 2.54 0) (size 1.6 1.6) (drill 0.9) (layers "*.Cu" "*.Mask"))
  (pad "3" thru_hole circle (at 5.08 0) (size 1.6 1.6) (drill 0.9) (layers "*.Cu" "*.Mask"))
)
```

Replace the body size, pin pitch and drill with the chosen part's datasheet numbers. The fuse holder follows the same shape with two pads at the datasheet pitch (commonly 22.0 to 22.6 mm), 1.3 mm drill, and a courtyard the size of the cover. Set `footprint="dryer:<name>"` on the part. `libs.footprint_path` already resolves the `dryer` library; the generated `fp-lib-table` already lists it.

- [ ] **Step 3: Datasheets**

Save each new part's datasheet under `docs/datasheets/<group>/` (groups exist: `discretes`, `power`, `relay`; add `connectors` and `fuses`) and add a row to `docs/datasheets/README.md` in its existing column format (file, part, document, source link, pages, SHA-256 first 16, what to read), with the retrieval date. Do not commit a datasheet that could not be downloaded; link it in the table's "Not included" list instead.

- [ ] **Step 4: Remove the expected failure and run everything**

Delete `@unittest.expectedFailure` from `test_every_part_has_catalogue_status`. Run `scripts/hardware.sh test`, then `scripts/hardware.sh generate` (footprint changes reconcile; tracks on unchanged nets stay), then `scripts/hardware.sh route 100` if any footprint changed, then `scripts/hardware.sh check` and `scripts/hardware.sh export`.

- [ ] **Step 5: Commit**

```bash
git add hardware docs/datasheets docs/hardware
git commit -m "Pin every part to an LCSC number and settle the switch, fuse holder and header footprints"
```

---

### Task 15: Documentation that changes

**Files:**
- Modify: `docs/hardware.md`, `docs/failure-modes.md`, `docs/inspection-checklist.md`, `CLAUDE.md`, `README.md`, `docs/releasing.md`, `hardware/README.md`

- [ ] **Step 1: docs/hardware.md**

Add a section `## Printed circuit board (rev A)` before `## Protoboard layout (proposal)` containing: one paragraph (one board, mains zone, slot, keyed plugs, fab-assembled, no hand soldering beyond the ESP); the BOM table generated from `circuit.py` (reference, value, footprint, LCSC, hand-fit) — produce it with a one-off `python -c` over `circuit.PARTS` and paste; the header pinouts (J_MAINS 1–8, J_LOADS 1–6, J_24V, J_SENS, J_DISP in the existing display order); the LED table (which LED, which net, lit means); the SW-USB rule; the relay NO/NC derivation (pad 3 NO, pad 4 NC, from the symbol drawing and the Songle wiring diagram, confirmed at first article); links to `docs/hardware/render-top.png` and `top.svg`; "what differs from the protoboard" bullets (PPTC and Schottky on 24 V, fixed 5 V module, SMD drivers, 60 V MOSFET, LEDs, one mains plug, no harness); a "Clearance and creepage" paragraph giving the 6 mm rule, the 3.5 mm relay-area rule and the 3.8 mm COM-to-coil pad gap against the IEC 62368-1 values for 150 V working voltage at pollution degree 2 (cite the table used; mark the comparison as a desk review, not a test); and an updated USB-pin drop budget: module output tolerance from its datasheet, minus the SS34 drop at 0.4 A, against the AP2112 dropout numbers already in the file, with the first-article measurement from docs/board-continuity-check.md item 6 as the check. Retitle the protoboard section `## Protoboard layout (previous build)` and add one line saying the PCB supersedes it.

- [ ] **Step 2: docs/failure-modes.md**

In the rows for A-15, F-03, G-09 and G-11, append "PCB rev A: ..." with the mitigation (slot and DRC rule; PPTC and SS34; keyed plugs; PPTC). Add two rows at the end of section F (next free F number): "PPTC on the 24 V input trips on an inrush or a hot enclosure and the valves drop out until it cools; the firmware sees it as valves that never move (F-20)" P2 HW live; and "SW-USB left on while a USB-C cable is connected: the 5 V module sources into the host port (A-level consequence as JP-USB today)" P1 OPS inspect. Update the counts table at the top of the catalogue.

- [ ] **Step 3: docs/inspection-checklist.md**

Stage 1: replace G-15 (buck preset) with "5 V module output 4.9 to 5.1 V at TP3 with the ESP out"; Stage 3 A-15: "PCB: slot present and clean along the mains boundary, no copper within 6 mm of mains copper outside the relay areas (DRC enforces; visual check for solder splashes)"; G-09: "PCB: every plug matches its header (unique pitch and pin count); labels read L IN / N IN / HTR A / N / HTR B / N / PSU L / PSU N". Add a Stage 1 item: "SW-USB OFF before any USB-C cable; ON for normal operation".

- [ ] **Step 4: CLAUDE.md, README.md, docs/releasing.md**

CLAUDE.md "Layout and pin map": a paragraph on `hardware/` (generator, committed KiCad files, `scripts/hardware.sh`, no routing in CI) and under "Invariants": "`hardware/dryer_board/pinmap.py` and the two board packages agree by header position; `tests/test_pinmap.py` enforces it. Mains nets are `L_IN`, `L_FUSED`, `L_SW_A`, `L_SW_B`, `N` and nothing else may touch them." Add "No Java on the Mac; Freerouting runs in Docker" under working conventions. README: one paragraph with a link to `hardware/README.md` and the render. docs/releasing.md: a short "PCB revisions" section: bump `REVISION` in `circuit.py`, regenerate, route, check, export, commit, then tag `pcb-rev<X>` on `origin/main` after merge; the `hardware` workflow attaches the fab files to a release.

- [ ] **Step 5: Commit**

```bash
git add docs CLAUDE.md README.md hardware/README.md
git commit -m "Document the PCB: BOM, pinouts, LEDs, failure modes, inspection and release flow"
```

---

### Task 16: First-article continuity check for the PCB

**Files:**
- Modify: `docs/board-continuity-check.md` (new top section), `docs/hardware-bringup.md` (one pointer)

- [ ] **Step 1: Write the PCB section**

Insert, after the intro paragraph and before `## Socket map`, a section `## PCB rev A` with these tables, in the existing style (ESP out, 24 V off, mains unplugged):

1. **Shorts** (beep mode, nothing beeps): 24V+ to GND at J_24V; TP3 to TP1; TP2 to TP1; every mains header pin to TP1, TP3 and TP4 (OL on the Ω range, not just no beep); the slot: both sides to each other with the meter on MΩ (OL).
2. **Relay identity** (Ω/beep): coil unpowered, K1 pad 1 (COM) to J_MAINS pin 3 (HTR A): **open**; K1 COM to pad 4: closed (that pad has no copper, probe the pin); same for K2 and pin 5. A closed COM-to-HTR reading means NO and NC are swapped on the part fitted: stop, do not connect a heater.
3. **Fuse path**: J_MAINS pin 1 to pin 7 open with F1 out, closed with F1 in; pin 7 to K1 pad 1 and K2 pad 1 closed.
4. **Plug keying**: each plug fits only its header; the 8-pin mains plug does not enter the 6-pin header.
5. **Drivers** (resistance from the socket positions, as the protoboard table): 12-pin 4 → Q1 base ~1 kΩ; base → GND ~1 kΩ; 12-pin 6/7/8 → Q3/Q4/Q5 gate ~100 Ω; gate → GND ~10 kΩ; each drain → J_LOADS SW pin ~0.
6. **Power path**: J_24V + → F2 → D11: diode reading forward only; 24 V on, ESP out, SW-USB OFF: TP4 ≈ 23.6 V, TP3 4.9 to 5.1 V, D12 and D13 lit, 12-pin position 3 = 0 V; SW-USB ON: 12-pin 3 = TP3 minus 0.2 to 0.4 V; back OFF.
7. **LED table**: D12 24 V present, D13 5 V present, D3 heater A driven (red), D4 heater B driven (red), D8 valve A, D9 valve B, D10 fan (yellow); with the ESP out none of the five output LEDs may light.
8. **Mains isolation** (Ω, top range): every J_MAINS pin, both F1 clips and every relay pad 1/3/4 to TP1 and TP3: OL.

Then `docs/hardware-bringup.md` section 1 gets one sentence: "On a PCB build, run the PCB section of docs/board-continuity-check.md first; from here on the steps are the same."

- [ ] **Step 2: Commit**

```bash
git add docs/board-continuity-check.md docs/hardware-bringup.md
git commit -m "Add the PCB first-article continuity check"
```

---

### Task 17: End-to-end run and the pull request

- [ ] **Step 1: Full pipeline from clean**

```bash
scripts/hardware.sh test && scripts/hardware.sh generate && scripts/hardware.sh check && scripts/hardware.sh export && git status --short
```

Expected: tests pass, `generate` leaves the committed files unchanged except formatting-free regeneration (git shows no diff, or only the `docs/hardware/` renders if the renderer is not pixel-stable, in which case commit them once more), `check` exits 0.

- [ ] **Step 2: The CI image run from Task 13 again** — Expected: green.

- [ ] **Step 3: Open the PR** following the owner's PR workflow (rebase on `origin/main`, push, watch CI including the new `hardware` job, address the Copilot review). Title: "Add the KiCad PCB design, generated from code". The description lists what the board is, how to regenerate, that routing is local, and the unverified list from the spec with each item's current status.
