jrytio/desiccant-dryer/docs/host-preview.md

# Host preview: the display on your Mac

The host build compiles the firmware natively for the Mac and draws the
display into a window. It runs the production controller, the virtual
plant model from `packages/hw-virtual.yaml`, and the exact drawing code
the ST7789 uses (`components/dryer_ui/display_ui.h`, fed by the `ui_draw` script in
`packages/display-draw.yaml`), so layout, text and positions match the
real screen pixel for pixel. Use it to work on the screen without flashing
a board. For a fixed state on demand (a fault, a missing probe, the boot
IP) use the scenarios build instead; see "Fixed screen states" below.

## One-time setup

```bash
brew install sdl2
```

`esphome/secrets.yaml` must exist (see `docs/virtual-testing.md`); only
`api_key` is used on host.

## Run

```bash
esphome run esphome/desiccant-dryer-host.yaml
```

ESPHome compiles natively (about a minute the first time, seconds after),
opens a 240x240 window titled `desiccant-dryer-host`, and streams the log
in the terminal. Drag the window corner to scale it up. Ctrl-C stops it.
The edit loop is: change `components/dryer_ui/display_ui.h` or an SVG under
`esphome/assets/display/`, Ctrl-C, run again.

macOS may ask once whether the program may accept incoming connections;
allow it so Home Assistant can reach the API.

## Drive it from Home Assistant

The process behaves like any other ESPHome device, **Desiccant Dryer
(Host)**, but Home Assistant will not discover it on its own (the host
platform has no real mDNS). Add the ESPHome integration manually with the
Mac's LAN address, port 6053, and the `api_key` from `secrets.yaml`. Every Sim knob and
threshold from `docs/virtual-testing.md` works the same way, so the
checklist there can be run on the Mac with the screen in view. The five
output switches toggle and interlock normally; they drive no pins.

Useful screen states and how to reach them:

| Screen | How |
|---|---|
| A IN USE (solid green), B WET (solid yellow), green chevrons into the top of A, air path lit down the A branch | Fresh start |
| B turns solid orange, HEATING, orange heat waves rising from the top of B | Sim Speed 60, wait about a minute |
| B turns blue (COOLING), then purple (READY), then the path moves to B | Keep waiting |
| Gauge word RISING / HIGH / OVER, OVR badge top right | Override Humidity on, Override RH 6 / 9 / 12 |
| OFF on both packs, nothing lit, strip "Disabled" | Dryer Enabled off |
| Red strip "FAULT · ...", the faulted pack solid red | Sim Heater Max Temp 130, wait for heating |

## No window (CI, or a terminal over SSH)

```bash
SDL_VIDEODRIVER=dummy esphome/.esphome/build/desiccant-dryer-host/.pioenvs/desiccant-dryer-host/program
```

SDL's dummy video driver renders into memory instead of a window, so the
same binary runs where no display server exists. Nothing about the build
changes: the drawing code still runs every frame. That is how the
`host-cases` CI job runs `tests/run_cases.py` against this build; see the
Harness section of `docs/verification-plan.md`.

## Persisted state

Everything the board would keep in flash (active pack, counters, Sim
knobs, plant temperatures) is kept in
`~/.esphome/prefs/desiccant-dryer-host.prefs`. Delete that file for a
fresh boot. The Restart button exits the process; run it again to
"reboot", and the state resumes from the file exactly as on the board.

## Fixed screen states

`esphome/desiccant-dryer-scenarios.yaml` is a second host build with no
controller: a table of twelve screen states (`packages/display-scenarios.yaml`,
matching `docs/display/mockup-states.html`) sets every input the screen
reads. `scripts/scenario-shots.sh` builds it once and renders all twelve
through the panel's RGB 3-3-2 palette into `docs/display/state-NN.png`, so
those PNGs are what the ST7789 will show, rounding included. To watch one
in a window:

```bash
esphome compile esphome/desiccant-dryer-scenarios.yaml
SCENARIO=9 esphome/.esphome/build/desiccant-dryer-scenarios/.pioenvs/desiccant-dryer-scenarios/program
```

## What the preview cannot show

The window renders the drawing, not the panel. These only show on the
real screen (or in the scenario PNGs, which apply the palette):

- 8-bit palette rounding (the device driver's `color_depth: 8bit`, RGB
  3-3-2), so colours are slightly richer in the window.
- `invert_colors`, `offset_height` and `offset_width`.
- Backlight level; there is no `Display Backlight` entity on host.

There is no web server on host, so the entity-name REST URLs from the
bench notes do not apply; use Home Assistant.
