jrytio/desiccant-dryer/docs/superpowers/plans/2026-09-14-cylinder-state-colours.md

# Cylinder State Colours Implementation Plan

> **For agentic workers:** REQUIRED SUB-SKILL: Use superpowers:subagent-driven-development (recommended) or superpowers:executing-plans to implement this plan task-by-task. Steps use checkbox (`- [ ]`) syntax for tracking.

**Goal:** Replace the temperature fill in the display's two cylinders with a solid body colour per pack state.

**Architecture:** `esphome/packages/display_ui.h` draws the whole screen from a `UiState`. Today `draw_fill()` paints stacked colour bands up to a temperature level plus a cap sprite, underneath `schematic.svg`, whose cylinder interiors are transparent. The new `draw_fill()` paints one rectangle in the state colour in the same place. The fill-only inputs (`cooldown`, `regen`, `overtemp`), threshold dashes, cap sprites and fault-ring sprite are removed end to end (header, `display-draw.yaml`, `display-scenarios.yaml`, SVG assets).

**Tech Stack:** ESPHome 2026.1.4 (ESP-IDF on ESP32-S2, plus `host` platform builds with SDL2), C++ header included via `esphome: includes:`, SVG images rasterised at compile time, Python/Pillow scenario renders.

**Spec:** `docs/superpowers/specs/2026-09-14-cylinder-state-colours-design.md`. Reference sheet: `docs/display/mockup-states.html`.

## Global Constraints

- Colours (RGB 3-3-2 grid): IN USE `#24DB55` (`GREEN`), WET `#FF92AA` (`PINK`, new), HEATING `#FF9200` (`ORANGE`), COOLING `#00DBFF` (`CYAN`), READY `#246DFF` (`BLUE`), FAULT `#FF2424` (`RED`).
- Words: active pack `IN USE` (was `IN SERVICE`); faulted pack `FAULT` (unchanged); disabled `OFF` in `DIM`; `active_pack == 0` shows no word.
- Disabled and Starting (`active_pack == 0`): body not filled (stays black).
- NaN temperature: body colour stays; temperature text `--°` in `DIM` (unchanged).
- Fault: only the faulted pack is red (code 1 active pack, codes 2/3 standby); the other pack keeps its colour. No fault ring.
- No change to layout, plate, heater glow, valves, lit path, gauge, strip, SIM badge, fan, timers, fonts, `base.yaml` or any HA entity.
- CLAUDE.md rules: nothing WiFi/OTA/SPI/LEDC in `display-draw.yaml`; no `id()` calls in `display_ui.h`; every display change is checked with `scripts/scenario-shots.sh` before commit.
- Commit messages end with `Co-Authored-By: Claude Opus 5 <noreply@anthropic.com>`.
- Work only inside the worktree `/Users/josh/GitHub/desiccant-dryer/.claude/worktrees/cylinder-state-colors-343ff1`. Never use bare `git stash`.

---

### Task 1: Solid state-colour cylinder bodies

The header, `display-draw.yaml` and `display-scenarios.yaml` must change together: `UiAssets` is aggregate-initialised in the `ui_draw` script in member order, and the script reads `UiState` fields. There is no unit-test harness for the display; the test is the palette-accurate scenario renders plus `esphome config` / `esphome compile`.

**Files:**
- Modify: `esphome/packages/display_ui.h`
- Modify: `esphome/packages/display-draw.yaml` (image list lines 97–116, script lines 146–148 and 155–160)
- Modify: `esphome/packages/display-scenarios.yaml` (numbers lines 82–105)
- Modify: `esphome/assets/display/schematic.svg` (comment lines 2–4 only)
- Delete: `esphome/assets/display/fault-ring.svg`, `cap-blue.svg`, `cap-amber.svg`, `cap-gold.svg`
- Regenerate: `docs/display/state-01.png` … `state-12.png`

**Interfaces:**
- Consumes: nothing from other tasks.
- Produces: `dryer_ui::PINK`; `PackView::filled`; `draw_fill(Display &, const PackView &)`; `draw_pack_text(Display &, const UiAssets &, const PackView &)`; `UiState` without `cooldown/regen/overtemp`; `UiAssets{f_temp, f_val, f_cap, f_label, f_phase, f_status, f_status_b, bg, valve_open, valve_closed, heater_on_a, heater_on_b, lit_a, lit_b, fan}`.

- [ ] **Step 1: Capture the before-config baseline**

Run from the worktree root, before editing anything:

```bash
SCRATCH=/private/tmp/claude-501/-Users-josh-GitHub-desiccant-dryer--claude-worktrees-cylinder-state-colors-343ff1/166ee361-d09d-40a9-aed5-c0ead9321440/scratchpad/cfg
mkdir -p $SCRATCH
cp esphome/secrets.ci.yaml esphome/secrets.yaml
esphome config esphome/desiccant-dryer.yaml > $SCRATCH/prod-before.txt 2>/dev/null; echo prod=$?
esphome config esphome/desiccant-dryer-scenarios.yaml > $SCRATCH/scen-before.txt 2>/dev/null; echo scen=$?
```

Expected: `prod=0`, `scen=0`. (`esphome/secrets.yaml` is gitignored; never commit it.) The first run downloads fonts and may take a minute.

- [ ] **Step 2: Edit `display_ui.h` — header comment, state, assets, colours**

Replace lines 6–7 of the header comment:

```cpp
// packages/display-draw.yaml gathers the state. Geometry and rules follow
// docs/superpowers/specs/2026-09-14-display-ui-design.md sections 2, 4, 5,
// with the cylinder colours of 2026-09-14-cylinder-state-colours-design.md.
```

In `struct UiState`, replace the line
`  float arm_rh = 5, swap_rh = 10, cooldown = 40, regen = 90, overtemp = 120;` with:

```cpp
  float arm_rh = 5, swap_rh = 10;
```

Replace `struct UiAssets` (keep the comment above it):

```cpp
struct UiAssets {
  BaseFont *f_temp, *f_val, *f_cap, *f_label, *f_phase, *f_status, *f_status_b;
  BaseImage *bg, *valve_open, *valve_closed, *heater_on_a, *heater_on_b, *lit_a, *lit_b, *fan;
};
```

Replace the colour block (the comment line `// RGB 3-3-2 grid colours (spec section 5).` and the seven `static const Color` lines after it) with:

```cpp
// RGB 3-3-2 grid colours (display UI spec section 5; cylinder colours spec
// section 1).
static const Color BLACK(0, 0, 0), WHITE(255, 255, 255);
static const Color GREEN(36, 219, 85), ORANGE(255, 146, 0), AMBER(255, 182, 0), CYAN(0, 219, 255);
static const Color BLUE(36, 109, 255), PINK(255, 146, 170);
static const Color SHELL(73, 73, 85), DIM(146, 146, 170), STRIP_TXT(182, 182, 170);
static const Color RED_STRIP(219, 36, 36), RED(255, 36, 36);
static const Color DRY_DIM(36, 109, 36), AMBER_DIM(109, 73, 0), RED_DIM(109, 0, 0);
```

- [ ] **Step 3: Edit `display_ui.h` — `PackView`, remove `dashes`/`level_y`, `pack_roles`**

Replace `struct PackView` (keep its comment line):

```cpp
struct PackView {
  int cx = 0;
  float t = NAN;
  const char *phase = "";
  Color phase_color = DIM;  // also the body colour when filled
  bool filled = false;      // body painted in phase_color; false when off or starting
  bool show_timer = false;
  float timer_s = 0;
};
```

Delete the `dashes()` function with its `// 2 px on, 3 px off...` comment, and the `level_y()` function with its `// Row of the fill's top edge...` comment.

Replace `pack_roles()` with:

```cpp
inline void pack_roles(const UiState &s, PackView &a, PackView &b) {
  static const char *const SB_NAMES[] = {"WET", "HEATING", "COOLING", "READY"};
  static const Color SB_COLORS[] = {PINK, ORANGE, CYAN, BLUE};
  a = PackView{};
  b = PackView{};
  a.cx = CX_A;
  a.t = s.t_a;
  b.cx = CX_B;
  b.t = s.t_b;
  if (!s.enabled) {
    a.phase = b.phase = "OFF";
    return;
  }
  if (s.active != 1 && s.active != 2) return;  // starting: no roles yet
  PackView &act = s.active == 1 ? a : b;
  PackView &sb = s.active == 1 ? b : a;
  act.phase = "IN USE";
  act.phase_color = GREEN;
  act.filled = true;
  act.show_timer = true;
  act.timer_s = s.service_s;
  int st = s.standby_state;
  if (st < 0 || st > 3) st = 0;
  sb.phase = SB_NAMES[st];
  sb.phase_color = SB_COLORS[st];
  sb.filled = true;
  sb.show_timer = true;
  sb.timer_s = s.standby_s;
  PackView *faulted = s.fault_code == 1 ? &act : (s.fault_code == 2 || s.fault_code == 3) ? &sb : nullptr;
  if (faulted != nullptr) {
    faulted->phase = "FAULT";
    faulted->phase_color = RED;
  }
}
```

- [ ] **Step 4: Edit `display_ui.h` — `draw_fill`, `draw_pack_text`, `draw_ui`**

Replace `draw_fill()` and the comment block above it with:

```cpp
// The body in its state colour: one rectangle over the cylinder interior,
// drawn before the background, which keeps its grey top cap over row 40 and
// masks everything outside the bottom cap curve down to row 156.
inline void draw_fill(Display &it, const PackView &p) {
  if (p.filled) it.filled_rectangle(p.cx - 25, 40, 51, 116, p.phase_color);
}
```

Replace `draw_pack_text()` and its comment with:
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
