jrytio/desiccant-dryer/docs/datasheets/sensors/adafruit-1.54in-ips-tft-schematic.png

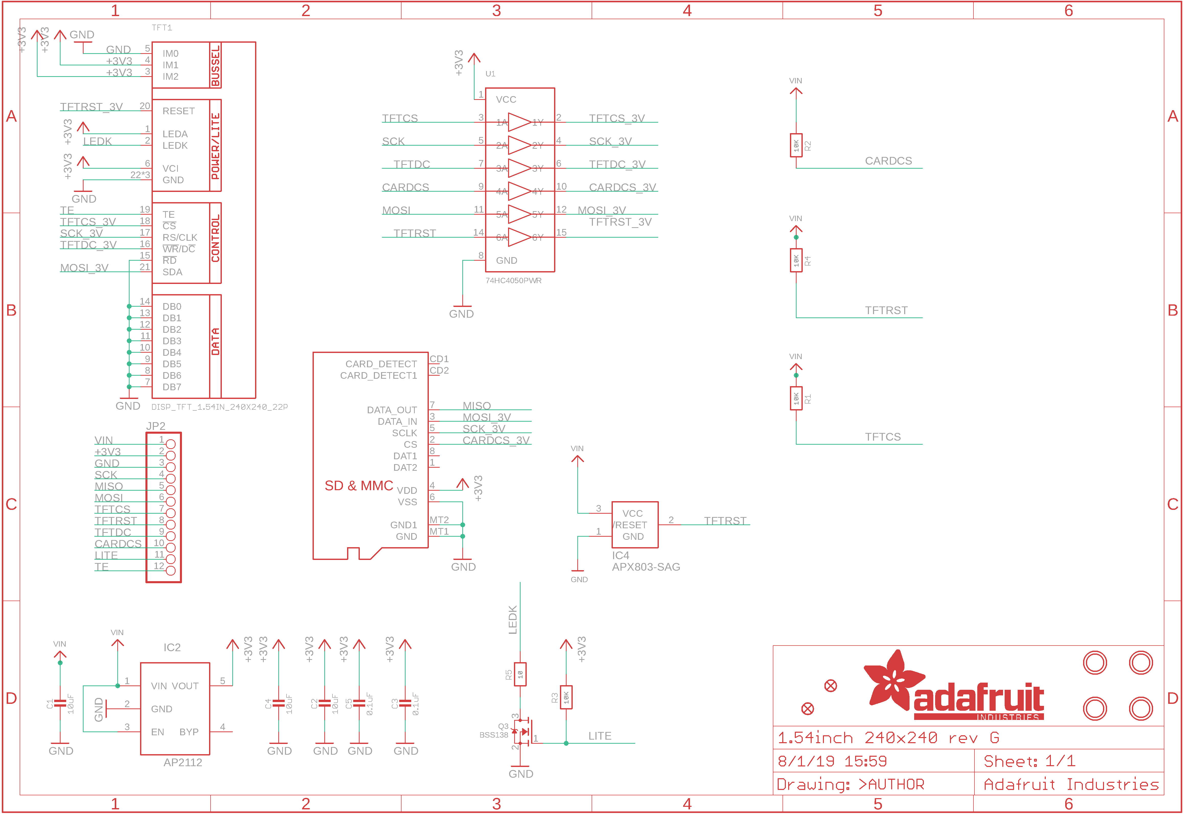
docs/datasheets/sensors/adafruit-1.54in-ips-tft-schematic.png
