jrytio/desiccant-dryer/docs/display/state-01.png

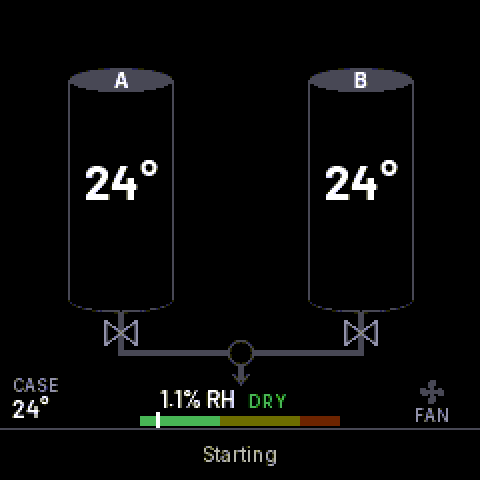
docs/display/state-01.png
