jrytio/desiccant-dryer/docs/display/state-02.png

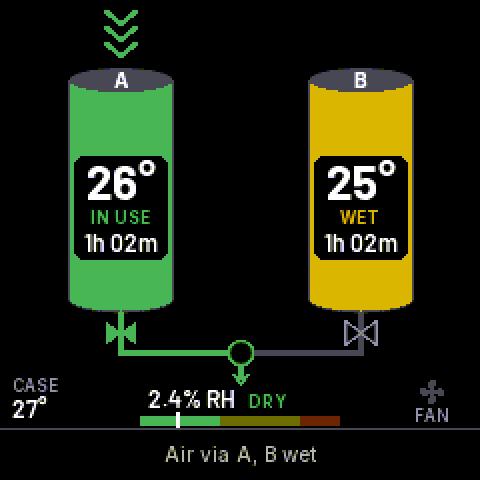
docs/display/state-02.png
