jrytio/desiccant-dryer/docs/display/state-03.png

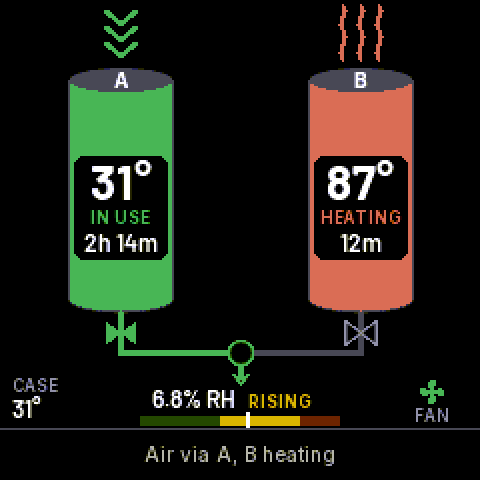
docs/display/state-03.png
