jrytio/desiccant-dryer/docs/display/state-06.png

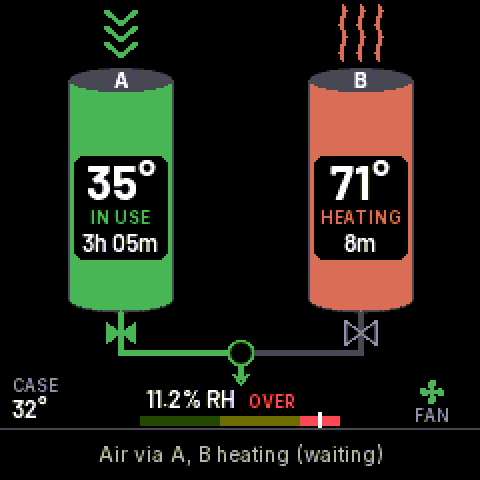
docs/display/state-06.png
