jrytio/desiccant-dryer/docs/display/state-09.png

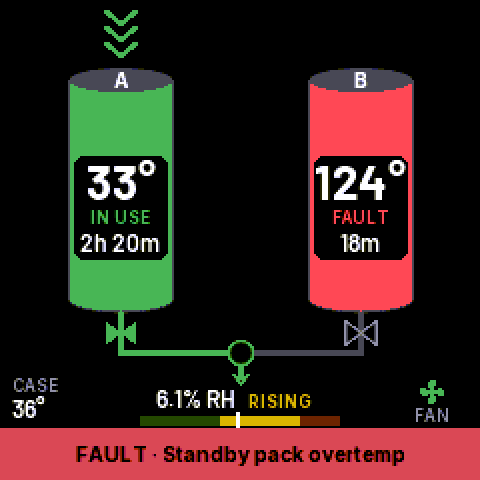
docs/display/state-09.png
