jrytio/desiccant-dryer/docs/hardware/controller-render-iso.png

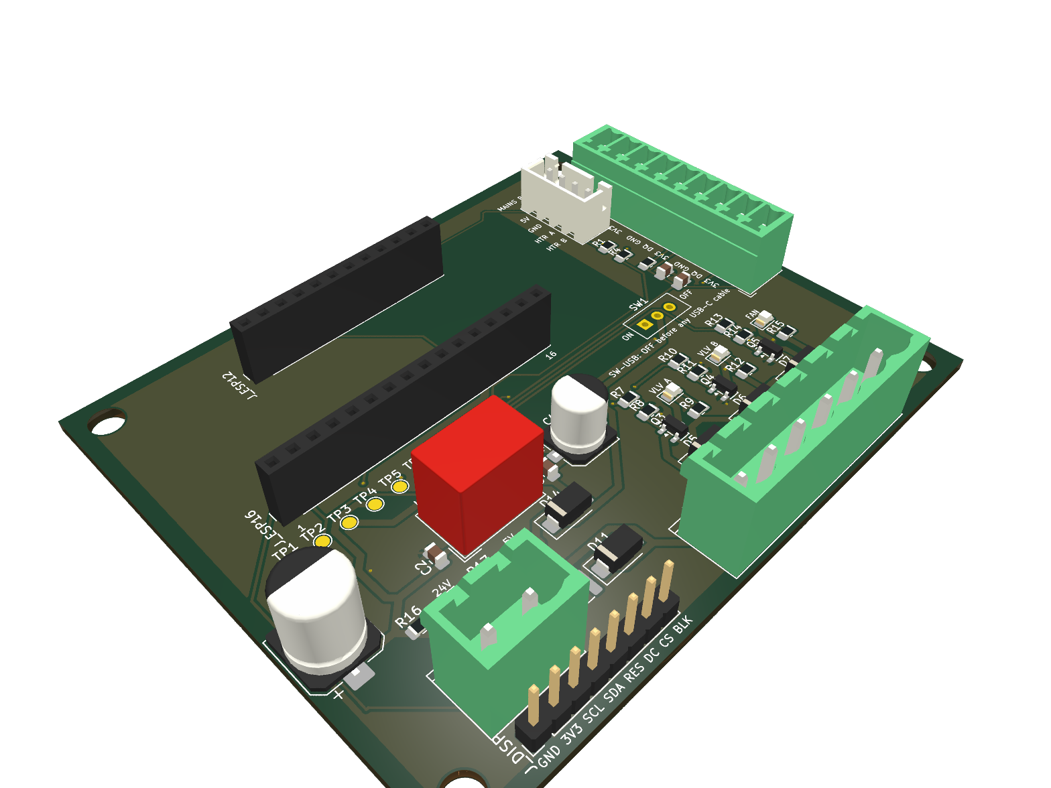
docs/hardware/controller-render-iso.png
