jrytio/desiccant-dryer/docs/hardware/mains-render-iso.png

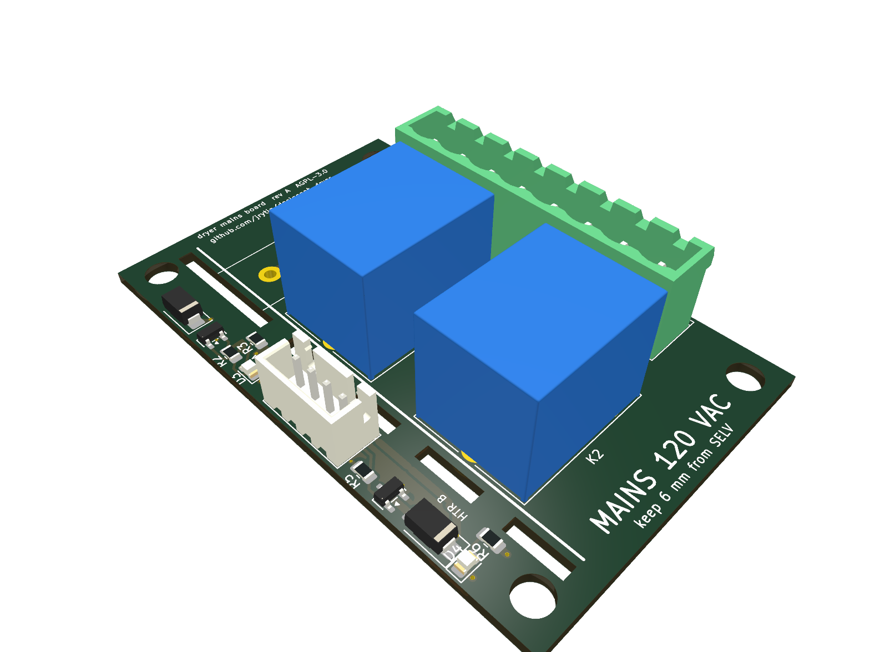
docs/hardware/mains-render-iso.png
