jrytio/desiccant-dryer/docs/hardware/render-iso.png

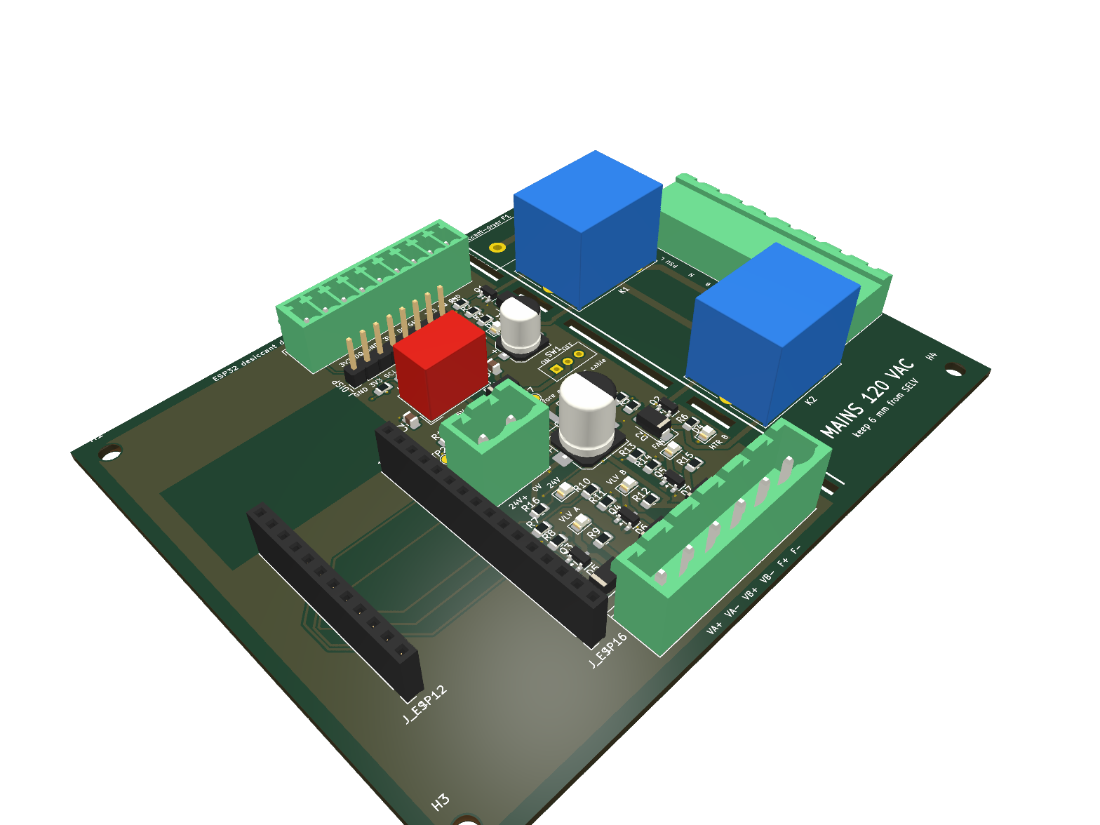
docs/hardware/render-iso.png
