jrytio/desiccant-dryer/docs/hardware/render-top.png

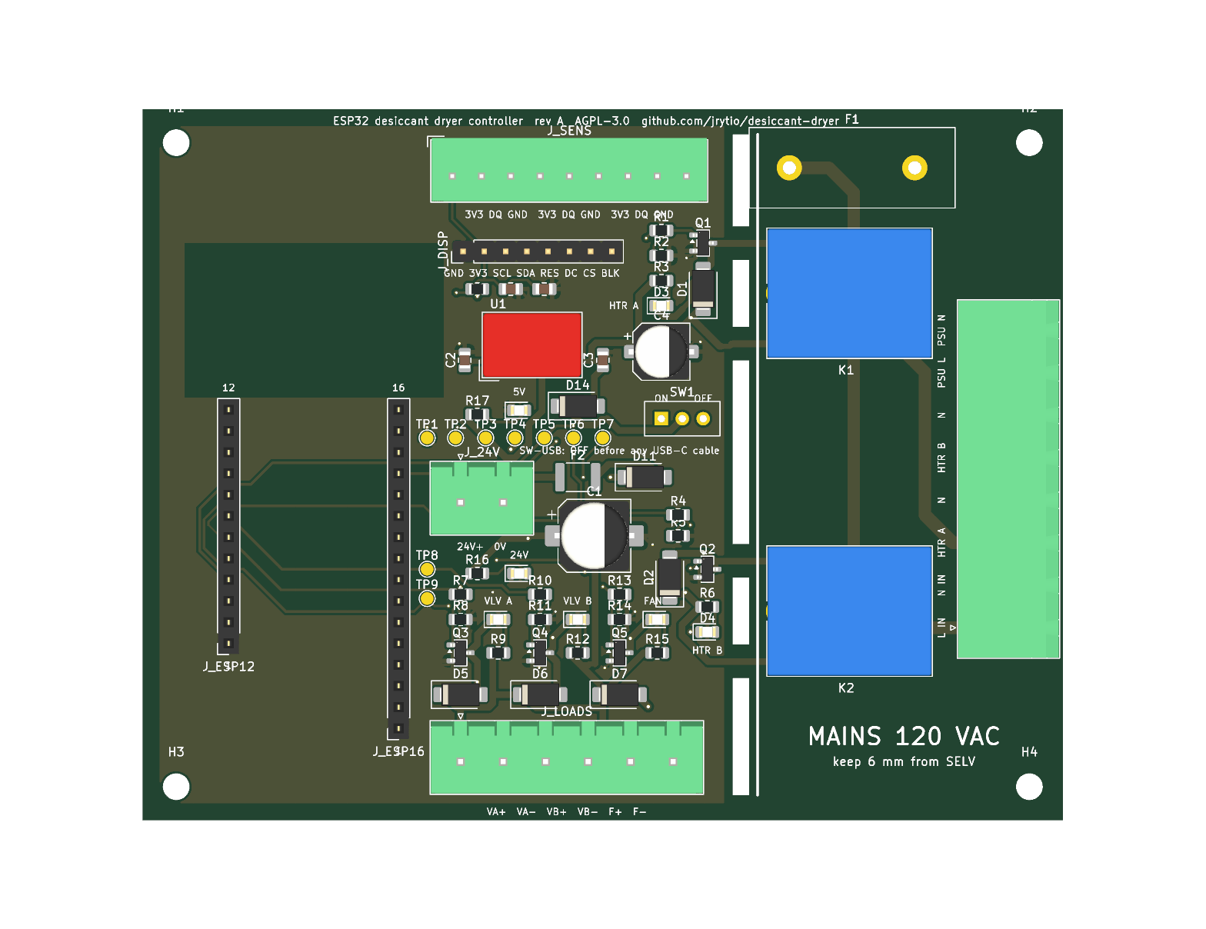
docs/hardware/render-top.png
