jrytio/desiccant-dryer/docs/hardware-bringup.md

# Hardware bring-up checklist

Bring-up of a board wired into real hardware. Bench state for the first run
(2026-09-15): three DS18B20s, both valves, the fan and the display
connected; PN2222A heater driver stages wired but no relays; no SHT45.
Everything here is safe with mains disconnected, and nothing switches mains
until the relays exist.

What to expect with the gaps: the SHT45 logs a read failure every 10 s and
`Outlet Air Humidity` stays unknown, which holds the state machine safely
until `Override Humidity` is on. The heater switches drive the transistor
bases only; GPIO13 also lights the on-board blue LED.

The testing runs on the **hardware test build**,
`esphome/desiccant-dryer-hw-test.yaml`: the production controller and real
hardware plus the developer credentials from `secrets.yaml`, so it takes
OTA updates as often as needed and USB is only used once. The released
production image (`esphome/desiccant-dryer.yaml`) has no OTA server, no
WiFi credentials (it has WiFi and a setup access point, and is provisioned
through Improv or that access point); it installs its own updates from the
published manifest instead. It goes on last,
as its own step (section 7).

An ESP32-C6 board uses `esphome/desiccant-dryer-hw-test-c6.yaml` wherever
this page says `desiccant-dryer-hw-test.yaml`, and has steps of its own in
[section 8](#8-esp32-c6-board). GPIO numbers on this page are the S2's.

## 1. Flash the test build (USB, once)

On a PCB build, run the PCB section of docs/board-continuity-check.md first; from here on the steps are the same.

1. First pull JP-USB (protoboard) or the wire from the board's USB pin to
   the breadboard 5 V rail (breadboard). That pin is the same net as the
   USB-C connector's VBUS, with no diode, so leaving it in ties the buck to
   the computer's USB port. Then plug the
   board in. macOS lists one CP2102N twice (`cu.SLAB_USBtoUART` and
   `cu.usbserial-NNN`); either works:

   ```bash
   ls /dev/cu.usbserial* /dev/cu.SLAB*
   ```

2. Copy the real `secrets.yaml` into `esphome/` (the CI copy has dummy
   WiFi) and flash:

   ```bash
   esphome run --device /dev/cu.usbserial-XXXX --no-logs esphome/desiccant-dryer-hw-test.yaml
   ```

3. Unplug, wire the board into the hardware, power it. It joins WiFi as
   `desiccant-dryer-hw-test`; find the IP from mDNS or the router. From here
   every reflash is over the network:

   ```bash
   esphome run --device <board> esphome/desiccant-dryer-hw-test.yaml
   ```

4. Add it in Home Assistant: Settings → Devices & services → Add
   integration → ESPHome, host `<board>`, port 6053, the `api_key` from
   `secrets.yaml`. Home Assistant is on another site with no mDNS across the
   VPN, so it is not discovered by itself. The entity unit settings
   default to °F on a new entry; set them to °C if you want to match the
   thresholds.

Logs without USB: `esphome logs --device <board>
esphome/desiccant-dryer-hw-test.yaml` (the dump on connect lists the 1-wire
devices), or the web server's event stream at `http://<board>/events`.

## 2. Identify the DS18B20 probes

`dallas_temp` has no `index:` option, so the probes need their addresses
before they read at all.

1. Copy the three addresses from the `[gpio.one_wire] Found devices` lines
   into `hw-real.yaml`, any order, and reflash over the network.
2. Warm one probe at a time (fingers give 2 to 5 °C within a minute) and
   note which of `Pack A Temperature`, `Pack B Temperature`, `Case
   Temperature` rose.
3. Either reassign the addresses in `hw-real.yaml` and reflash, or label
   the probes to match the file. Commit the addresses on their own.

First unit (2026-09-15), probes labelled to match:

| Entity | Address |
|---|---|
| Pack A Temperature | `0x8b00000071633028` |
| Pack B Temperature | `0xc300000070605d28` (confirmed by warming) |
| Case Temperature | `0xdb0000006f9c0328` |

## 3. Outputs, one at a time, from HA

The `Heater A/B` and `Valve A/B` switches exist only in the bench builds
(`desiccant-dryer-hw-test.yaml` and `desiccant-dryer-virtual.yaml`, which set
`outputs_internal: "false"`). The released firmware makes them `internal`, so
Home Assistant and the web server see only the read-only `Heater A Relay`
mirrors and nothing but the control tick can energise a relay (K-01/K-02).
Do this step on the hw-test build.

Turn `Dryer Enabled` off first: the control tick re-asserts outputs every
5 s while it is on and would undo your toggles. (With `outputs_internal`
true the tick drives every output off while disabled as well, which is why
this step needs a bench build.)

The heater stages have no load until the relays are fitted, so an open
collector floats near 0 V whether the transistor is on or off. Put a pull-up
(about 1 kΩ to 5 V, or an LED and resistor) on each collector in place of
the coil to see it switch.

| Output | Action | Expect | First unit |
|---|---|---|---|
| Valve A | switch on, then off | audible click each way; Valve B stays off | pass |
| Valve B | switch on while A is on | A drops out first, B clicks on 500 ms later (interlock) | pass, ~650 ms seen from HA |
| Case Fan | set Case Fan Thermostat target below case temp | fan runs once 30 s minimum idle has passed; back above: stops after 60 s minimum run | pass, ~60 s run |
| Heater A | switch on | blue LED lights; A collector under 0.2 V, B collector ~5 V | pass, 9 mV / 5 V |
| Heater B | switch on while A is on | A drops out first, B on 500 ms later; B collector under 0.2 V, A ~5 V | pass, ~600 ms, 13 mV / 5 V |

Turn every output off afterwards, then `Dryer Enabled` on: within 5 s the
tick should open Valve A and leave everything else off.

## 4. Display

Compare the panel with the reference states in `docs/display/` (and with
the live host preview, `docs/host-preview.md`). With
no SHT45 the humidity reads `--% RH`. If the image is shifted or cropped,
try `offset_height: 80` as the comment in `display-st7789.yaml` says; red
and blue swapped means the colour order, a negative image means
`invert_colors`. First unit, on 1.0.x with the old `ili9xxx` driver: offset
0, colours and backlight correct.

The panel now runs `mipi_spi` with `color_depth: 8bit` and a banded buffer
(`packages/display-st7789.yaml`). **No panel has been attached to a board
since that change**, so colour, banding, tearing and image offset are
unverified on real glass; the 40 MHz SPI clock was restored to match the old
driver, not re-validated. Treat this section as the check that proves it.

## 5. Cycle with the humidity override and real probes

Follow "Test sequence on the real unit" in `docs/control-logic.md`, setting
the override slider from HA. For the bench:

- `Regen temp` cannot go below 40 °C, which fingers do not reach. Set it to
  40 °C and use a heat gun on low (or hot water) on the standby probe; aim
  for 45 to 60 °C, far below the 110 °C overtemp latch.
- `Regen hold time` 1 min, `Cooldown temp` about 33 °C so COOLING has a
  threshold to fall through once the heat is removed.
- Start heating within 5 min of the heater switch turning on, or the "not
  heating" fault latches; that is the check working.

First unit: B heating → cooling → ready, swap to B (with "A heating
(waiting)" at 12 %), A heating → cooling → ready, swap back to A, no faults.

Afterwards: `Dryer Enabled` off, `Override Humidity` off, and the tunables
back to their defaults (regen 90 °C / 15 min, cooldown 40 °C).

## 6. Record

Note anything that differed from the tables above, and the addresses and
display offset of each unit, in this file.

## 7. Production image

Needs USB access to the board. Follow "Installing a release on a dryer" in
docs/releasing.md: flash the release over USB with web.esphome.io, give it
WiFi (Improv, or the setup access point), and accept it in Home Assistant.
Expect `Firmware Version` to match the release. Remove the HW Test entry
from HA first if it uses the same host.

From then on the unit updates itself: the `Firmware` update entity polls
the published manifest every 6 h and installs over HTTPS. There is no
inbound OTA server on the release image, so if that updater cannot reach a
working manifest the only way back is another USB flash — see the Recovery
section of docs/releasing.md, which also records the two accepted security
trade-offs of this arrangement.

Also note that the production image redraws the panel every 10 s (the test
builds use 5 s), so a fault or overtemp indication can be up to 10 s stale
on the screen.

## 8. ESP32-C6 board

For a SparkFun Thing Plus ESP32-C6 (DEV-22924). Nothing in this section had
been run on a C6 when it was written (2026-10-12). Record what you see
under each step, including a step that fails.

Preparation, before the board goes near a socket: cut ALRT and SD_DET,
check the cuts with a meter and keep the µSD slot empty
([hardware.md](hardware.md#fitting-an-esp32-c6-thing-plus)).

- [ ] **8.1 Flash the test build, board out of the socket.** Plug the
  USB-C cable straight into the board; the port is `/dev/cu.usbmodem*`.

  ```bash
  ls /dev/cu.usbmodem*
  esphome run --device /dev/cu.usbmodemXXXX esphome/desiccant-dryer-hw-test-c6.yaml
  ```

  Pass: it flashes without the BOOT button, the log appears on the same
  port, and the board joins WiFi as `desiccant-dryer-hw-test-c6`.
- [ ] **8.2 Seat it and power the main board** (JP-USB fitted, no USB
  cable). Pass: the panel shows the normal screen with no torn or shifted
  areas (40 MHz SPI through the C6's GPIO matrix is untested); the SHT45
  and all three DS18B20s read; no relay clicks, no valve pulls in and the
  fan stays off at power-up.
- [ ] **8.3 Sections 3 to 5 of this page**, on the C6 test build. Pass: as
  written there, except that no LED lights with heater A.
- [ ] **8.4 One USB flash attempt while seated.** Pull JP-USB first, plug
  in USB-C and run the 8.1 command again. Record whether it flashes: the
  fan's gate pulldown holds the GPIO8 boot strap low, which the datasheet
  calls an invalid combination with download mode. Either result is
  useful; write it into
  [pinout-verification.md](pinout-verification.md#thing-plus-esp32-c6-dev-22924)
  and hardware.md.
- [ ] **8.5 Release image.** After the first release that carries a C6
  image (1.3.0) is published: flash it from the manifest with
  web.esphome.io, board out of the socket; give it WiFi over Improv; reboot
  it once. Pass: `Firmware Version` reads the release, the `Firmware`
  update entity reads up to date, and Improv worked over the native USB
  port. Record `Free Heap`, `Largest Free Block` and, if the log shows a
  `display took a long time for an operation` warning, its figure.
- [ ] **8.6 The unit updates itself.** After the next release (a
  version-only one will do). Pass: the C6 unit installs it from the
  `Firmware` entity and comes back on the new version with reset reason
  "Reboot request from http_request.update".
- [ ] **8.7 An S2 unit still updates.** Pass: an S2 unit on 1.2.4 offers
  and installs 1.3.0 from the same manifest.
