jrytio/desiccant-dryer/docs/hardware/mains-schematic.pdf

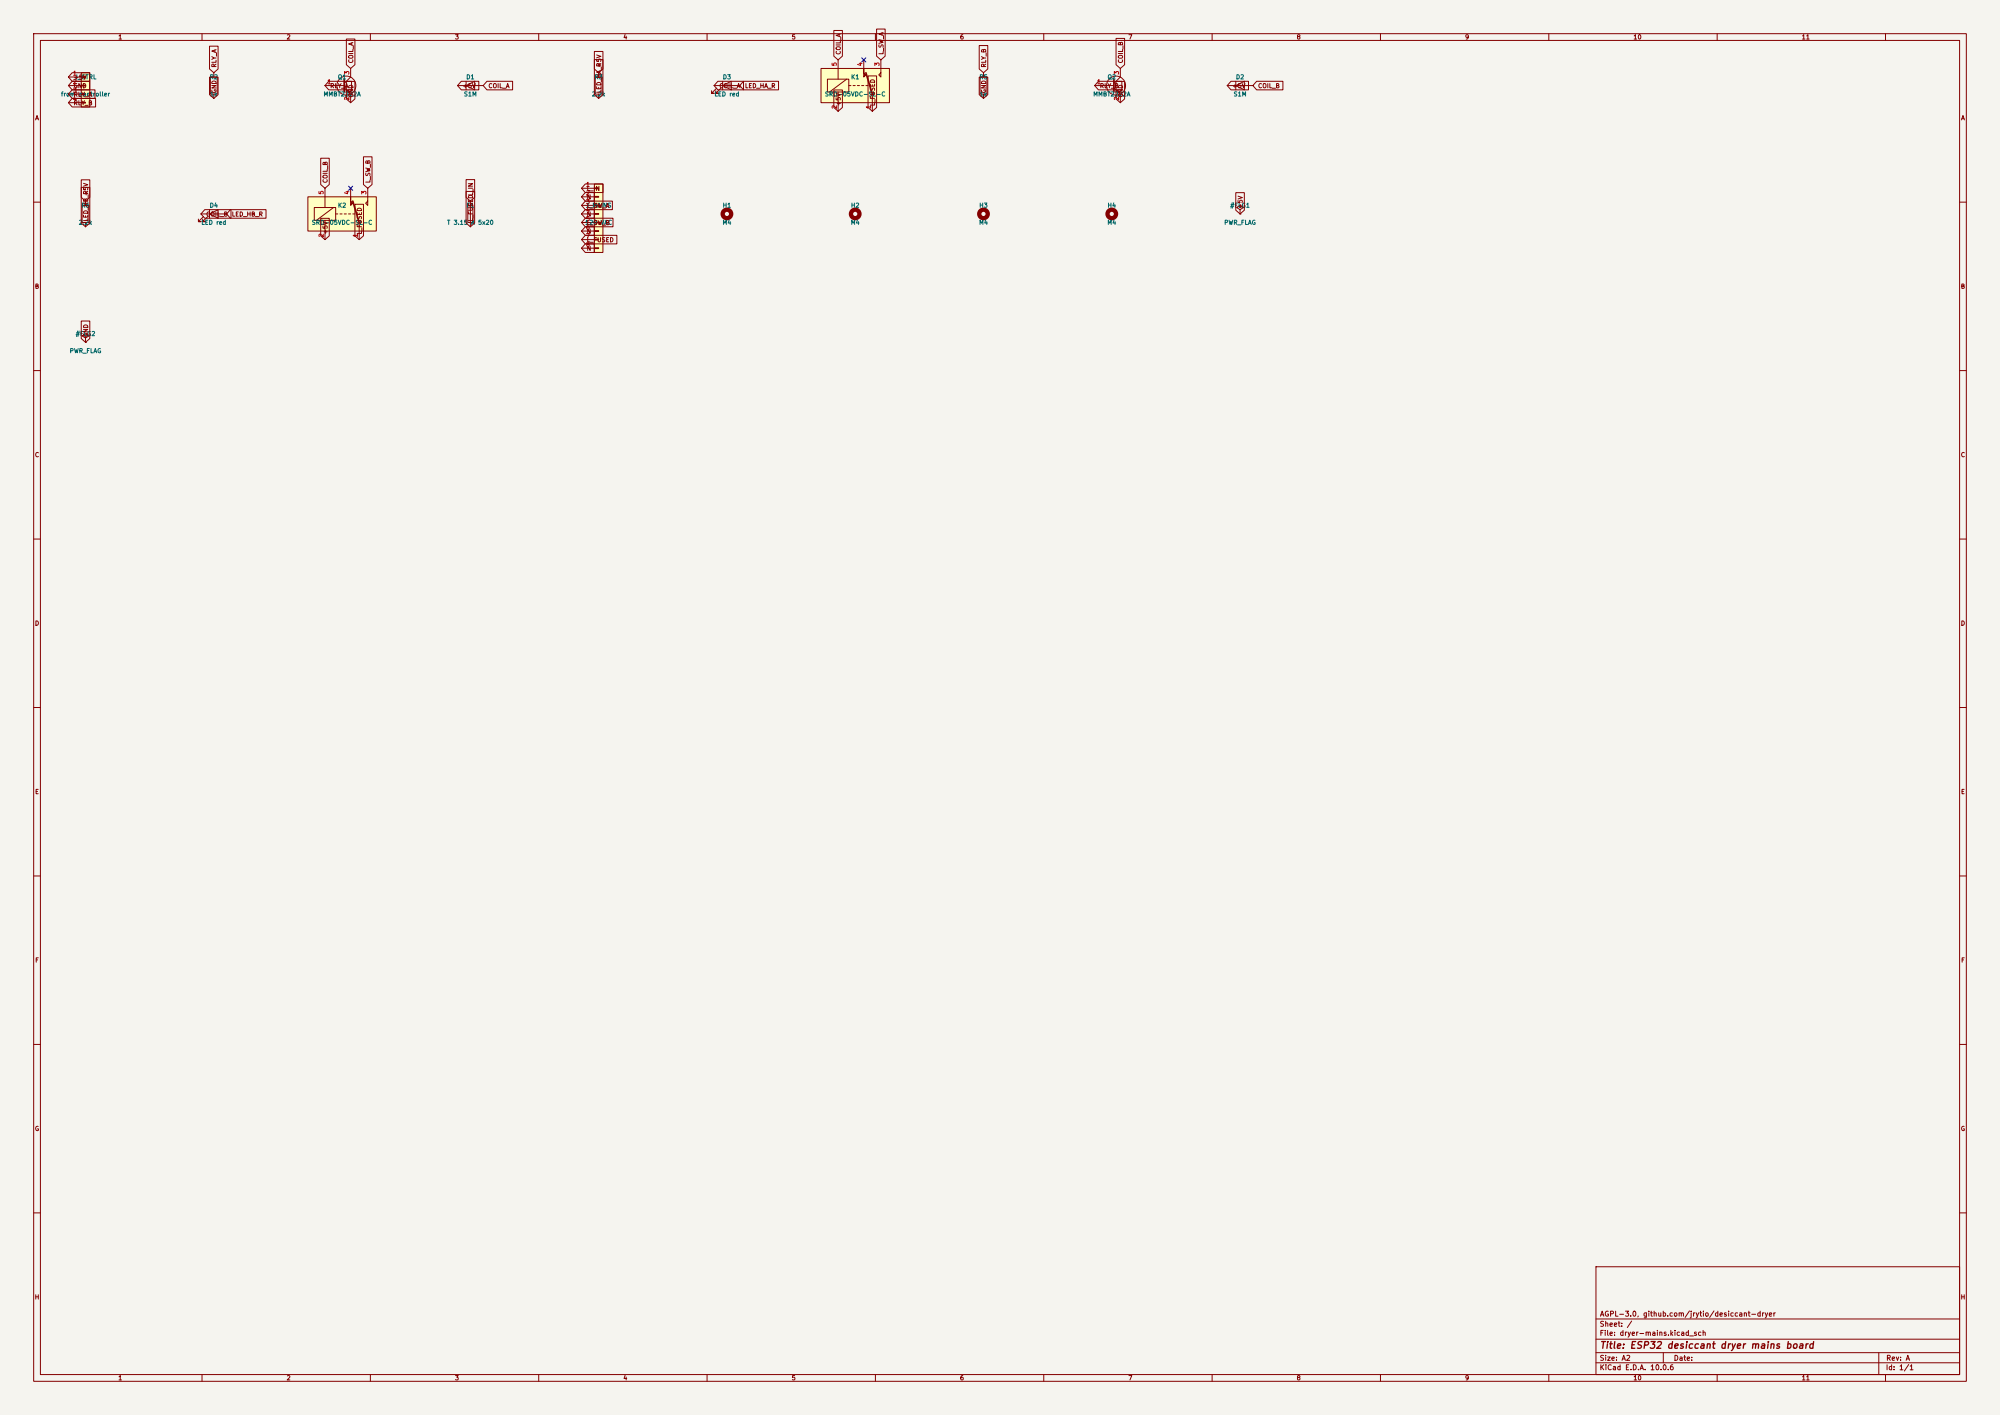
[picture p13: page 1]

AGPL-3.0, github.com/jrytio/desiccant-dryer
Sheet: /
File: dryer-mains.kicad_sch
Title: ESP32 desiccant dryer mains board

Size: A2 | Rev: A
KiCad E.D.A. 10.0.6 | Id: 1/1
