jrytio/desiccant-dryer/docs/hardware/controller-schematic.pdf

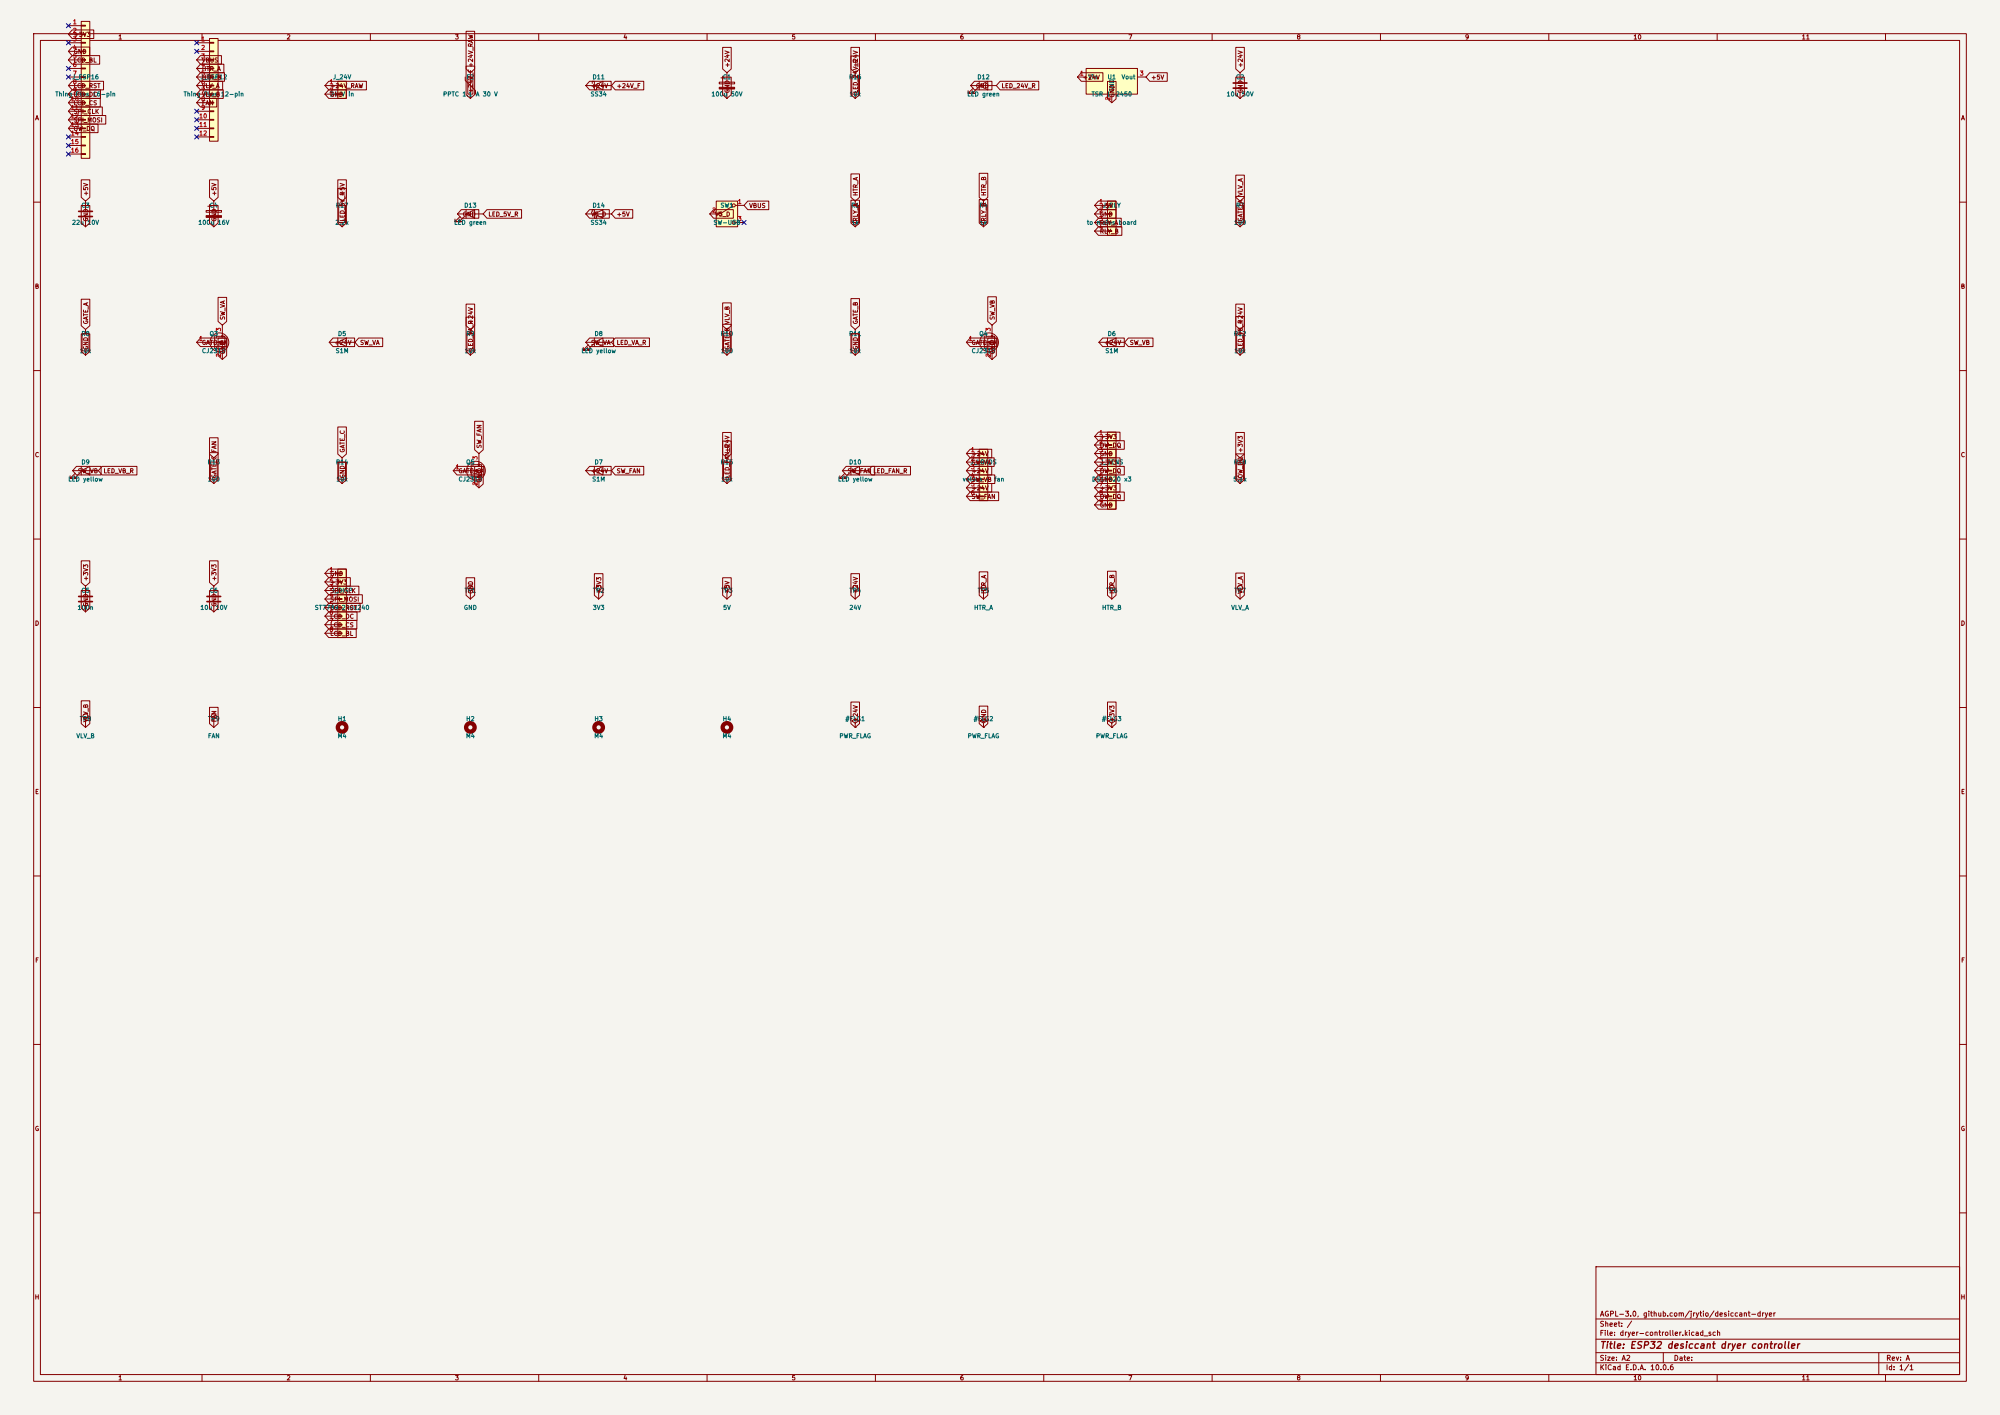
[picture p14: page 1]

AGPL-3.0, github.com/jrytio/desiccant-dryer
Sheet: /
File: dryer-controller.kicad_sch
Title: ESP32 desiccant dryer controller

Size: A2 | Rev: A
KiCad E.D.A. 10.0.6 | Id: 1/1
