jrytio/desiccant-dryer/hardware/dryer-mains/dryer-mains.kicad_pcb

## KiCad design hardware/dryer-mains/dryer-mains.kicad_pcb (2026-10-16)

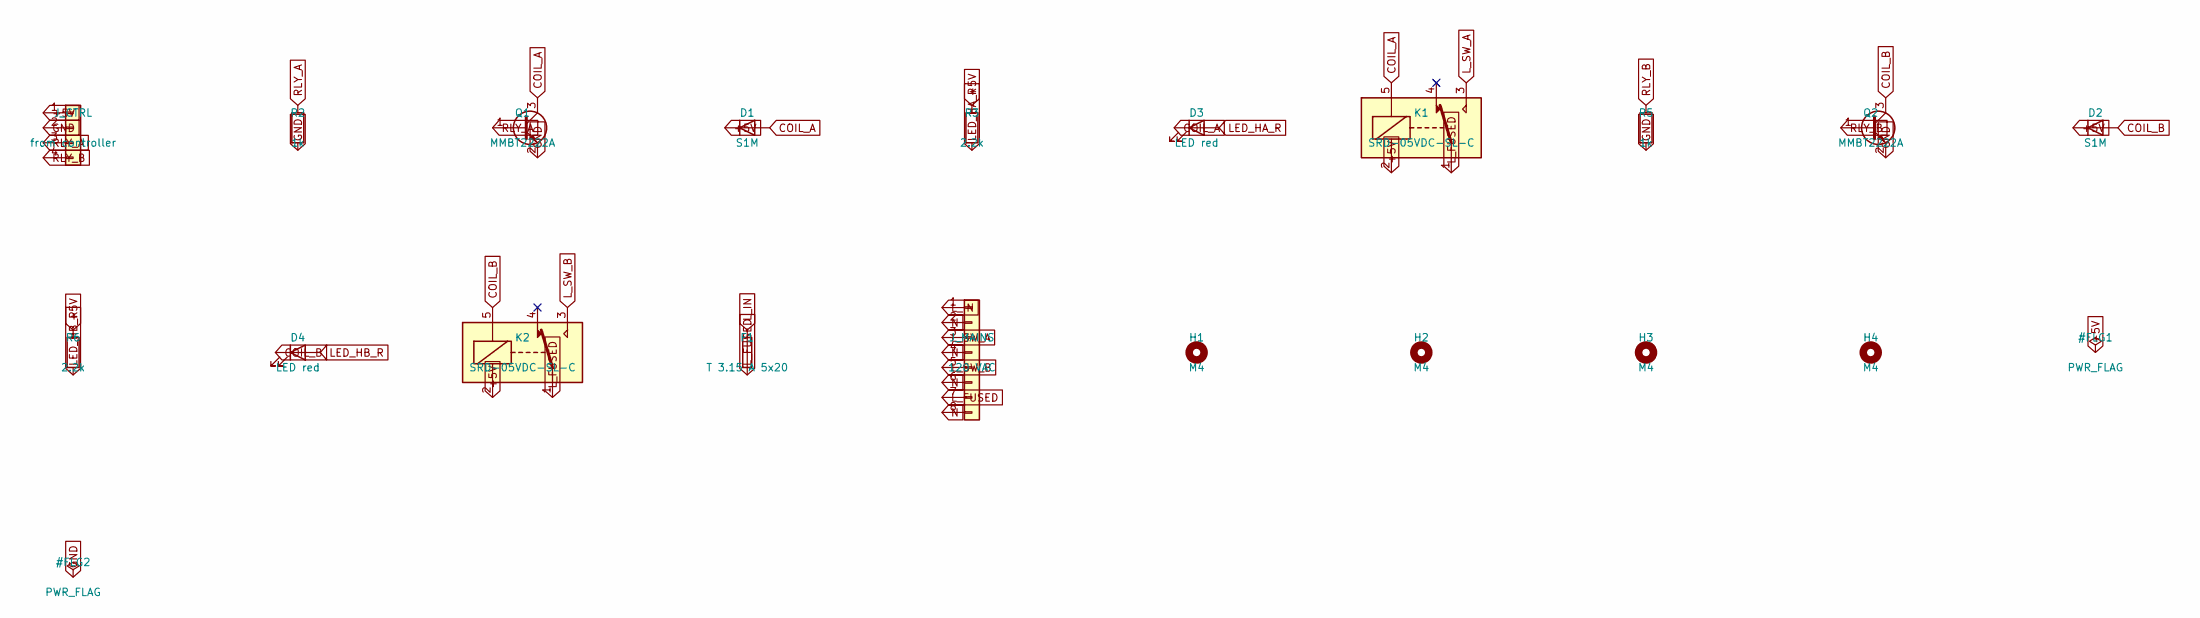
[picture p15: schematic dryer-mains.kicad_sch, ESP32 desiccant dryer mains board]

Parts:
D1, D2: S1M; D_SMA; LCSC C95872
D3, D4: LED red; LED_0805_2012Metric; LCSC C84256
F1: T 3.15 A 5x20; Fuseholder_5x20mm_Covered_P12.50mm_Slot
H1, H2, H3, H4: M4; MountingHole_4.3mm_M4
J_CTRL: from controller; JST_XH_B4B-XH-A_1x04_P2.50mm_Vertical; LCSC C144395
J_MAINS: 120 VAC; PhoenixContact_MSTBVA_2,5_8-G-5,08_1x08_P5.08mm_Vertical_Dr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; LCSC C395787
K1, K2: SRD-05VDC-SL-C; Relay_SPDT_SANYOU_SRD_Series_Form_C; LCSC C35449
Q1, Q2: MMBT2222A; SOT-23; LCSC C8512
R2, R5: 1k; R_0805_2012Metric; LCSC C17513
R3, R6: 2.2k; R_0805_2012Metric; LCSC C17520

Connections:
+5V: D1.1 (K), D2.1 (K), J_CTRL.1, K1.2, K2.2, R3.1, R6.1
COIL_A: D1.2 (A), D3.1 (K), K1.5, Q1.3 (C)
COIL_B: D2.2 (A), D4.1 (K), K2.5, Q2.3 (C)
GND: J_CTRL.2, Q1.2 (E), Q2.2 (E), R2.2, R5.2
LED_HA_R: D3.2 (A), R3.2
LED_HB_R: D4.2 (A), R6.2
L_FUSED: F1.2, J_MAINS.7, K1.1, K2.1
L_IN: F1.1, J_MAINS.1
L_SW_A: J_MAINS.3, K1.3
L_SW_B: J_MAINS.5, K2.3
N: J_MAINS.2, J_MAINS.4, J_MAINS.6, J_MAINS.8
RLY_A: J_CTRL.3, Q1.1 (B), R2.1
RLY_B: J_CTRL.4, Q2.1 (B), R5.1

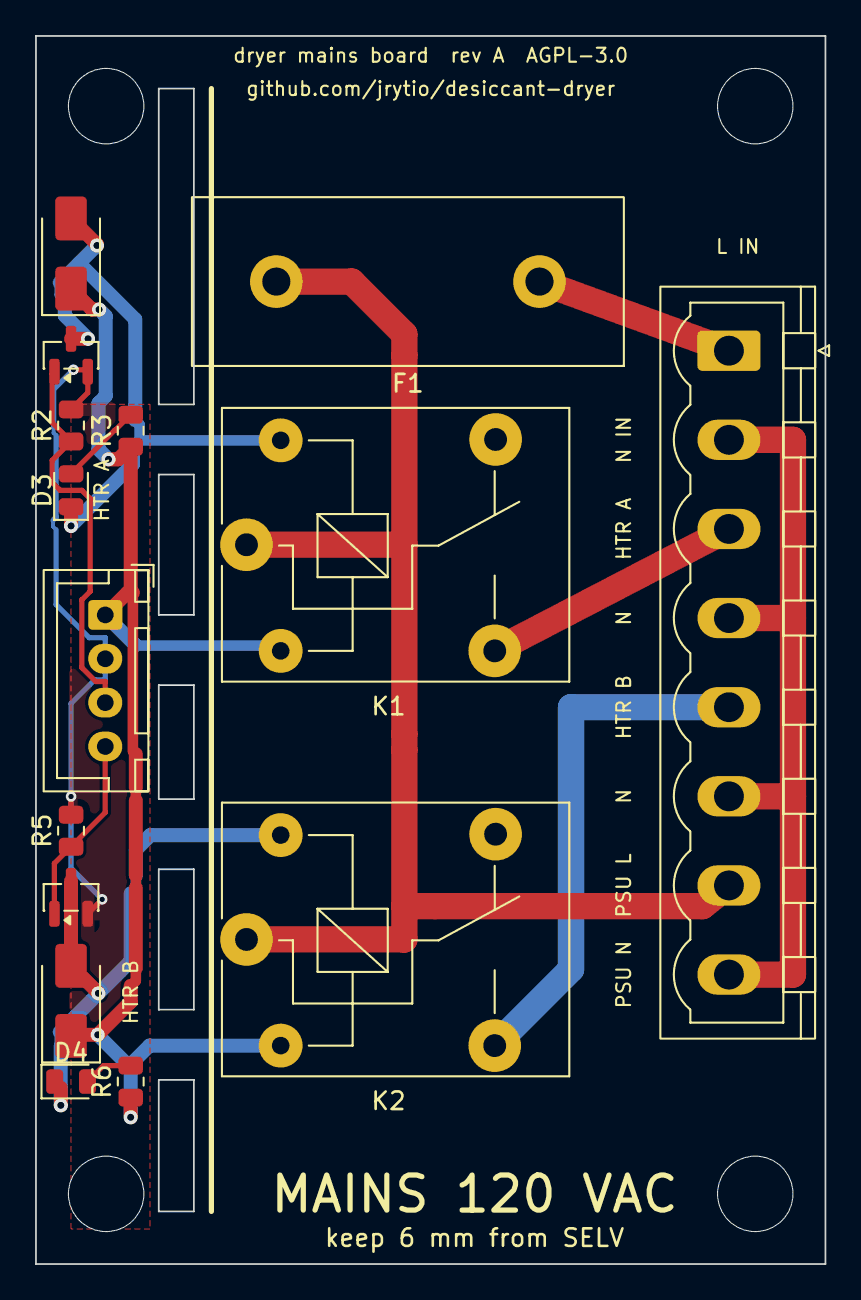
[picture p16: board dryer-mains.kicad_pcb from above]

Board: 2 copper layers, 45.0 x 70.0 mm, 19 parts (0 on the bottom side), 13 nets.
