jrytio/desiccant-dryer/hardware/dryer-controller/dryer-controller.kicad_pcb

## KiCad design hardware/dryer-controller/dryer-controller.kicad_pcb (2026-10-15)

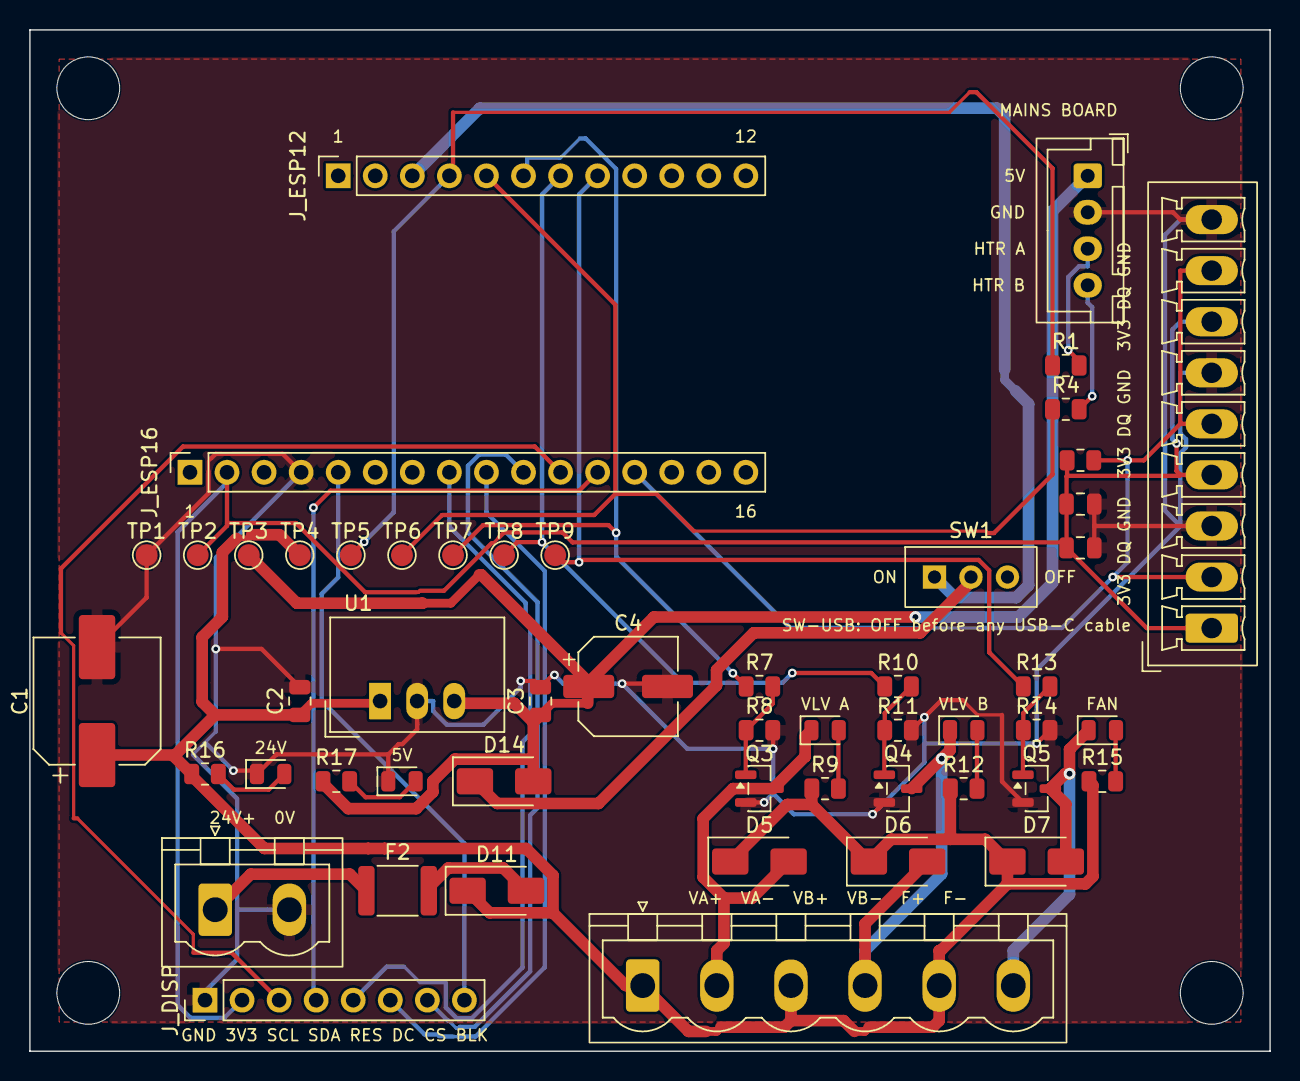
[picture p17: board dryer-controller.kicad_pcb from above]

Board: 2 copper layers, 85.0 x 70.0 mm, 56 parts (0 on the bottom side), 33 nets.

Parts:
C1: 100u 50V; CP_Elec_8x10.5
C2: 10u 50V; C_0805_2012Metric
C3: 22u 10V; C_0805_2012Metric
C4: 100u 16V; CP_Elec_6.3x7.7
C5: 100n; C_0805_2012Metric
C6: 10u 10V; C_0805_2012Metric
D5, D6, D7: S1M; D_SMA
D8, D9, D10: LED yellow; LED_0805_2012Metric
D11, D14: SS34; D_SMA
D12, D13: LED green; LED_0805_2012Metric
F2: PPTC 1.1 A 30 V; Fuse_1812_4532Metric
H1, H2, H3, H4: M4; MountingHole_4.3mm_M4
J_24V: 24 V in; PhoenixContact_MSTBVA_2,5_2-G-5,08_1x02_P5.08mm_Vertical_Dr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
J_DISP: ST7789 240x240; PinHeader_1x08_P2.54mm_Vertical
J_ESP12: Thing Plus 12-pin; PinSocket_1x12_P2.54mm_Vertical
J_ESP16: Thing Plus 16-pin; PinSocket_1x16_P2.54mm_Vertical
J_LOADS: valves + fan; PhoenixContact_MSTBVA_2,5_6-G-5,08_1x06_P5.08mm_Vertical_Dr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
J_RLY: to mains board; JST_XH_B4B-XH-A_1x04_P2.50mm_Vertical
J_SENS: DS18B20 x3; PhoenixContact_MCV_1,5_9-G-3.5_1x09_P3.50mm_Vertical_Drill1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
Q3, Q4, Q5: CJ2310; SOT-23
R1, R4: 1k; R_0805_2012Metric
R7, R10, R13: 100; R_0805_2012Metric
R8, R9, R11, R12, R14, R15, R16: 10k; R_0805_2012Metric
R17: 2.2k; R_0805_2012Metric
R18: 5.1k; R_0805_2012Metric
SW1: SW-USB; SW_Slide_SPDT_SOFNG_SS-12D00_P2.50mm
TP1: GND; TestPoint_Pad_D1.5mm
TP2: 3V3; TestPoint_Pad_D1.5mm
TP3: 5V; TestPoint_Pad_D1.5mm
TP4: 24V; TestPoint_Pad_D1.5mm
TP5: HTR_A; TestPoint_Pad_D1.5mm
TP6: HTR_B; TestPoint_Pad_D1.5mm
TP7: VLV_A; TestPoint_Pad_D1.5mm
TP8: VLV_B; TestPoint_Pad_D1.5mm
TP9: FAN; TestPoint_Pad_D1.5mm
U1: TSR 1-2450; Converter_DCDC_TRACO_TSR-1_THT

Connections:
+3V3: C5.1, C6.1, J_DISP.2, J_ESP16.2, J_SENS.1, J_SENS.4, J_SENS.7, R18.1, TP2.1
+5V: C3.1, C4.1, D14.2, J_RLY.1, R17.1, TP3.1, U1.3
+24V: C1.1, C2.1, D5.1, D6.1, D7.1, D11.1, J_LOADS.1, J_LOADS.3, J_LOADS.5, R9.1, R12.1, R15.1, R16.1, TP4.1, U1.1
+24V_F: D11.2, F2.2
+24V_RAW: F2.1, J_24V.1
FAN: J_ESP12.8, R13.1, TP9.1
GATE_A: Q3.1, R7.2, R8.1
GATE_B: Q4.1, R10.2, R11.1
GATE_C: Q5.1, R13.2, R14.1
GND: C1.2, C2.2, C3.2, C4.2, C5.2, C6.2, D12.1, D13.1, J_24V.2, J_DISP.1, J_ESP16.4, J_RLY.2, J_SENS.3, J_SENS.6, J_SENS.9, Q3.2, Q4.2, Q5.2, R8.2, R11.2, R14.2, TP1.1, U1.2
HTR_A: J_ESP12.4, R1.1, TP5.1
HTR_B: J_ESP12.5, R4.1, TP6.1
LCD_BL: J_DISP.8, J_ESP16.5
LCD_CS: J_DISP.7, J_ESP16.10
LCD_DC: J_DISP.6, J_ESP16.9
LCD_RST: J_DISP.5, J_ESP16.8
LED_5V_R: D13.2, R17.2
LED_24V_R: D12.2, R16.2
LED_FAN_R: D10.2, R15.2
LED_VA_R: D8.2, R9.2
LED_VB_R: D9.2, R12.2
OW_DQ: J_ESP16.13, J_SENS.2, J_SENS.5, J_SENS.8, R18.2
RLY_A: J_RLY.3, R1.2
RLY_B: J_RLY.4, R4.2
SPI_CLK: J_DISP.3, J_ESP16.11
SPI_MOSI: J_DISP.4, J_ESP16.12
SW_FAN: D7.2, D10.1, J_LOADS.6, Q5.3
SW_VA: D5.2, D8.1, J_LOADS.2, Q3.3
SW_VB: D6.2, D9.1, J_LOADS.4, Q4.3
V5_D: D14.1, SW1.2
VBUS: J_ESP12.3, SW1.1
VLV_A: J_ESP12.6, R7.1, TP7.1
VLV_B: J_ESP12.7, R10.1, TP8.1
