jrytio/desiccant-dryer/docs/datasheets/mcu/sparkfun-esp32-s2-thing-plus.brd

## EAGLE design docs/datasheets/mcu/sparkfun-esp32-s2-thing-plus.brd (2026-09-15)

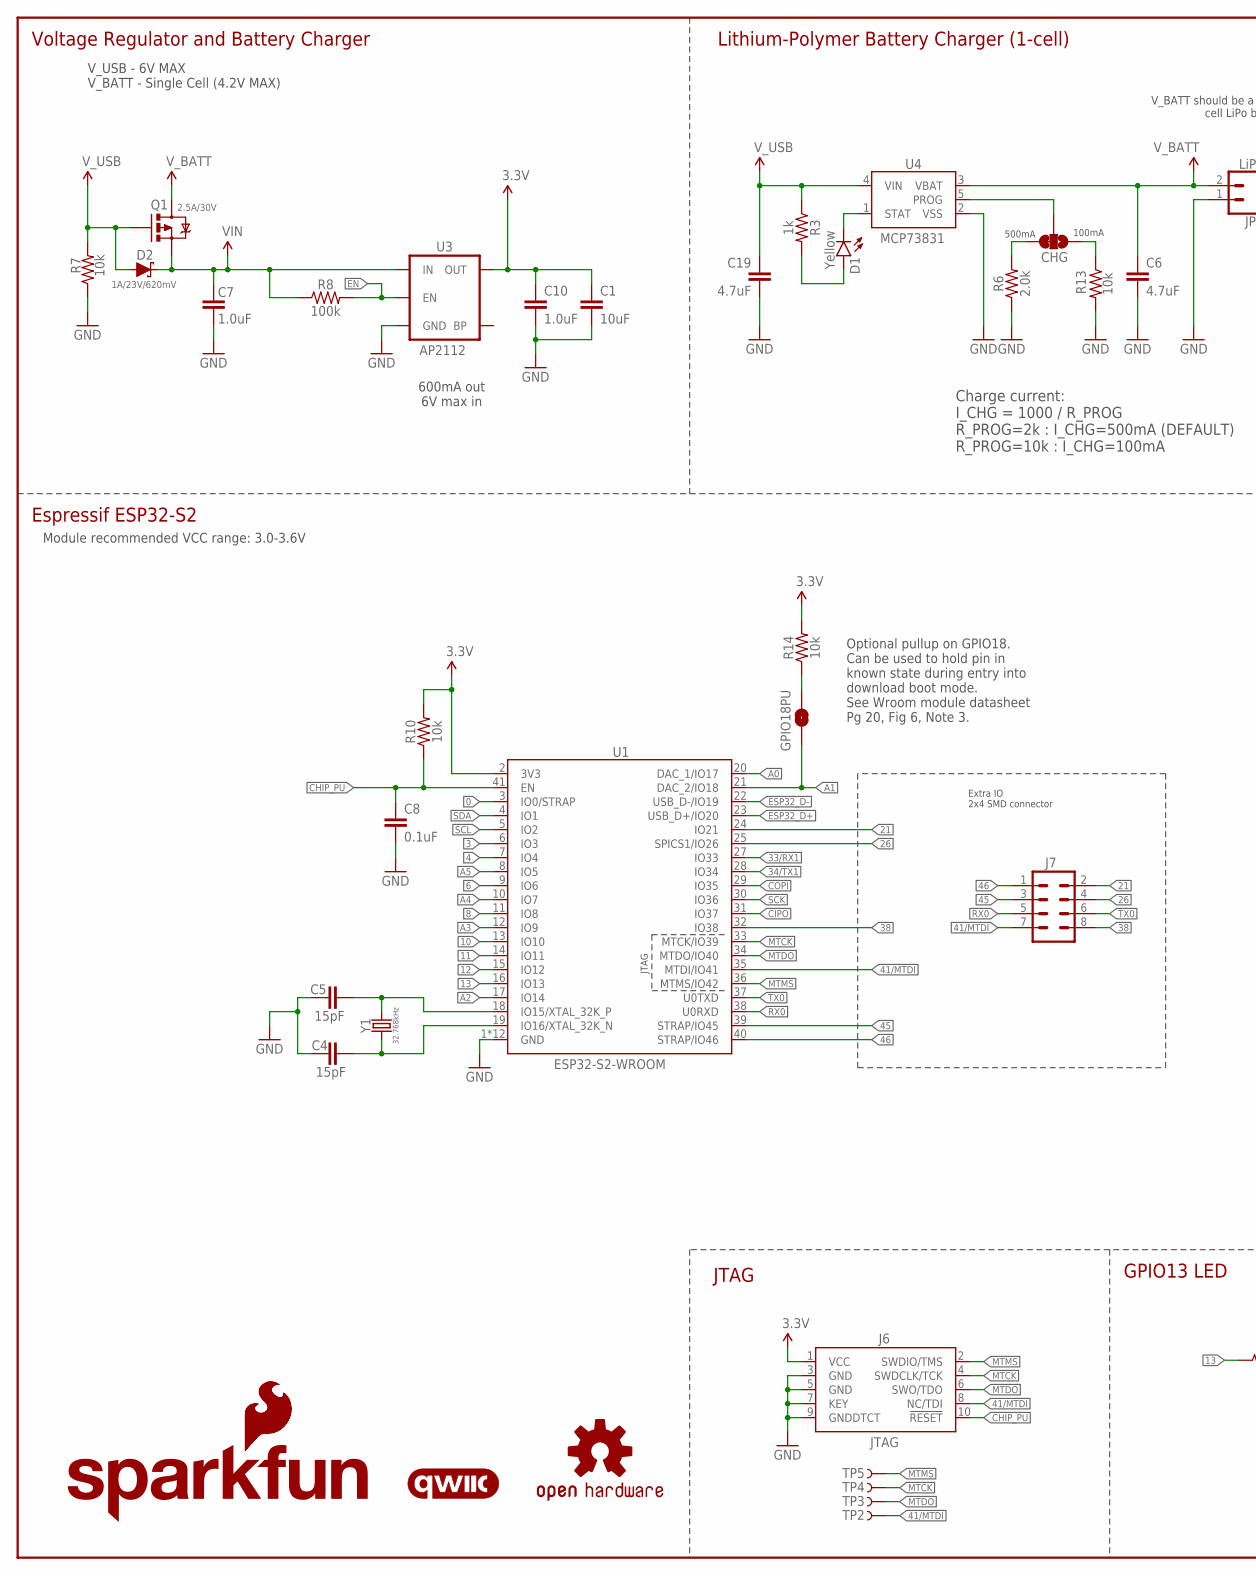
[picture p18: schematic sparkfun-esp32-s2-thing-plus.sch, part in row 1, column 1]

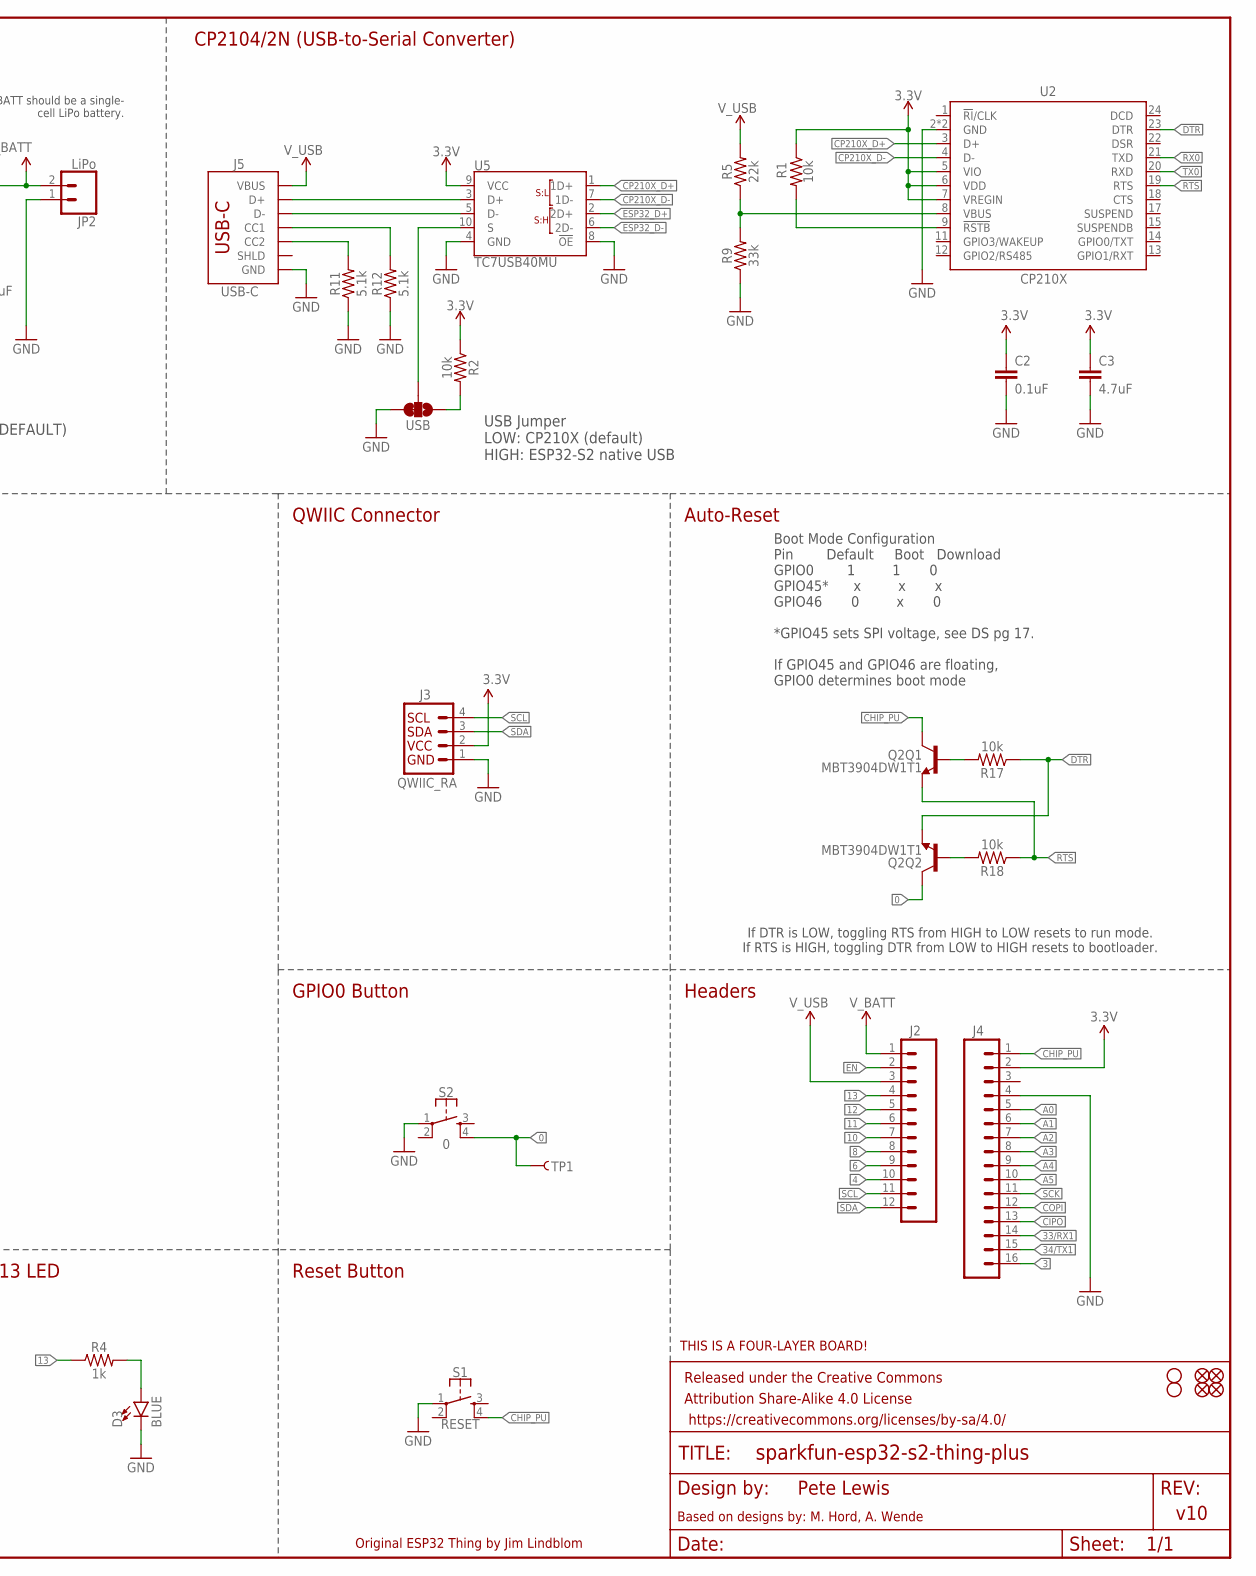
[picture p19: schematic sparkfun-esp32-s2-thing-plus.sch, part in row 1, column 2]

Parts:
C1: 10uF; 0402-TIGHT
C2, C8: 0.1uF; 0402-TIGHT
C3, C6, C19: 4.7uF; 0402-TIGHT
C4, C5: 15pF; 0402-TIGHT
C7, C10: 1.0uF; 0402-TIGHT
CHG: JUMPER-SMT_3_1-NC_TRACE_SILK; SMT-JUMPER_3_1-NC_TRACE_SILK
D1: Yellow; LED-0603
D2: 1A/23V/620mV; SOD-323
D3: BLUE; LED-0603
FD1, FD2, FD3, FD4: FIDUCIALUFIDUCIAL; FIDUCIAL-MICRO
FRAME1: FRAME-LEDGER; CREATIVE_COMMONS
GPIO18PU: JUMPER-SMT_2_NO_SILK; SMT-JUMPER_2_NO_SILK
H1, H2: STAND-OFF
J2: CONN_12SM_SQ_NO_SILK; 1X12_SM_SQ_NOSILK
J3: QWIIC_RA; JST04_1MM_RA
J4: CONN_161X16_SM_SQ_NOSILK; 1X16_SM_SQ_NOSILK
J5: USB-C; USB-C-16P-4LAYER-ISOLATED
J6: JTAG; 2X5-PTH-1.27MM-NO_SILK
J7: CONN_04X2_SMT_NO_POSTS_NS; 2X4_SMT_NO_POSTS_NS
JP2: LiPo; JST-2-SMD
LOGO1: SFE_LOGO_FLAME.1_INCH; SFE_LOGO_FLAME_.1
LOGO2: OSHW-LOGOMINI; OSHW-LOGO-MINI
LOGO3: SFE_LOGO_NAME_FLAME.1_INCH; SFE_LOGO_NAME_FLAME_.1
LOGO4: FOUR_LAYER_WARNING
LOGO6: QWIIC_LOGO_4MM; QWIIC_4MM
Q1: 2.5A/30V; SOT23-3@1
Q2: MBT3904DW1T1; SC70-6
R1, R2, R7, R10, R13, R14, R17, R18: 10k; 0402-TIGHT
R3, R4: 1k; 0402-TIGHT
R5: 22k; 0402-TIGHT
R6: 2.0k; 0603
R8: 100k; 0402-TIGHT
R9: 33k; 0402-TIGHT
R11, R12: 5.1k; 0402-TIGHT
S1: RESET; TACTILE_SWITCH_SMD_4.6X2.8MM
S2: 0; TACTILE_SWITCH_SMD_4.6X2.8MM
TP1: TEST-POINTTP_15TH_THRU; TP_15TH
TP2, TP3, TP4, TP5: TEST-POINT3X4; PAD.03X.04
U1: ESP32-S2-WROOM
U2: CP210X; QFN24
U3: AP2112; SOT23-5
U4: MCP73831; SOT23-5
U5: TC7USB40MU; UQFN10
USB: JUMPER-SMT_3_1-NC_TRACE_SILK; SMT-JUMPER_3_1-NC_TRACE_SILK
Y1: 32.768kHz; CRYSTAL-SMD-3.2X1.5MM

Connections:
0: Q2.6 (C), S2.4, TP1.P$1, U1.3 (IO0/STRAP)
3: J4.16, U1.6 (IO3)
3.3V: C1.1, C2.1, C3.1, C10.1, J3.2, J4.2, J6.1 (VCC), R1.1, R2.1, R10.2, R14.2, U1.2 (3V3), U2.5 (VIO), U2.6 (VDD), U2.7 (VREGIN), U3.5 (OUT), U5.9 (VCC)
4: J2.10, U1.7 (IO4)
6: J2.9, U1.9 (IO6)
8: J2.8, U1.11 (IO8)
10: J2.7, U1.13 (IO10)
11: J2.6, U1.14 (IO11)
12: J2.5, U1.15 (IO12)
13: J2.4, R4.1, U1.16 (IO13)
21: J7.2, U1.24 (IO21)
26: J7.4, U1.25 (SPICS1/IO26)
33/RX1: J4.14, U1.27 (IO33)
34/TX1: J4.15, U1.28 (IO34)
38: J7.8, U1.32 (IO38)
41/MTDI: J6.8 (NC/TDI), J7.7, TP2.P$1, U1.35 (MTDI/IO41)
45: J7.3, U1.39 (STRAP/IO45)
46: J7.1, U1.40 (STRAP/IO46)
A0: J4.5, U1.20 (DAC_1/IO17)
A1: GPIO18PU.1, J4.6, U1.21 (DAC_2/IO18)
A2: J4.7, U1.17 (IO14)
A3: J4.8, U1.12 (IO9)
A4: J4.9, U1.10 (IO7)
A5: J4.10, U1.8 (IO5)
CC1: J5.A5 (CC1), R12.2
CC2: J5.B5 (CC2), R11.2
CHG: D1.C, U4.1 (STAT)
CHIP_PU: C8.1, J4.1, J6.10 (!RESET), Q2.3 (C), R10.1, S1.4, U1.41 (EN)
CIPO: J4.13, U1.31 (IO37)
COPI: J4.12, U1.29 (IO35)
CP210X_D+: U2.3 (D+), U5.1 (1D+)
CP210X_D-: U2.4 (D-), U5.7 (1D-)
DTR: Q2.1 (E), R17.1, U2.23 (DTR)
EN: J2.2, R8.2, U3.3 (EN)
ESP32_D+: U1.23 (USB_D+/IO20), U5.2 (2D+)
ESP32_D-: U1.22 (USB_D-/IO19), U5.6 (2D-)
GND: C1.2, C2.2, C3.2, C4.1, C5.1, C6.2, C7.2, C8.2, C10.2, C19.2, D3.C, J3.1, J4.4, J5.GND, J5.GND2 (GND), J6.3 (GND), J6.5 (GND), J6.7 (KEY), J6.9 (GNDDTCT), JP2.1 (2), R6.1, R7.1, R9.1, R11.1, R12.1, R13.2, S1.1, S2.1, U1.1 (GND), U1.26 (GND), U1.42 (GND), U1.GNDEP0 (GND), U1.GNDEP1 (GND), U1.GNDEP2 (GND), U1.GNDEP3 (GND), U1.GNDEP4 (GND), U1.GNDEP5 (GND), U1.GNDEP6 (GND), U1.GNDEP7 (GND), U1.GNDEP8 (GND), U2.2 (GND), U2.PAD (GND), U3.2 (GND), U4.2 (VSS), U5.4 (GND), U5.8 (!OE!), USB.3
MTCK: J6.4 (SWDCLK/TCK), TP4.P$1, U1.33 (MTCK/IO39)
MTDO: J6.6 (SWO/TDO), TP3.P$1, U1.34 (MTDO/IO40)
MTMS: J6.2 (SWDIO/TMS), TP5.P$1, U1.36 (MTMS/IO42)
unnamed: R1.2, U2.9 (!RSTB)
unnamed: D3.A, R4.2
unnamed: J5.A6 (D+), J5.B6 (D+), U5.3 (D+)
unnamed: R5.1, R9.2, U2.8 (VBUS)
unnamed: J5.A7 (D-), J5.B7 (D-), U5.5 (D-)
unnamed: R2.2, USB.1
unnamed: C5.2, U1.18 (IO15/XTAL_32K_P), Y1.P$2 (2)
unnamed: C4.2, U1.19 (IO16/XTAL_32K_N), Y1.P$1 (1)
unnamed: CHG.2, U4.5 (PROG)
unnamed: Q2.5 (B), R17.2
unnamed: CHG.1, R13.1
unnamed: Q2.2 (B), R18.2
unnamed: CHG.3, R6.2
unnamed: GPIO18PU.2, R14.1
unnamed: D1.A, R3.2
RTS: Q2.4 (E), R18.1, U2.19 (RTS)
RX0: J7.5, U1.38 (U0RXD), U2.21 (TXD)
SCK: J4.11, U1.30 (IO36)
SCL: J2.11, J3.4, U1.5 (IO2)
SDA: J2.12, J3.3, U1.4 (IO1)
TX0: J7.6, U1.37 (U0TXD), U2.20 (RXD)
USB_SEL: U5.10 (S), USB.2
VIN: C7.1, D2.C, Q1.2 (S), R8.1, U3.1 (IN)
V_BATT: C6.1, J2.1, JP2.2 (1), Q1.3 (D), U4.3 (VBAT)
V_USB: C19.1, D2.A, J2.3, J5.VBUS1 (VBUS), J5.VBUS2 (VBUS), Q1.1 (G), R3.1, R5.2, R7.2, U4.4 (VIN)

Notes on the sheet:
Boot Mode Configuration Pin Default Boot Download GPIO0 1 1 0 GPIO45* x x x GPIO46 0 x 0 *GPIO45 sets SPI voltage, see DS pg 17. If GPIO45 and GPIO46 are floating, GPIO0 determines boot mode
CP2104/2N (USB-to-Serial Converter)
V_BATT should be a single- cell LiPo battery.
Charge current: I_CHG = 1000 / R_PROG R_PROG=2k : I_CHG=500mA (DEFAULT) R_PROG=10k : I_CHG=100mA
Voltage Regulator and Battery Charger
Lithium-Polymer Battery Charger (1-cell)
600mA out 6V max in
Auto-Reset
Espressif ESP32-S2
Reset Button
Headers
v10
Original ESP32 Thing by Jim Lindblom
If DTR is LOW, toggling RTS from HIGH to LOW resets to run mode. If RTS is HIGH, toggling DTR from LOW to HIGH resets to bootloader.
QWIIC Connector
Pete Lewis
GPIO13 LED
GPIO0 Button
Based on designs by: M. Hord, A. Wende
V_USB - 6V MAX V_BATT - Single Cell (4.2V MAX)
100mA
500mA
Extra IO 2x4 SMD connector
JTAG
Module recommended VCC range: 3.0-3.6V
USB Jumper LOW: CP210X (default) HIGH: ESP32-S2 native USB
Optional pullup on GPIO18. Can be used to hold pin in known state during entry into download boot mode. See Wroom module datasheet Pg 20, Fig 6, Note 3.

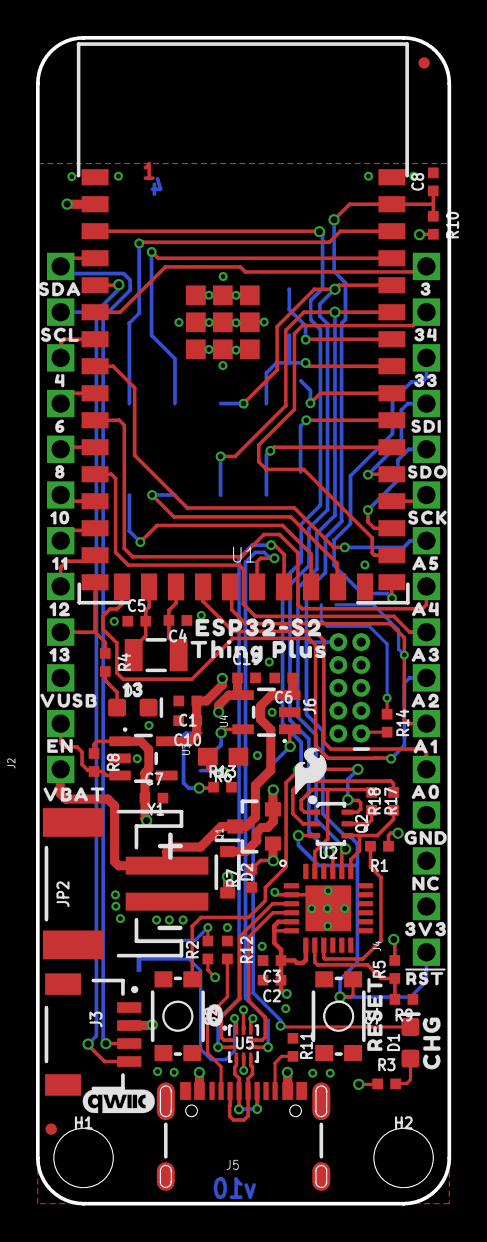
[picture p20: board sparkfun-esp32-s2-thing-plus.brd from above]

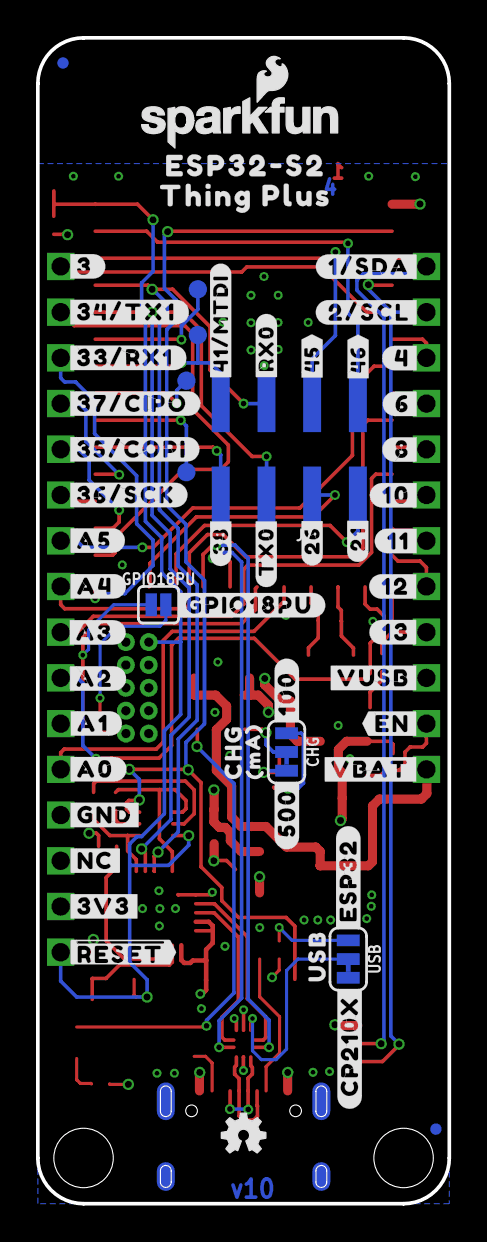
[picture p21: board sparkfun-esp32-s2-thing-plus.brd from below]

Board: 4 copper layers, 22.9 x 64.8 mm, 147 parts (58 on the bottom side), 65 nets.

Other parts of the board:
U$1: #CP210X#0
U$2: SDI0
U$3, U$78: CHG0
U$4: #500#0
U$5: ESP32#S20
U$6: SDO0
U$7: #RST#0
U$8: #46#0
U$9: #ESP32#0
U$10: #45#0
U$11: MA0
U$12: #A5#0
U$14: USB0
U$15: 110
U$16: #GPIO18PU#0
U$17: 100
U$18: 80
U$19: #A4#0
U$20: 60
U$21: #A2#0
U$22: #A3#0
U$23: 40
U$24: 330
U$25: SDA0
U$26: SCL0
U$28: #A0#0
U$29: 340
U$30: 30
U$31: #36#SCK#0
U$32: #GND#0
U$33: #35#COPI#0
U$34: #37#CIPO#0
U$35: #33#RX1#0
U$36: #34#TX1#0
U$37: #3#0
U$38: #41#MTDI#0
U$39: #12#0
U$40: #13#0
U$41: #VUSB#0
U$42: #VBAT#0
U$43: #EN#0
U$44: #NC#0
U$45: #3V3#0
U$46: ##RESET##0
U$47: #11#0
U$48: #6#0
U$49: #8#0
U$50: #10#0
U$51: #4#0
U$52: #1#SDA#0
U$53: #2#SCL#0
U$54: #21#0
U$55: #26#0
U$56: #TX0#0
U$57: #38#0
U$58: #RX0#0
U$59: ORDERING_INSTRUCTIONS
U$60: #100#0
U$61: THING_PLUS0
U$62: THING_PLUS_0
U$63: ESP32#S2_0
U$64: #A1#0
U$72: 120
U$73, U$74: 130
U$75: VUSB0
U$76: EN0
U$77: VBAT0
U$79: RESET0
U$81: 3V30
U$82: NC0
U$83: GND0
U$84: A00
U$85: A10
U$86: A20
U$87: A30
U$88: A40
U$89: A50
U$90: SCK0
U$96: 00
