jrytio/desiccant-dryer/hardware/dryer_board/mains.py

# hardware/dryer_board/mains.py
"""The mains board: the fuse, the two relays and their drivers, the 120 VAC plug, and the
keyed 4-way link from the controller board (controller.py), on a 45 x 70 mm board (the mains
space in the enclosure). The mains copper keeps the rev A single board's arrangement (a spine
between the relay coils and contacts, L_IN and L_FUSED on opposite layers, N linked beside
the plug) and the distances it held. Parts and nets first, then placement (mm, origin at the
board's top-left corner, y down, rotation counter-clockwise on screen), then the DRC rules."""
from typing import List
from . import parts
from .parts import Part, NC

PROJECT = "dryer-mains"
SHORT = "mains"
TITLE = "ESP32 desiccant dryer mains board"
REVISION = "A"

MAINS_NETS = ["L_IN", "L_FUSED", "L_SW_A", "L_SW_B", "N"]
MAINS_PARTS = ("J_MAINS", "F1", "K1", "K2")   # the only parts a mains net may reach

# name -> (track width mm, clearance mm, via diameter mm, via drill mm, net name patterns)
NETCLASSES = {
    "Default": (0.3, 0.2, 0.6, 0.3, []),
    "MAINS":   (1.5, 1.0, 1.2, 0.6, MAINS_NETS),
    "P5":      (0.8, 0.2, 0.8, 0.4, ["+5V", "COIL_A", "COIL_B"]),
}

PARTS: List[Part] = [
    # The link from the controller: 5 V for the coils, GND, and the two base drives, each
    # already through its 1k series resistor on the controller board.
    parts.link("J_CTRL", "from controller"),

    # Relay stage A (heater A): 1k pulldown, MMBT2222A, S1M flyback, LED, Songle relay
    parts.r("R2", "1k", "RLY_A", "GND", d="heater A base pulldown, holds the relay off with the link unplugged"),
    parts.npn("Q1", "RLY_A", "GND", "COIL_A"),
    parts.s1m("D1", "+5V", "COIL_A"),
    parts.r("R3", "2.2k", "+5V", "LED_HA_R"), parts.led("D3", "red", "COIL_A", "LED_HA_R"),
    Part("K1", "SRD-05VDC-SL-C", "Relay:SANYOU_SRD_Form_C", "Relay_THT:Relay_SPDT_SANYOU_SRD_Series_Form_C",
         {"1": "L_FUSED", "2": "+5V", "5": "COIL_A", "3": "L_SW_A", "4": NC}, "C35449", False,
         "heater A relay; Songle SRD-05VDC-SL-C; JLCPCB extended"),
    # Relay stage B (heater B)
    parts.r("R5", "1k", "RLY_B", "GND", d="heater B base pulldown"),
    parts.npn("Q2", "RLY_B", "GND", "COIL_B"),
    parts.s1m("D2", "+5V", "COIL_B"),
    parts.r("R6", "2.2k", "+5V", "LED_HB_R"), parts.led("D4", "red", "COIL_B", "LED_HB_R"),
    Part("K2", "SRD-05VDC-SL-C", "Relay:SANYOU_SRD_Form_C", "Relay_THT:Relay_SPDT_SANYOU_SRD_Series_Form_C",
         {"1": "L_FUSED", "2": "+5V", "5": "COIL_B", "3": "L_SW_B", "4": NC}, "C35449", False,
         "heater B relay; Songle SRD-05VDC-SL-C; JLCPCB extended"),

    # Mains: fuse and the single 8-pin plug
    Part("F1", "T 3.15 A 5x20", "Device:Fuse", "dryer:Fuseholder_5x20mm_Covered_P12.50mm_Slot",
         {"1": "L_IN", "2": "L_FUSED"}, hand_fit=True,
         description="covered 5 x 20 mm holder, hand-fitted from the holders on hand (Amazon B0FCS5MK1Y, 10 A 250 V), "
                     "drawn to the hardware reviewer's measurement of 2026-10-15: pins about 12.5 mm apart, body "
                     "25.7 x 10 mm; slotted holes take 11.5 to 13.5 mm. That pitch conflicts with the BLX-A drawing the "
                     "body matches (22.3 +-1.0 mm), so confirm the pin positions before ordering; the 22.5 mm slotted "
                     "footprint stays in hardware/lib/dryer.pretty (hardware/README.md). The T 3.15 A fuse itself is "
                     "fitted by hand"),
    Part("J_MAINS", "120 VAC", "Connector_Generic:Conn_01x08",
         "dryer:PhoenixContact_MSTBVA_2,5_8-G-5,08_1x08_P5.08mm_Vertical_Drill1.7mm",
         {"1": "L_IN", "2": "N", "3": "L_SW_A", "4": "N", "5": "L_SW_B", "6": "N", "7": "L_FUSED", "8": "N"}, "C395787",
         description="L in, N in, heater A L-sw/N, heater B L-sw/N, PSU L (fused)/N; DORABO DB2EV-5.08-8P-GN, "
                     "vertical (wires perpendicular to the board: a wall borders the mains space, reviewer "
                     "2026-10-15), 630 V 15 A per LCSC. Its drawing is not retrieved: the vertical entry is "
                     "inferred from the series letter and LCSC's open-side listing, the 1.7 mm holes and the body "
                     "from the DB2EVC/DB2ERC drawings and the MSTBVA footprint; confirm before ordering. Plug "
                     "DB2EK-5.08-8P-GN-S C395791, loose; JLCPCB extended"),

    # Mounting holes, power flags
    parts.hole("H1"), parts.hole("H2"), parts.hole("H3"), parts.hole("H4"),
    parts.flag("#FLG1", "+5V"), parts.flag("#FLG2", "GND"),
]

def by_ref(ref):
    return parts.by_ref(PARTS, ref)

def nets():
    return parts.nets(PARTS)

def board_parts():
    return parts.board_parts(PARTS)

def check():
    """Invariants the table must satisfy. Returns a list of violations."""
    errs = parts.check_nets(PARTS)
    n = nets()
    for k in ("K1", "K2"):
        if by_ref(k).pins["4"] != NC:
            errs.append("%s NC contact must stay unconnected" % k)
    for net in MAINS_NETS:
        for ref, _ in n.get(net, []):
            if ref not in MAINS_PARTS:
                errs.append("mains net %s reaches %s" % (net, ref))
    # The reverse: every connected pin on the mains parts' mains side is on a mains net, so
    # it gets the MAINS netclass and the 6 mm rules. (K1/K2 pads 2 and 5 are the SELV coil;
    # pad 4, NC, is checked above.)
    mains_pins = [("J_MAINS", pin) for pin in by_ref("J_MAINS").pins] + [("F1", pin) for pin in by_ref("F1").pins]
    mains_pins += [(k, pad) for k in ("K1", "K2") for pad in ("1", "3")]
    for ref, pin in mains_pins:
        net = by_ref(ref).pins.get(pin, NC)
        if net != NC and net not in MAINS_NETS:
            errs.append("%s pin %s is on %s, which is not a mains net" % (ref, pin, net))
    if by_ref("J_CTRL").pins != parts.LINK_PINS:
        errs.append("J_CTRL pins %s, the link is %s" % (by_ref("J_CTRL").pins, parts.LINK_PINS))
    return errs

# ---------------------------------------------------------------------------------------
# Placement. 45 x 70 mm, the mains space in the enclosure. SELV strip x 0-7 (link header and
# both driver stages, two narrow columns, GND pour), slot x 7-9 with four gaps for the coil
# tracks, mains zone x 9-45: relays with COM at x 12 and contacts at x 26.2, F1 across the top
# of the zone, J_MAINS a vertical header (wires from above; a wall borders the space) with its
# pads at x 39.5, pin 1 at the top, and N linked at x 43.15 on the edge side.
#
# What fixes each position (courtyards measured from the KiCad 10.0.6 footprints):
# - J_MAINS at (39.5, 17.94) rotated 270 (pins run down the board from pin 1): the N links run
#   1.1 mm right of the pads (x 43.15, 1.5 wide) and keep 1.05 mm from the board edge (copper
#   edge to the Edge.Cuts stroke), so the pads cannot go further right. The vertical body is
#   deeper on one side of its pin row (5.34 mm) than the other (4.34); rotation 270 puts the
#   deep side toward the edge, courtyard x 35.16 to 44.84, y 13.86 to 57.58, between F1 and
#   H4's courtyard (from y 61.4). Pin 1 at the top keeps L_SW_A (pin 3) and L_SW_B (pin 5) from
#   crossing: K1's contact feeds the upper pin and K2's the lower.
# - F1 at (15.6, 14): the 25.7 mm body (reviewer's measurement) has 26.16 mm between the slot
#   (x 9) and J_MAINS's courtyard (x 35.16); it sits at x 9.0 to 34.7, courtyard 8.71 to 34.99,
#   0.16 mm short of the plug's. Pad 1 (L_IN) is at x 15.6, pad 2 (L_FUSED) at 28.1 on the
#   12.5 mm pitch; the courtyard top (y 8.75) clears H1's and H2's (to y 8.6).
# - K1 at y 29: K1's top coil pad (SELV, (13.95, 23.05)) is 6.285 mm below F1's pad 1 (x
#   overlaps, so the gap is vertical); F1 is not in a relay area. K2 at y 51.5.
# - L_IN cannot pass below F1 (6 mm from the coil pad) or between the pads (pad 2 is in the
#   way), so it runs over the top of the fuse body at y 9.6, under the holder, 2.05 mm above
#   pad 2 and about 7.5 mm from H2, then drops to pin 1.
# - The SELV strip: H1 and H3's courtyards leave y 8.6 to 61.4. Nothing SELV comes within
#   6 mm of F1's pad 1 (x 13.6 up, y 12.4 to 15.6): the column beside it (x 2) carries driver
#   A's flyback diode and transistor, the second column (x 5.4) starts at y 20.8. J_CTRL and
#   the second column also keep the plain 6 mm from the relay COM pads.

BOARD_W, BOARD_H = 45.0, 70.0
HOLES = {"H1": (4, 4), "H2": (41, 4), "H3": (4, 66), "H4": (41, 66)}

SLOT_X = (7.0, 9.0)
# coil pads at y 23.05 / 35.05 (K1) and 45.55 / 57.55 (K2): gaps 21-25, 33-37, 43.5-47.5, 55.5-59.5
SLOT_SEGMENTS = [(3, 21), (25, 33), (37, 43.5), (47.5, 55.5), (59.5, 67)]
MAINS_ZONE = (9.0, 0.0, 45.0, 70.0)
# COM +-10 mm in y, from the strip to just past the spine at x 21 (rev A: COM +-10 both ways)
RELAY_AREAS = [(2.0, 19.0, 22.0, 39.0), (2.0, 41.5, 22.0, 61.5)]
# The pour starts at y 21: the outline's corner (6.5, 21) is 8.9 mm from the corner of F1
# pad 1's bounding box (13.6, 15.6); the saved fill is 16.69 mm from the pad on F.Cu. It
# is kept conservative by its outline anyway: board.refill_with_rules refills after every save,
# and test_saved_pour_fill_keeps_the_mains_rules checks the saved fill.
GND_POUR = (2.0, 21.0, 6.5, 68.0)

PLACE = {
    "H1": (4, 4, 0), "H2": (41, 4, 0), "H3": (4, 66, 0), "H4": (41, 66, 0),
    # link header on the left edge, pin 1 at the top (rotation 270 runs the XH's pins down the
    # board), between the two driver stages; x 3.95 keeps its courtyard (x 0.01 to 6.84) on the
    # board. Pins y 33 to 40.5: the plain 6 mm from both COM pads (y 29 and 51.5), not the
    # relay-area 3.5, which is for the relay's own coil-to-COM geometry.
    "J_CTRL": (3.95, 33, 270),
    # relay driver A above it: diode, transistor, pulldown, LED down the edge column, the LED
    # resistor in the second column
    "D1": (2, 12.4, 90), "Q1": (2, 18.2, 90), "R2": (2, 22.2, 90), "D3": (2, 25.9, 90), "R3": (5.4, 22.5, 90),
    # relay driver B below it, down the edge column; the second column (x 5.4) stays 6 mm from
    # K2's COM (y 51.5), so only the LED resistor sits there, at the bottom
    "R5": (2, 45.3, 90), "Q2": (2, 49.1, 90), "D2": (2, 55, 90), "D4": (2, 59.6, 0), "R6": (5.4, 59.6, 90),
    # mains zone
    "K1": (12, 29, 0), "K2": (12, 51.5, 0),
    "F1": (15.6, 14, 0),
    "J_MAINS": (39.5, 17.94, 270),
}

# Mains copper, laid by board.add_mains_copper (locked; Freerouting never routes mains).
# (net, layer, polyline). Width is the MAINS netclass's 1.5 mm. Hand-placed because the
# custom rules in RULES are not visible to the router. Distances held (measured on the
# generated board, copper edge to copper edge; test_margins.py prints the guarded ones):
# - 3.5 mm from the relay coil pads and the SELV coil corridors at y 23.05/35.05/45.55/57.55
#   inside the relay areas (the spine at x 21 is 5.05 mm from the coil pads, COM 3.5). The rule
#   tests the mains item and COM is always inside an area, so it also holds the SELV strip's
#   copper to 3.5 mm from the COM pads (minimum and strip figures: test_margins.py);
# - 6 mm from SELV copper outside the relay areas. F1's pad 1 (L_IN, x 13.6 to 17.6) is the
#   mains copper nearest the strip outside an area: 6.285 mm above K1's top coil pad
#   (test_margins.py prints it; the COIL_A track from that pad is 6.99 mm away). The spine's
#   short pieces between the areas are
#   6.5 mm from the coil pads;
# - 6 mm hole clearance from the M4 holes (H2 at (41, 4): the L_IN drop from (32, 9.6) to
#   pin 1 is the closest mains copper, about 7.5 mm from the hole's edge);
# - 1 mm between mains nets (the NC pads are mains). L to N 1.10 mm (the rule is 1.0; the
#   single board had 1.55; regaining it would put the N links at the edge's 1 mm limit): the N
#   links beside the plug pins. The L-side nets keep 1.6 mm from each other (RULES): the L_IN
#   run at y 9.6 passes F1's pad 2 at 2.05, the L_FUSED branch to pin 7 passes K2's NC pad at
#   1.85, L_SW_B's lane passes K2's NC pad at 2.05;
# - 1 mm to the board edge: the N links at x 43.15 are 1.05 mm from it (copper edge);
# - the relay_pads relaxation (3.5 mm) applies to a whole segment if any of it touches a relay
#   area (insideArea tests the item, not the overlapping part), so every segment that would cross
#   an area edge is split there: the x 21 spine at y 18.2 and 39.8/40.7 (the pieces outside
#   end 0.75 mm, a cap, short of the areas, y 19-39 and 41.5-61.5), the L_FUSED branch to pin 7
#   at x 22.75, so no mains segment outside an area is relaxed.
# The spine at x 21 carries L_FUSED on F.Cu between the coil pads (x <= 13.95 + 1.25) and the
# NC/NO pads, from F1's pad 2 down to both COM pads, with a branch at y 49.6 to J_MAINS pin 7
# (PSU L). L_IN leaves F1's pad 1 upward, runs along y 9.6 over the top of the fuse body and
# drops to pin 1 at the top of the plug. N links the four N pins on the edge side of J_MAINS.
# The switched lines reach pins 3 and 5 from the left: L_SW_A straight from K1's NO pad on
# F.Cu, L_SW_B from K2's NO pad up the x 30.5 lane on B.Cu (it crosses under the pin-7 branch).
MAINS_TRACKS = [
    ("L_IN", "F.Cu", [(15.6, 14), (15.6, 9.6), (32, 9.6), (39.5, 17.94)]),
    ("L_FUSED", "F.Cu", [(28.1, 14), (24, 14), (21, 17), (21, 18.2), (21, 39.8), (21, 40.7), (21, 51.5), (12, 51.5)]),
    ("L_FUSED", "F.Cu", [(12, 29), (21, 29)]),
    ("L_FUSED", "F.Cu", [(21, 49.6), (22.75, 49.6), (38, 49.6), (39.5, 48.42)]),
    ("L_SW_A", "F.Cu", [(26.15, 35.05), (39.5, 28.1)]),
    ("L_SW_B", "B.Cu", [(26.15, 57.55), (30.5, 53.2), (30.5, 38.26), (39.5, 38.26)]),
    ("N", "F.Cu", [(39.5, 23.02), (43.15, 23.02), (43.15, 53.5), (39.5, 53.5)]),
    ("N", "F.Cu", [(39.5, 33.18), (43.15, 33.18)]),
    ("N", "F.Cu", [(39.5, 43.34), (43.15, 43.34)]),
]

# References that would print over a label (J_MAINS's and J_CTRL's over their pin labels) or
# off the board (the holes', and the edge column's D1, Q1, D2, Q2, whose references fall left of
# the edge); board.py hides them on the silkscreen, they stay on F.Fab.
HIDDEN_REFS = ("J_MAINS", "J_CTRL", "H1", "H2", "H3", "H4", "D1", "Q1", "D2", "Q2")

# (text, x, y, size, rotation, layer, justify)
SILK = [
    # The title in two lines: at the 0.8 mm minimum text height one line is 45 mm long.
    ("dryer mains board  rev ${REVISION}  AGPL-3.0", 22.5, 1.1, 0.8, 0, "F.SilkS", "center"),
    ("github.com/jrytio/desiccant-dryer", 22.5, 3.0, 0.8, 0, "F.SilkS", "center"),
    ("MAINS 120 VAC", 25, 66, 2.0, 0, "F.SilkS", "center"),
    ("keep 6 mm from SELV", 25, 68.5, 1.0, 0, "F.SilkS", "center"),
    ("HTR A", 3.75, 25.9, 0.8, 90, "F.SilkS", "center"), ("HTR B", 5.4, 54.5, 0.8, 90, "F.SilkS", "center"),
    # On the back, mirrored by board.py: on the front J_CTRL's body covers the whole strip
    # width beside its pads.
    ("CONTROLLER", 6.0, 36.75, 0.8, 90, "B.SilkS", "center"),
]
# Link pins, pin 1 first, as one column reading down the header beside its pads (pin 1 at
# y 33, pitch 2.5 downward), on the back: on the front the header body covers the strip
# (right of it is the slot), and "HTR B" at the 0.8 mm minimum is wider than the room beside
# the pads, so the names cannot sit one per pin.
SILK += [("5V  GND  HTR A  HTR B", 1.05, 36.75, 0.8, 90, "B.SilkS", "center")]
# Mains header pins, left of the pads, one per position, pin 1 at the top (y 17.94, pitch 5.08
# downward). Vertical, centred at x 33.5 in the gap between the relay outline (x 30.59) and
# J_MAINS's body (x 35.59): horizontal labels would run under the relay bodies. Pin 1's label
# would fall under F1's body (to x 34.7, y 19), so "L IN" sits above the plug instead, between
# F1's courtyard and H2's.
SILK += [(name, 33.5, 17.94 + i * 5.08, 0.8, 90, "F.SilkS", "center")
         for i, name in enumerate(["", "N IN", "HTR A", "N", "HTR B", "N", "PSU L", "PSU N"]) if name]
SILK += [("L IN", 40.0, 12.0, 0.8, 0, "F.SilkS", "center")]
# A line along the slot, mains side.
SILK_LINES = [(10, 3, 10, 67)]

def rule_areas():
    """The rule areas board.build lays: (name, (x1, y1, x2, y2), (no fills, no tracks, no vias, no pads))."""
    out = [("mains_nopour", MAINS_ZONE, (True, False, False, False))]
    out += [("relay_pads", r, (False, False, False, False)) for r in RELAY_AREAS]
    return out

def edge_outlines():
    """The Edge.Cuts shapes build draws, each as its corner points: the board rectangle, then
    one rectangle per slot segment."""
    def corners(x1, y1, x2, y2):
        return [(x1, y1), (x2, y1), (x2, y2), (x1, y2)]
    x1, x2 = SLOT_X
    return [corners(0, 0, BOARD_W, BOARD_H)] + [corners(x1, y1, x2, y2) for y1, y2 in SLOT_SEGMENTS]

# The relay NC pad (4) carries no net, so no copper ever reaches it, but COM connects to it
# whenever the coil is off: it is live mains that the netclass rules cannot see. The last
# rule names it directly; it comes after the relay_pads relaxation so that cannot override it.
# memberOfFootprint('K*') does not match in KiCad 10.0.6, so both relays are named.
# The NC pad is netless, so the two "mains to selv" rules would also see it as SELV on the B
# side; it is at mains potential, so they exclude it and mains copper passes it at the MAINS
# in-class clearance. An M4 head or washer bears on the area round each mounting hole, so
# mains copper keeps 6 mm from every non-plated hole (spec, "Stackup and fab").
# The MAINS netclass clearance (1 mm) covers L to N; the L-side nets (L_IN, L_FUSED, L_SW_A,
# L_SW_B) keep 1.6 mm from each other: a bridge between two of them bypasses the fuse or turns
# a heater on with its relay open, so they get more margin than the netclass gives.
# The net name is A.NetName: A.Net != 'N' parses in 10.0.6 but does not exclude N.
RULES = """(version 1)
(rule "mains track width"
  (condition "A.NetClass == 'MAINS'")
  (constraint track_width (min 1.5mm)))
(rule "mains to board edge"
  (condition "A.NetClass == 'MAINS'")
  (constraint edge_clearance (min 1mm)))
(rule "mains to selv"
  (condition "A.NetClass == 'MAINS' && B.NetClass != 'MAINS' && !(B.Pad_Number == '4' && (B.memberOfFootprint('K1') || B.memberOfFootprint('K2')))")
  (constraint clearance (min 6mm)))
(rule "mains L to L"
  (condition "A.NetClass == 'MAINS' && B.NetClass == 'MAINS' && A.NetName != 'N' && B.NetName != 'N'")
  (constraint clearance (min 1.6mm)))
(rule "mains to selv at relay pads"
  (condition "A.NetClass == 'MAINS' && B.NetClass != 'MAINS' && A.insideArea('relay_pads') && !(B.Pad_Number == '4' && (B.memberOfFootprint('K1') || B.memberOfFootprint('K2')))")
  (constraint clearance (min 3.5mm)))
(rule "relay NC contact is live"
  (condition "(A.memberOfFootprint('K1') || A.memberOfFootprint('K2')) && A.Pad_Number == '4' && B.NetClass != 'MAINS'")
  (constraint clearance (min 6mm)))
(rule "mains to mounting holes"
  (condition "A.NetClass == 'MAINS' && B.Pad_Type == 'NPTH, mechanical'")
  (constraint hole_clearance (min 6mm)))
"""
