jrytio/desiccant-dryer/(commit log)

2026-09-14 Initial ESPHome controller for Azco VMD-08 desiccant dryer
    Baseline as generated from the original chat: ESP32-S2 Thing Plus config,
    humidity/temperature-driven pack swap state machine, hardware and control
    logic docs.
2026-09-14 Add implementation plan for the virtual build
    Also tightens the not-heating check in the spec: it only applies while
    the standby pack is still below regen temperature, so a reboot into an
    already-hot pack cannot trip it.
2026-09-14 Replace millis timestamps with persisted scaled elapsed counters
    Outputs are now re-asserted from state every tick by apply_outputs, which
    fixes the active valve staying closed after a reboot and a mid-HEATING
    heater never re-lighting. Service, heater and hold times persist across
    reboot. A time_scale global (1.0 in production) lets the virtual build
    accelerate the whole cycle. Fault state is a restored code with the text
    derived in one place. Adds Standby Heater Time, Regen Hold Time, Standby
    State and a Restart button as diagnostics.
    [base.yaml]
2026-09-14 Address Task 2 review: log faults once, quiet apply_outputs, shared resets
    Faults latch only when none is held so the ERROR line fires once. Switches
    are written only when their state differs. Counter resets live in two
    shared scripts and Clear Fault restarts an interrupted regen the same way
    boot does. The waiting flag is computed before the fault gate. Heater and
    hold time sensors hold their value through COOLING and READY. Restored
    ints are clamped at boot.
    [base.yaml]
2026-09-14 Add virtual build with on-device plant model
    desiccant-dryer-virtual.yaml runs the production logic, outputs and
    display on a bare S2 Thing Plus. hw-virtual.yaml integrates a first-order
    thermal model per pack from the real heater switch states and a
    breakthrough RH curve from service time, in time scaled by Sim Speed.
    Knobs cover ambient, heater max, time constant, breakthrough, rise rate,
    a heater fault and manual pack temps.
2026-09-14 Address Task 3 review: seed plant clock, publish from the tick, guard knobs
    The first plant tick after boot now only seeds its clock, so boot time is
    not integrated into the restored temperatures. Sensors are published from
    the plant tick instead of polled, so the controller's view is at most one
    plant tick old at any Sim Speed. Every knob falls back to its default if
    NaN. The dead plant_rh global is gone. Comments explain the manual-temps
    fault trap, the case model's fault gating, and the dt clamp.
2026-09-14 Route the logger to UART0 for the CP2102 on the S2 Thing Plus
    ESPHome's ESP32-S2 default is USB_CDC, which on this board is the unused
    native-USB pins. Found on first flash: the board booted but esphome logs
    over the cable showed nothing.
2026-09-14 Correct the not-heating margin figure in the bench doc
    At the 30 min time constant the heater max must sit about 33 C above
    ambient at 1x and about 40 C at 60x, not 53 C. Also drops a doubled
    blank line in CLAUDE.md.
2026-09-14 Record the 8-bit palette and UART0 logger as board decisions
2026-09-14 CI: compile with the ESPHome Docker image instead of build-action
    esphome/build-action v8 refuses ESPHome older than 2026.7.0 and we pin
    2026.1.4 to match the bench install. Running the official image directly
    keeps the version pin in one place.
2026-09-14 Address Copilot review: fan off on disable, exact sensor freshness, safer normaliser
    Dryer Enabled off now parks the fan thermostat in OFF and turns the fan
    off, and re-enabling sets COOL, so the disable invariant holds for all
    five outputs. The virtual plant publishes values rounded to 0.1 instead
    of using delta filters, so the controller's reading is exactly one plant
    tick fresh while HA history stays quiet at 1x. The config normaliser now
    sorts only top-level component lists; nested action and filter order is
    preserved and a swapped then: order is detected. Spec and plan updated
    to describe the Docker-image CI.
    [base.yaml, hw-virtual.yaml]
2026-09-14 Run on_boot before the first control tick; final-review doc fixes
    ESPHome loops already-set-up components while setup waits for WiFi, and
    the interval trigger sets up at priority 600, so on_boot at -100 ran
    after the first tick: outputs chattered on every boot and a reboot into
    HEATING after a long outage could trip the not-heating fault before the
    counters were reset. on_boot now runs at 700 and sets boot_done, which
    the tick checks first.
    Docs: RH freshness through Control Humidity is 5 s, counter reset table
    completed, flash-flush wording, display.yaml as a pin source, scenario 13
    timing at 1x, and three follow-ups recorded as open items.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
    [base.yaml]
2026-09-14 Reboot into HEATING: capture the start temperature, then time from the next tick
    The bench (scenario 11 at 60x) showed the first post-boot HEATING tick
    capturing heat_start_temp and adding a full scaled dt in the same tick,
    so the not-heating check ran with no heating time against a pack that
    had cooled while outputs were off. The capture tick now only records the
    temperature and re-lights the heater.
    Also logs the restored state at boot, the reason for a READY swap, and
    Force Swap presses at WARN, so bench anomalies are attributable.
    [base.yaml]
2026-09-14 Add hardware bring-up checklist for the second board
2026-09-14 Tolerate missed standby probe readings; log the IP at boot; sim probe faults
    A DS18B20 CRC miss publishes NaN and used to drop the heater for a tick.
    The tick now counts consecutive missing standby readings: the heater
    rides out two, goes off on the third, and an interrupted regen restarts
    cleanly when the probe returns (warning logged). The virtual build gains
    Sim Probe A/B Fault switches and two checklist scenarios to exercise
    both paths.
    The wifi on_connect hook logs the IP at INFO two seconds after joining,
    so a board on another VLAN is findable from the serial log. The bring-up
    doc now says to disable the dryer before manual output tests.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
    [base.yaml, hw-virtual.yaml]
2026-09-14 Probe tolerance as 25 s, blocked until the first valid reading
    Copilot review: the real DS18B20s publish every 10 s, so three control
    ticks tolerated one missed reading, not two. The tolerance is now a
    substitution, probe_timeout_ticks = 5 (25 s), which rides out two missed
    readings and acts on the third. The counter starts at the threshold so a
    boot into HEATING keeps the heater off until a valid reading arrives.
    Bring-up doc: the Boot line shows persisted values, zero only on a fresh
    device. Scenarios 15 and 16 retimed to 15 s and 40 s and re-verified on
    the test board.
    [base.yaml]
2026-09-15 Add design spec for the host display preview build
    A third ESPHome build compiles natively for the Mac and renders the
    display into an SDL window so the screen can be iterated without
    flashing a board.
2026-09-15 Move board, WiFi, OTA and web server into a platform package
    base.yaml is now the controller only. platform-esp32.yaml holds the
    blocks that only make sense on the S2, so a host build can swap in a
    different platform package. Normalised config dumps of both device
    builds are identical to before.
    [base.yaml]
2026-09-15 Split the display into drawing and panel-driver packages
    display-draw.yaml holds fonts, colours and the drawing lambda as the
    display_lambda substitution; display-st7789.yaml is the SPI panel and
    backlight. Both device builds are unchanged (normalised config diff is
    empty). A second driver package can now render the same drawing.
    The normaliser now drops the echoed substitutions block: esphome config
    prints the substitutions it expanded, so the new display_lambda key would
    otherwise show as a difference even though every expanded value is
    identical.
2026-09-15 Add the host preview build: native compile with an SDL display window
    desiccant-dryer-host.yaml combines the controller, the virtual plant
    model and the shared drawing lambda with ESPHome's host platform and
    an SDL window, so the screen can be worked on without flashing a board.
    Home Assistant connects over the API; there is no WiFi, OTA or web
    server on host.
2026-09-15 CI: compile the host preview build
    Installs SDL2 and g++ inside the ESPHome image and compiles
    desiccant-dryer-host.yaml natively alongside the two device builds.
2026-09-15 Docs: the host build is one more ESPHome device, not a fourth
    The host preview guide contradicted the three-build count in CLAUDE.md
    and the README; the plan carried the same sentence.
2026-09-15 Add design spec for mirroring the panel into Home Assistant
    The device serves its 8-bit frame buffer as /screen.bmp on the existing
    web server, streamed with no allocation; Home Assistant's Generic Camera
    shows it as a camera entity.
2026-09-15 Serve the panel's frame buffer as /screen.bmp for Home Assistant
    A local external component, screen_mirror, registers one GET path on the
    web server the device builds already run and streams the ili9xxx 8-bit
    buffer as a bottom-up indexed BMP with chunked sends, so the 58 KB image
    never sits in RAM. Both device builds include it; the host build does
    not.
2026-09-15 Document the screen endpoint and the Home Assistant camera setup
    Also ignores __pycache__ anywhere, since the new local component is Python.
2026-09-15 screen_mirror: only_on_esp32, simpler path match, no spent warning at boot
    cv.only_with_esp_idf is deprecated since 2026.1 and warned on every build;
    the ESP32 httpd backend is what the handler needs and ESPHome loads it for
    every ESP32 build. AsyncWebServerRequest::url() already strips the query,
    so canHandle compares directly. A request before the first draw no longer
    spends the one-shot warning. Docs: no frame copy rather than no RAM,
    transform in the limits, card refresh note; spec and plan wording fixed
    for the full-bar case and the pre-flash 000 reply.
2026-09-15 screen_mirror: serve an indexed PNG, which Home Assistant accepts, not BMP
    Home Assistant's Generic Camera opens the still with PIL and accepts only
    PNG, JPEG, GIF, SVG and WebP, so the BMP failed setup with "URL did not
    return a valid still image". The endpoint is now /screen.png: an 8-bit
    indexed PNG whose zlib stream is stored deflate blocks of whole
    scanlines, so it still streams straight from the driver buffer with no
    compressor; CRC-32 and Adler-32 are computed on the fly, the palette and
    CRC table are compile-time constants in flash, and the only RAM is one
    scanline allocated at setup. 58,688 bytes for 240x240.
2026-09-15 Add display UI redesign spec, plan and state mockup sheet
    Process-schematic screen for the ST7789: standing cylinders with
    temperature fills, lit air path, valve and heater sprites, three-zone RH
    gauge, status strip. The plan's execution notes record the deviations and
    the file mapping after the rebase onto the platform/display split.
2026-09-15 Count time in the current standby phase
    Persisted standby_elapsed_s resets on any standby_state change: right
    after the state machine (normal end and the fault return) for in-tick
    transitions, and at the top of the tick for changes made between ticks
    (do_swap, disable), which credit that interval's dt. Exposed as the
    Standby Phase Time diagnostic sensor for the display.
    [base.yaml]
2026-09-15 Draw the process-schematic screen from a shared header and SVG sprites
    display-draw.yaml now holds the fonts, the sprites rasterised at compile
    time, and a ui_draw script that is the only place ids are read; it fills
    a UiState and calls draw_ui() in display_ui.h, which has no id() calls.
    The display_lambda substitution just runs the script, so the ST7789 and
    the host build's SDL window (both id: panel) draw the same frame.
    Symbols follow the real output switches; fills are banded by temperature.
2026-09-15 Add a screen-scenarios host build with palette-accurate captures
    Stub entities under the controller's ids and a twelve-row scenario table
    picked by SCENARIO=n. With SHOT=<file> the frame is drawn in-process
    through the RGB 3-3-2 palette into a PPM; scripts/scenario-shots.sh
    renders all twelve to docs/display/. CI compiles it next to the host build.
2026-09-15 Spec: solid state colours for the display cylinders
    Replaces the temperature fill, threshold dashes, cap sprites and fault
    ring with one body colour per pack state (WET pink, READY blue, matching
    indicator desiccant). The mockup sheet shows all twelve scenarios.
2026-09-15 Plan: solid state colours for the display cylinders
2026-09-15 Colour the display cylinders by pack state
    Each cylinder body is one solid colour for its state: IN USE green,
    WET pink, HEATING orange, COOLING cyan, READY blue, FAULT red; unfilled
    when off or starting. Removes the temperature fill, threshold dashes,
    cap sprites and fault ring, and the three thresholds only they read.
    Scenario captures regenerated.
2026-09-15 Docs: cylinders are coloured by state
    Marks the superseded parts of the display UI spec, updates the host
    preview screen-state table, and points CLAUDE.md at the new spec.
2026-09-15 Docs: final review nits for state colours
    FAULT red's panel colour, the unmeasured frame-time note, the
    display-draw header citing both specs, and a CLAUDE.md line join.
2026-09-15 Mockup: draw three-digit temperatures at the renderer's 24 px
    The reference sheet shrank 124° to 21 px while display_ui.h prints every
    temperature in f_temp at 24 px. Addresses the Copilot review on PR #7.
2026-09-15 Cache PlatformIO toolchains and build directories in CI
    A cold ESP build spent ~70 s installing toolchains and ~4 min compiling,
    ~700 of its ~1,225 objects ESP-IDF sources that never change. Restore
    both between runs: toolchains per ESPHome version and platform package,
    esphome/.esphome per variant, falling back to the newest cache for that
    variant so a changed commit only recompiles what changed.
    The four builds now share one matrix job with the same check names.
    Only tools/ and penv/ under /root/.platformio are mounted, because the
    image keeps its PlatformIO settings and libraries in that directory.
2026-09-15 Add the bench Home Assistant dashboard for the virtual board
    docs/ha/dryer-bench-dashboard.yaml is the versioned copy of the "Dryer
    Bench" dashboard published on the dev Home Assistant: the live screen,
    status and controls, and humidity/temperature trends with the threshold
    numbers drawn as lines, then a tabbed card (HACS Tabdeck Card) with the
    simulator knobs, the eight thresholds, a step-by-step test table and
    diagnostics. Help text is written for a non-technical operator and was
    checked against base.yaml and hw-virtual.yaml. The header lists what the
    dashboard needs on the HA side.
    docs/screen-in-ha.md: recommend camera_view: live with the Generic Camera
    at 0.5 Hz. HA's default of 2 Hz o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
2026-09-15 Show airflow in and out of the pack tops instead of inlet pipes
    The shared WET AIR inlet at the top didn't match the plant: ambient air
    enters the top of the pack in use and warm air leaves the top of the
    pack being heated. Green chevrons now point into a pack whose valve is
    open and amber heat waves rise from a pack whose heater is on. The
    heater zigzags beside the cylinders are removed as redundant with the
    orange HEATING colour. Scenario captures and mockup regenerated.
    [display_ui.h]
2026-09-15 Docs: show the screen in HA through a template image entity
    A Picture Entity card with camera_view: live holds an endless MJPEG
    response open, and through the Cloudflare tunnel those requests are
    cancelled and the card stays blank. A template image entity, refreshed
    every 2 s by an automation, lets Home Assistant fetch and cache the PNG
    and serve browsers plain stills from /api/image_proxy, which work
    remotely. The Generic Camera stays documented as the LAN-only option.
2026-09-15 Match the dashboard's Screen card to the live image entity
    The dev dashboard's Screen card now shows the template image
    image.dryer_screen, refreshed every 2 s by automation.dryer_screen_refresh
    (set up in the Cloudflare tunnel work, because a live camera stream does not
    pass through the tunnel). The card also sets aspect_ratio "1", which makes
    it paint the last fully loaded frame as its background during a refresh.
    The header's prerequisites and the CLAUDE.md pointer now name the image and
    automation instead of the camera.
    docs/screen-in-ha.md goes back to main: that branch rewrites the camera
    section for the image entity, and the pointer to this dashboard is added by
    whichever PR merges s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
2026-09-15 Send a pack that failed to heat back to WET, not COOLING
    Fault 3 ("Standby heater not heating") retired the standby pack to
    COOLING. A pack that never heated is already below cooldown_temp, so
    after Clear Fault it became READY on the next tick and could be swapped
    into service wet. It now goes back to WET and must re-arm and complete a
    full regen before it can be READY. Fault 2 (standby overtemp) still
    retires to COOLING, since that pack did get hot.
    Docs: fault table and the after-clearing paragraph now match the code,
    the real-unit test sequence no longer expects "A wet" to persist at 12 %
    RH (it arms on the next tick), and virtual-testing scenario 7 expects
    the pack to stay unready while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
    [base.yaml]
2026-09-15 Mark the virtual-build spec and plan as amended for fault 3
    Both still show fault 3 sending the standby pack to COOLING. Add a note at
    the top of each, in the same style as the display spec's amendment note,
    pointing at the current docs so nobody re-applies the old step.
2026-09-15 Rename Simulate Humidity to Override Humidity
    The switch never simulated anything: it replaces the measured outlet RH
    with a fixed value. On the virtual build, where the plant model really
    does simulate a rising RH, "Simulate Humidity" read as the thing already
    running. Rename the switch to Override Humidity (rh_override_on), the
    number to Override RH (rh_override), and the display badge from SIM to
    OVR. Behaviour is unchanged: normalized configs differ only in names and
    ids, and only scenario 12's screenshot changes.
    Home Assistant entity ids change with the names.
    [base.yaml, display_ui.h, hw-virtual.yaml]
2026-09-15 Point the bench dashboard at Override Humidity
    PR #13 renames the base Simulate Humidity switch and Simulated RH number
    to Override Humidity and Override RH, and the display badge from SIM to
    OVR. Follow the new entity ids and wording: switch/tile "Override
    humidity", slider "Override value", badge "Humidity overridden".
2026-09-15 Describe the new "not heating" fault recovery in the dashboard help
    PR #9 sends a spare whose heater failed back to WET instead of COOLING, so
    after Clear Fault it must recharge before it can be READY. Update the Clear
    Fault confirmation, the Fake heater failure note and the Heater failure test
    row to match.
2026-09-15 Stop /screen.png from serving half-drawn frames
    draw_ui() clears the frame buffer and repaints it over a few hundred
    milliseconds, and screen_mirror streamed rows from that live buffer on the
    web server task over about 0.6 s. Most fetches overlapped a redraw: 20
    fetches from the bench board had 6,507 to 14,040 lit pixels, several
    showing only the cylinder fills, so the Home Assistant image flickered
    every refresh.
    screen_mirror now wraps the display's writer so fetches and redraws take
    turns without a second frame buffer. A fetch waits for a redraw in
    progress to finish; a redraw that falls due during a fetch is skipped and
    run from loop() as soon as no fetch is streaming.
    Also documents a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
2026-09-15 Show the dryer screen with a card that swaps only complete frames
    Through the Cloudflare tunnel the built-in Picture Entity card still
    blinked on every 2 s refresh: it points its <img> at each new URL straight
    away, so the frame is visibly replaced while it downloads. The Dryer Screen
    card (docs/ha/dryer-screen-card.js, published as an inline dashboard
    resource) loads and decodes each frame off-screen and swaps it in only when
    complete, skipping to the newest frame if it falls behind and keeping the
    current one if a load fails.
    The bench dashboard's Screen card, its prerequisites header, the screen
    docs and the CLAUDE.md pointer are updated to match what is live.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
2026-09-15 Add the breadboard wiring diagram and a schematic-checked pinout
    The wiring was described only in prose in docs/hardware.md. This adds
    docs/breadboard.svg, embedded in that section, and
    docs/pinout-verification.md, which lists both headers pin by pin as read
    from SparkFun's Eagle schematic for the ESP32-S2 Thing Plus.
    The schematic corrects one note: GPIO18's 10 kΩ pullup sits behind a
    normally-open solder jumper, so there is no pullup by default. It also
    shows the 12-pin header carries GPIO8 and GPIO4 where a standard Feather
    has "9" and "5". hardware.md and CLAUDE.md now say both. No pin
    assignments change.
2026-09-15 Switch the screen to the Semantic palette
    The customer chose GitHub's status hues from three muted options: green
    success = in use, yellow attention = wet, orange severe = heating, blue
    info = cooling, purple done = ready, red danger = fault. Sprites with
    baked-in colours are re-tinted; the gauge's attention zones and the OVR
    badge follow the wet yellow. Captures regenerated.
2026-09-15 Warn that the USB pin and USB-C share one 5 V net
    The breadboard feeds the buck's 5 V into the 12-pin header's USB pin. In
    SparkFun's schematic that pin (J2 pin 3) and the USB-C connector's VBUS
    are the same net, V_USB; the Schottky D2 sits after it, on the way to the
    regulator. Plugging in a USB-C cable to flash with that wire in place
    ties the buck to the computer's USB port, and each back-feeds the other.
    The diagram, hardware.md, pinout-verification.md and the bring-up
    checklist's flash step now say to pull the USB-pin wire before plugging
    in USB-C, or to flash over the air. Raised in Copilot's review.
2026-09-15 Propose a two-board protoboard layout for the controller
    Logic and 24 V loads on a 70x90 mm perfboard, mains relays on a 50x70 mm
    board, joined by a 4-wire logic-level harness.
2026-09-15 Join either site's WiFi without a reflash
    The device builds now carry a two-entry wifi networks list, one secret
    pair per site (wifi_home_ssid/_password, wifi_workshop_ssid/_password),
    replacing the single wifi_ssid/wifi_password. fast_connect stays off and
    both networks keep the default priority, since the sites are never in
    range together. The fallback AP and captive portal are unchanged.
    Docs cover the new keys, quoting SSIDs exactly (the workshop's ends in a
    space), and what to redo in Home Assistant after a site move: the ESPHome
    entry's host and the image.dryer_screen URL, because HA only learns new
    addresses by discovery on its own LAN.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
2026-09-15 Keep site addresses and DNS names out of the site-move notes
    The repo is dropping device addresses for `<board>` (PR #19), so the
    section no longer says which board the page's addresses belong to or
    names the workshop's DNS suffix.
2026-09-15 Replace device IP addresses in the repo with placeholders
    The bench board's and the dev Home Assistant's LAN addresses were written
    into the HA docs, the dashboard header, the handoff, and the historical
    plans and specs. They change whenever the board moves between sites and
    are not something the repo should carry.
    - Docs and commands say `<board>` (the board's IP address), the
    placeholder CLAUDE.md already uses; the HA instance is named, not
    addressed.
    - Screen scenario 11 (boot strip showing the IP) and the mockup use
    198.51.100.200, an RFC 5737 documentation address that no device can
    have; it is wider than the old address, so the strip layout is still
    exercised. docs/display/s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
2026-09-15 Quote the <board> placeholder in shell commands
    Unquoted, <board> is parsed as a redirection, so a copied command fails
    with a syntax error. Quote it in every shell command and inline command
    that uses it; URLs typed into Home Assistant fields stay unquoted.
2026-09-15 Redraw the protoboard layout to scale after review
    Thing Plus is 58.4 mm long with the 12-pin row at the far end; every pin
    now sits on the 2.54 mm grid; mounting holes are clear of parts; the
    relay board's mains boundary runs between coil and contact pins; display
    header order matches its note; bulk cap added on the relay board.
2026-09-15 Version the production build and publish releases Home Assistant can install
    The production selector now includes esphome/version.yaml (semantic
    version, bumped in the PR) and packages/release.yaml: the ESPHome project
    name and version, http_request with an HTTP OTA backend, an update entity
    that polls a GitHub Pages manifest, safe mode and debug/version
    diagnostics. Home Assistant shows the update entity and offers a newer
    release with its notes.
    A vX.Y.Z tag (scripts/release.sh, which only tags origin/main) runs the
    release workflow: it checks the tag against version.yaml, compiles with
    the real secrets from the ESPHOME_SECRETS_YAML repository secret,
    assembles the versioned .ota.bin/.fac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
2026-09-15 Ship the production image without secrets and serve updates from the Release
    WiFi, the API encryption key and the OTA password move out of base.yaml
    and platform-esp32.yaml into packages/dev-secrets.yaml, included only by
    the hand-flashed virtual build (the host build keeps its key in its own
    platform package). The production yaml validates with no secrets.yaml at
    all: it raises an open setup access point, offers Improv over the USB
    serial port and dashboard_import, and lets Home Assistant set the API
    key on adoption.
    The repository is public, so the update entity polls the latest GitHub
    Release's manifest directly and the release workflow no longer needs a
    secrets secret or GitHub Pages.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
    [base.yaml]
2026-09-15 Close the review findings on the release package
    - api keeps an empty encryption block so the released unit can accept a
    key from Home Assistant; the dev builds merge their static key in.
    - The API reboot watchdog is off in production: an unadopted unit must
    keep drying, not reboot every 15 min.
    - http_request buffer_size_rx 2048: the releases/latest/download
    redirect's Location header overflows the 512-byte default.
    - No ESPHome OTA server and the web server's upload page is off; without
    a password either lets any LAN host reflash a mains controller.
    dashboard_import goes with it. Firmware arrives through the update
    entity or USB.
    - Firmware Version text sensor publishes on the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
    [base.yaml]
2026-09-15 Target ESPHome 2026.8.2
    CI and the release workflow pin the same version as the upgraded local
    install. The SVG sprites move to the 'image: platform: file' form that
    2026.8 asks for (the old form is removed in 2027.1); the rendered
    scenario screenshots are unchanged.
2026-09-15 Cache the native ESP-IDF toolchain that ESPHome 2026.8 installs
    The image no longer builds ESP-IDF through PlatformIO: frameworks,
    compilers, Python env and a ccache all land under /cache/idf when /cache
    is mounted (checked with a local docker compile). The two
    /root/.platformio mounts stayed empty, so they go; the single /cache
    mount is the toolchain cache.
2026-09-15 Add component datasheets for the hardware BOM
    Reference copies of the manufacturer documents for every part in the
    BOM, plus SparkFun's Eagle board and schematic files for the ESP32-S2
    Thing Plus, under docs/datasheets with a README that records the
    source, revision, page count and checksum of each file. hardware.md
    links to it from the BOM.
    MPS MP1584, ST BAT20J and the SMC VDW catalogue are still missing:
    their vendor sites refuse scripted downloads.
    [sparkfun-esp32-s2-thing-plus.brd, sparkfun-esp32-s2-thing-plus.sch]
2026-09-15 Add the buck, Schottky, valve, fan and display-module documents
    MPS MP1584 (RS Components' copy) and ST BAT20J complete the USB-pin
    power path; the SHT4x datasheet is now Sensirion's current v7.3; the two
    SMC VDW catalogues (the current series that decodes VDW22QABXB and the
    discontinued one a search finds first); an example 24 V fan
    specification; and the schematics of three 1.54" ST7789 modules, which
    show whether BLK is transistor-driven and that header orders differ
    between module families.
2026-09-15 Set the DS18B20 addresses of the production unit's probes
2026-09-15 Fix the update check: trim TLS and WiFi buffers, poll the manifest on GitHub Pages
    1.0.0 never fetched its manifest. The release download URL redirects to
    release-assets.githubusercontent.com through a ~900-byte signed URL and an
    RSA chain, and the S2's largest free block (12-16 KB with the display, web
    server and API up) could not complete that TLS handshake. Use mbedTLS
    dynamic buffers, a 4 KB outgoing record, free the TLS config and CA data
    after the handshake, keep 6 static WiFi RX buffers, add a Largest Free
    Block sensor, and read the manifest from GitHub Pages, which answers
    directly. Bump to 1.0.1.
2026-09-15 Hand firmware updates to ESPHome Device Builder instead of the on-device updater
    The S2 never has the ~17 KB contiguous block a TLS firmware download
    needs, so the http_request update entity could check for releases but
    never install one. Drop it and the HTTP OTA backend, add dashboard_import
    so Device Builder can adopt a flashed unit (the adopted YAML carries the
    owner's API key and OTA password), and leave the screen mirror out of
    production because its local external component does not resolve from a
    remote package. Bump to 1.1.0.
2026-09-15 Make the production YAML adoptable as a Device Builder remote package
    Remote packages resolve includes, local external components and image
    files next to the adopting YAML, not inside this repository. Move
    display_ui.h into a dryer_ui external component, read the SVG art from a
    display_assets substitution, and split the production selector into
    packages/production.yaml wrapped by desiccant-dryer.yaml (local sources,
    built by CI and the release workflow) and desiccant-dryer-adopt.yaml
    (component and art from GitHub at the release tag), which dashboard_import
    now points at.
    [display_ui.h]
2026-09-15 Document installing and updating releases through ESPHome Device Builder
2026-09-16 Prefer OTA encryption over a password in the adopted YAML
    ESPHome 2026.9 lets the esphome OTA platform reuse the API encryption key
    (encryption: {}) and warns that a password wastes flash and RAM. Keep the
    password form for older ESPHome, note that the release runs Device Builder's
    version not ours, and record that relabelling a test flash of the adopt
    selector must pin ui_ref and display_assets too.
2026-09-16 Say the owner adds the OTA block, not Device Builder
2026-09-16 Require ESPHome 2026.9.0 for the production build and fix the adopted OTA block
    Device Builder's adopted YAML has no api: and no ota: block, so the owner
    adds one. encryption: {} cannot inherit a runtime-provisioned API key, so
    document an explicit ota encryption key instead of a password. Pin CI and
    the release workflow to 2026.9.0 and set min_version on the production and
    adopt selectors so the published images match what an owner's Device
    Builder compiles; the bench builds keep no floor because Homebrew still
    ships 2026.8.2.
2026-09-16 Record the verified Device Builder install and the -s argument order
2026-09-16 Adopt with no owner YAML edits: let Device Builder mint the key
    Device Builder only mints an API key into the adopted YAML when the
    resolved package does not already enable encryption, and base.yaml's bare
    'api: encryption: {}' counted as package-provided, so the owner had to
    paste an OTA block with a key of their own.
    Move that block into packages/api-provisioned.yaml, included by the image
    an owner flashes but not by the adopt selector, and give the adopt
    selector packages/ota-adopted.yaml, whose keyless 'encryption:' inherits
    the minted key and compiles OTA encryption as required. The adopt selector
    therefore fails to validate on its own with 'encryption key to inherit',
    which is the exa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
    [base.yaml]
2026-09-16 Redraw the protoboard layout so it can be built as drawn
    The ESP32-S2 Thing Plus is now its real 64.77 x 22.86 mm outline from
    SparkFun's Eagle files, component side up, standing along the left edge
    with the antenna at the top edge and USB-C at the bottom; the header rows
    are no longer the solder-side mirror image and the Qwiic sits at the USB
    end. The relay uses the datasheet's five pin positions with COM at the
    coil end inside the mains boundary, the flyback diodes have their bands
    toward the supply, every net is a drawn wire or bus, the harness is a
    keyed JST-XH pair, and the SVG prints 1:1 with a scale bar.
2026-09-16 Document the protoboard build: BOM, net lists, J-USB, earthing
    Adds the parts the drawing needs to the BOM (PN2222A replacing the ambiguous
    2N2222 line), a per-board net list, the buck set-up as the first build step,
    the corrected J-USB mechanism with the series Schottky and its two
    conditions (BAT20J/AP2112/MP1584 numbers from docs/datasheets), the PE and
    fuse arrangement, the relay NC/COM notes, and the open review questions.
2026-09-16 Note that the breadboard picture shows the ESP from its solder side
    Its header rows are mirrored relative to the component side (USB-C left
    puts the 12-pin row on top); a note is cheaper than rerouting every wire.
2026-09-16 Correct the Schottky's role and specify heater thermal fuses
    Copilot is right that a diode with its anode at buck 5 V cannot block
    buck-to-host current: that is its forward direction, and it is how the
    board is powered. It blocks the host back-feeding the buck output, the 5 V
    bus and the relay coils. J-USB is the only thing that keeps the buck off a
    computer's port, so say that in both the drawing and hardware.md, and say
    what a real fix (power-path ORing) would take.
    A welded relay contact is a single-fault hazard the firmware cannot clear,
    and we have thermal fuses for it: each heater now gets a one-shot TCO in
    its switched L lead at the pack. Tf 140 C sits above the firmware's 120 C
    over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
2026-09-16 Spec the 212 C thermal fuses we have, and say what they do not cover
    The fuses on hand trip at 212 C, not the ~140 C class the last commit
    assumed. That is far above the firmware's 120 C overtemp latch, so it will
    never nuisance-trip, but it only limits fire: the desiccant, the DS18B20
    probe leads (under 100 C) and the 50 C valve are gone long before 212 C.
    Mount them against the heater sheath, the only surface likely to reach that
    in a stuck-on failure, and treat them as unproven until two measurements
    are made - that a stuck-on heater really drives the mounting point past
    212 C, and that normal regen stays under the fuse's holding temperature.
    If the first fails, a 140 C class fuse or a pa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
2026-09-16 Finish the PN2222A rename in the docs this PR already touches
    The cloud review caught breadboard.svg still calling the relay drivers
    2N2222 while hardware.md and board-layout.svg name PN2222A and warn that a
    P2N2222A is C-B-E. A bench builder following the breadboard picture got the
    ambiguous name and none of the warning. Sweep the same rename through
    CLAUDE.md and the bring-up checklist so all four agree.
2026-09-16 Put the PN2222A vs P2N2222A warning on the design sheet itself
    The two parts are mirror images, both sold as a TO-92 '2N2222', and the
    board builder is holding the part when it matters - not reading the caveats
    column. Each stage is now labelled 'PN2222A *' and the asterisk points at a
    boxed callout under the relay board: which pinout is which, that the
    marking is the only way to tell, what fitting it backwards does (collector
    and emitter swapped, stage never switches, base-emitter breakdown near
    6 V), and the 1.27 vs 2.54 mm lead pitch.
2026-09-16 Respec the heater cutouts for the 133 C thermal fuses ordered
    133 C reverses the mounting decision the 212 C parts forced: clamp each
    fuse to the pack body next to that pack's DS18B20, never to the heater
    sheath, which runs far hotter than the pack and would open a 133 C fuse on
    the first regen cycle.
    It also puts the fuse's holding temperature (roughly Tf minus 15-25 C, so
    about 110-118 C) at or below the firmware's 120 C overtemp latch, which
    inverts the order of protection: the one-shot fuse could open before the
    firmware ever faults. Either confirm the part holds above 120 C or lower
    overtemp to about 110 C - a firmware change, not in this PR. Both the
    drawing and hardware.md now spell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
2026-09-16 Record the SF129E datasheet figures and file the datasheet
    The fuses are SEFUSE SF129E: Tf 133 C, operating 129 +/- 2 C, holding
    temperature Th 118 C, maximum Tm 159 C, 10 A / 250 VAC. Th 118 C is the
    number that matters - the firmware limit has to stay below it - and it
    settles the earlier worry that a 133 C part might hold as low as 105 C.
    The ladder is now regen 90 < overtemp 110 < Th 118 < Tf 133 < Tm 159.
    Adds the catalogue to docs/datasheets/ with its source and hash, noting
    the site answers scripted downloads with a JavaScript challenge.
2026-09-16 Drop the overtemp default to 110 C so firmware trips before the fuse
    Each heater gets a SEFUSE SF129E thermal fuse (Tf 133 C) clamped to the
    pack body as the backstop for a welded relay contact. A thermal fuse holds
    continuously only some way below Tf, so the firmware limit has to sit under
    that holding temperature: clearing a fault is a button press, replacing a
    blown one-shot fuse means opening the pack. At 120 C that order was not
    guaranteed.
    Bumps the production version to 1.2.0 and brings control-logic.md, the
    bring-up checklist, virtual-testing.md and the bench dashboard help text
    into line. Note these numbers are restore_value, so running units keep
    their stored 120 C until it is set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
    [base.yaml]
2026-09-16 Cite the SF129E holding temperature behind the 110 C limit
    Now that the datasheet is in the repo, say where 110 C comes from: Th is
    118 C, the most the fuse may sit at continuously, against Tf 133 C. 110 C
    clears it by 8 C and stays 20 C above the 90 C regen setpoint. Replaces
    the earlier hedge about possibly needing 100 C.
    [base.yaml]
2026-09-16 Rename J-USB to JP-USB, and specify fuse placement and wire sizes
    Review feedback: J-USB read as a board-mounted USB connector, which is
    exactly what it is not. It is a 2-pin header and a shunt, so use the
    jumper designator and say so in the legend.
    The fuse question was answered only as 'at the inlet'. Spell out the
    ordering that makes one fuse cover everything - inlet L, fuse, then the
    split to PSU live and the board's L terminal - and what a PCB-mount holder
    on the relay board would require instead: the PSU live spurred off the
    fused side, or that branch runs unfused.
    Wire gauges were missing entirely. Adds a Wire sizes table: nothing here is
    ampacity-limited (one heater at a time is ab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
2026-09-16 Put the mains fuse and the PSU spur on the relay board
    Review asked for the 5 x 20 PCB holder to go on the board. It does not fit
    on 5 x 7 cm: a holder needs about 23 mm of clear run and the fourth mains
    block for the PSU feed leaves no gap that big, so the relay board becomes
    7 x 9 cm, the same stock as the logic board.
    F1 now sits in L between the incoming L terminal and both COM pins, with
    the 24 V PSU's live spurred off the fused side at its own block, so one
    fuse covers the heaters and the supply. N passes through to the heaters
    and the PSU unswitched and unfused. Clips are drawn on 22.86 mm centres
    (9 x 2.54); like the buck footprint, check the holder before drilling.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
2026-09-16 Add the failure-modes catalogue and its HTML report
    docs/failure-modes.md lists 199 hardware and firmware failure modes for the
    controller, grouped into twelve subsystems and ranked P0 (fire or shock) to
    P4 (display only). Each row carries a kind (HW/WIRE/FW/CFG/OPS), where it
    can be verified (virtual/bench/live/inspect) and a flag for faults the
    firmware cannot detect today. A grouping table proposes 47 GitHub issues
    sized for one PR each, and a retired-ID table keeps the numbering stable.
    scripts/failure-modes-report.py renders the markdown as a filterable,
    colour-coded HTML page; the markdown stays the source of truth.
2026-09-16 Add the human inspection checklist
    docs/inspection-checklist.md expands every inspect row of the failure-modes
    catalogue into a hands-on check with a pass condition and the tool needed,
    ordered by stage: board assembly, mains heater path, mains wiring and
    earthing, sensors, firmware pre-flight, first energised check, and periodic
    service. Each item names the failure-mode ID it guards against.
2026-09-16 Review pass: 15 new failure modes, tighter rows, numbering and issue rules
    Adds heater current sensing, resettable cutout, cold-start probe agreement,
    duplicate probe address, RH plausibility band, valve and fan feedback, 24 V
    rail monitoring, A/B labelling, watchdog and panic-handler verification, a
    terminal cannot-dry state, persisted-global schema versioning and two Home
    Assistant state-restore cases (A-30, A-31, B-25, B-26, C-14, D-17, E-11,
    F-20, G-16, H-19, H-20, I-26, J-11, K-14, K-15). Tightens 19 long rows,
    standardises on active/standby pack wording, adds a how-to-read-a-row
    paragraph, numbering rules, and a rule for attaching new rows to issues.
    Checklist gains the five new inspec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
2026-09-16 Raise K-01 to P0: a manual heater toggle while disabled is never corrected
    The interval returns on the Dryer Enabled guard before apply_outputs and
    before the overtemp check, so a heater switched on by hand while the dryer
    is disabled stays on with no protection (Copilot review). K-02 reworded
    the same way, issue 34 raised to P0, and the checklist header now says it
    also carries the hand-done bench and live commissioning checks.
2026-09-16 Design: move the panel to mipi_spi and bring back on-device updates
    The frame buffer, not the web server, is what denies mbedTLS its ~17 KB
    contiguous block. ili9xxx cannot buffer less than a full frame, so the
    panel moves to mipi_spi with a reduced buffer on production and a full
    one on the test builds.
    Records the redraw multiplier up front: MipiSpiBuffer::update() re-runs
    the whole writer once per band, so buffer_size multiplies draw cost and
    no setting gives both a free block and a ~500 ms redraw. Effort on
    draw_ui() is capped; the measured number gets reported either way.
    The screen mirror stops peeking into driver internals and renders into
    its own Display, the pattern preview_captur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
2026-09-16 Plan: mipi_spi migration in seven tasks
    Orders the mirror rewrite before the driver swap so the driver-agnostic
    mirror is verified against ili9xxx first, which isolates any later
    /screen.png failure to the swap itself.
    Records a deviation from the spec: the writer-hijack cannot work, because
    the ui_draw script ignores the Display it is handed and draws to id(panel)
    unconditionally. The mirror calls draw_ui() against its own band Display
    using the state singletons the script already fills, which is the pattern
    the scenario build uses.
2026-09-16 Plan: defer the panel sign-off; the bench board has no display
    The board can still prove heap, redraw timing, the on-device install and
    /screen.png, because the mirror renders from draw_ui() and never touches
    the panel. What it cannot prove is how the glass looks, which is exactly
    the risk a partial buffer with auto_clear_enabled: false carries. Records
    that as outstanding rather than letting the PR imply it was checked.
2026-09-16 Plan: correct build paths, keep real secrets, drop the speculative draw guard
    The ESP builds are native ESP-IDF, not PlatformIO, so firmware lands in
    build/ and not .pioenvs/; esptool is a standalone command here. The
    worktree now carries the real dev credentials, because the CI placeholder
    SSIDs mean the board never joins WiFi and nothing on-device can be
    verified.
    Task 3 drops the band_touches guard by user decision: MipiSpiBuffer never
    sets a clipping rect, so it would have been dead code. The task measures
    and reports instead.
2026-09-16 Render /screen.png from draw_ui instead of the driver's buffer
    The mirror reached into ILI9XXXDisplay's private members through a Peek
    struct to read the frame buffer. That ties it to one driver and needs a
    full frame in RAM, neither of which survives the move to mipi_spi with a
    partial buffer.
    draw_ui() is a pure function of dryer_ui::last_state() and last_assets(),
    which the ui_draw script refreshes on every redraw, so the mirror now
    re-renders the frame itself into a 24-row band buffer and streams PNG rows
    as it goes. No driver header, no private access, and the interlock that
    existed only to avoid reading a half-drawn shared buffer is gone.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
2026-09-16 Plan: use <board> instead of a real device IP
    Tracked files must not carry real board or Home Assistant addresses, and
    the address changes anyway when the unit moves between the home and
    workshop networks. Adds that to the global constraints so later tasks do
    not reintroduce it.
2026-09-16 Plan: the two screen PNGs cannot be byte-identical
    Task 1 captures the virtual build with simulated sensors and a running
    uptime; Task 2 captures hw-test with no probes attached. Comparing bytes
    would fail for the right reasons and mislead an implementer. Compares
    structure and palette usage instead, which is what actually proves the
    band stitching and the RGB332 mapping survived the driver swap.
2026-09-16 Move the panel from ili9xxx to mipi_spi with a per-build buffer
    ili9xxx cannot buffer less than a full frame, so the S2 never had the
    ~16,749-byte contiguous block mbedTLS needs and the on-device updater could
    check for releases but never install one.
    mipi_spi takes a buffer_size fraction. Production runs 50% to free roughly
    29 KB; the test builds keep 100% because they never self-update. The pin
    map, SPI bus, backlight and invert_colors are unchanged, and color_depth
    8bit is the same RGB 3-3-2 grid color_palette 8BIT used.
2026-09-16 Plan: restore the 40MHz SPI clock the driver swap dropped
    ili9xxx defaulted to 40MHz; mipi_spi defaults to 10MHz and the ST7789V
    model sets no override, so the swap quartered the SPI clock without
    anything in the repo asking for it. Undoing a regression, not optimising,
    so it sits inside the effort cap. Flags that 40MHz is restored but not
    re-validated, since no panel was attached.
2026-09-16 Plan: Task 3 closes Task 2's two evidence gaps
    Task 2's runtime evidence was all hw-test at 100%, the configuration
    closest to the old driver, so the 50% buffer has never actually run and
    nothing has exercised MipiSpiBuffer's multi-band path (/screen.png proves
    the mirror's own banding, not the driver's). Task 3's VERBOSE 50% build is
    the first run of either, which makes it a verification step and not only a
    measurement. Also folds in the two review minors about this file.
2026-09-16 Measure the mipi_spi redraw cost and bound the tick delay
    MipiSpiBuffer::update() re-runs the writer once per band, so a 50% buffer
    draws the UI twice per redraw. The multiplier cannot be removed through
    ESPHome's public Display API: the only lever is the clipping rect, and
    MipiSpiBuffer never sets one. So this records the measurement and lets
    update_interval absorb what is left, rather than adding a guard that would
    do nothing. The measured value is reported rather than the target restated.
    Also restores the SPI clock the mipi_spi driver swap silently dropped:
    ili9xxx defaulted to 40MHz, mipi_spi defaults to 10MHz with no ST7789V
    override. Measured on the bench (no panel attached, so the c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
    [display-st7789.yaml]
2026-09-16 Measure the 100% redraw counterfactual, record numbers in tracked YAML
    Fixes review findings on f4f086e: the ~375ms 100%-buffer redraw was
    derived, not measured, so it was measured directly on hardware
    (hw-test build, VERBOSE logger, temporary and reverted) - 377ms mean,
    372-389ms range, n=11, confirming the derivation. Moved the actual
    measured numbers (699ms at 50%, 377ms at 100%) out of the gitignored
    task-3-report.md and into tracked comments in display-st7789.yaml and
    production.yaml, replacing the dangling docs/releasing.md pointer.
    Corrected the "startup-only" warning characterization (all redraws
    exceed threshold, not just the first) and documented that production's
    10s update interv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
    [display-st7789.yaml]
2026-09-16 Correct three inaccuracies in the new display comments
    The override pointer named the wrong file and the wrong value: production
    lives in packages/production.yaml, and what sits below in this file is the
    5s default. Both redraw figures came from the hw-test build, which also
    runs the web server and the screen mirror, so the absolutes are indicative
    for production while the 322 ms delta between them is the reliable number.
    And the claim that control ticks are never skipped is reasoning about how
    ESPHome's loop schedules intervals, not something that was instrumented;
    it now says so rather than sitting unmarked among measured values.
    [display-st7789.yaml]
2026-09-16 Bring back the on-device update entity
    With mipi_spi's reduced frame buffer the S2 finally has the contiguous
    block mbedTLS needs, so the http_request updater that 1.0.x had to drop
    works. Restores the client, the OTA download backend and the update entity
    pointed at the GitHub Pages manifest, and corrects the header that said
    the S2 could never do this.
    Still no OTA server: nothing listens, so updates stay pull-only.
2026-09-16 Plan: the install test must run backwards, and say so
    The only published release is 1.1.0, which is precisely the build with no
    updater in it, so a 1.2.0 device will be offered 1.1.0 as a downgrade.
    That still exercises every part of the path that never worked on this
    hardware - TLS manifest fetch, the contiguous allocation, the HTTPS
    download, md5, flash, reboot - so it is a valid acceptance test. What it
    cannot prove is the forward direction, which is untestable until 1.2.0 is
    published. Records both, and requires a USB reflash afterwards because the
    installed 1.1.0 cannot climb back on its own.
2026-09-16 Retire the ESPHome Device Builder adoption path
    With the unit updating itself there is no reason to keep a second update
    route, and two vaguely documented routes are worse than one. Deletes the
    adopt selector, the remote component source and the adopted OTA server,
    and drops dashboard_import.
    api-provisioned.yaml stays: that is the flashed image's runtime API key
    provisioning, which Home Assistant still uses to adopt the device.
    Also updates code comments (release workflow header, desiccant-dryer.yaml,
    display-draw.yaml, ui-code-local.yaml, dryer_ui/__init__.py) that described
    the now-deleted remote-adoption mechanism.
    Nothing now resolves sources at a release tag, so scripts/release.sh n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
2026-09-16 Say what the captive-portal OTA path actually means
    The file contradicted itself: the header described the exposure honestly
    while the comment above the ota: block still asserted that nothing listens
    and no LAN host can push firmware to a mains controller. The absolute is
    gone and now points at the header instead.
    The header also named the mechanism without ever naming the consequence,
    which is what makes an accepted risk actually informed: while the portal
    is up, anyone in WiFi range can join an open AP with no credential and
    flash arbitrary firmware onto a unit switching two 120 VAC heaters. It
    also scoped the window to a WiFi outage, when the portal is equally up on
    an unprovisioned unit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
2026-09-16 Remove the last references to the deleted adoption path
    base.yaml still described where the adopt selector got its API key, which
    a filename-based grep could not catch because it named the selector rather
    than a file. production.yaml kept a dangling clause about resolving from a
    remote package.
    Also corrects a rationale that was replaced with a false one: the drawing
    code is a component because that gives it a real dependency on Version: ImageMagick 7.1.1-47 Q16-HDRI aarch64 22763 https://imagemagick.org
    Copyright: (C) 1999 ImageMagick Studio LLC
    License: https://imagemagick.org/script/license.php
    Features: Cipher DPC HDRI Modules OpenMP
    Delegates (built-in): bzlib fontconfig freetype heic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
    [base.yaml]
2026-09-16 Document the single update route and the mipi_spi display
    Corrects the platform decision and layout notes that still described
    color_palette: 8BIT and the ili9xxx frame buffer, rewrites releasing.md
    around the on-device updater with an explicit recovery section saying USB
    is the only fallback, and drops every Device Builder reference. Bumps to
    1.2.0.
    The recovery section records the two security properties accepted during
    this work: the captive portal's unauthenticated POST /update over the open
    setup AP, which web_server: ota: false does not close and which is not
    limited to outages, and the fact that the update trust root is push access
    to gh-pages, since http_request OTA has no code sign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
    [display-st7789.yaml]
2026-09-16 Record the measured tick timing and the real upgrade path for 1.1.0 units
    The control-tick claim was reasoning about ESPHome's scheduler and was
    labelled as such. It is now instrumented: over 236 s and 48 publishes the
    5 s tick held a 5.00 s median and a 5.36 s worst case with no skips, while
    the ~700 ms redraw ran once per 10 s throughout. It can say so.
    The recovery note covered only 1.0.x, but 1.1.0 is what is in the field,
    and it is the release with no updater at all. Stock 1.1.0 images need the
    USB trip; units still adopted in Device Builder can take one last push
    through the add-on before it is retired.
2026-09-16 Correct the docs and comments the final review found wrong
    - docs/releasing.md no longer offers a Device Builder "one last push" for
    fielded 1.1.0 units. The adopt selector is gone from main, and repointing
    an adopted config at @v1.1.0 resolves its whole include tree at that tag,
    so it rebuilds 1.1.0 rather than delivering 1.2.0. USB is the single
    documented path.
    - The min_version floor is justified as the release pin it is. buffer_size
    and color_depth both exist in 2026.8.2; production.yaml,
    display-st7789.yaml and docs/releasing.md now agree that the shared driver
    package emits those keys for every build and only the released selector
    carries a floor.
    - screen_mirror: BAND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
    [display-st7789.yaml]
2026-09-16 Drop the /screen.png screen mirror; use the host build to preview the screen
    The mirror was a lot of machinery for one feature: a local external
    component, a package wired into two selectors, a checker script, a custom
    Lovelace card, an HA template image and a refresh automation. The host
    build (esphome/desiccant-dryer-host.yaml, docs/host-preview.md) already
    renders the same drawing into an SDL window on the Mac, so that is now the
    only way to see the screen without hardware.
    Removed: esphome/components/screen_mirror, packages/screen-mirror.yaml,
    scripts/check-screen-png.py, docs/screen-in-ha.md,
    docs/ha/dryer-screen-card.js, and the mirror include from the virtual and
    hw-test selectors. T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
2026-09-16 Add the verification plan, test cases and test coverage in the report
    docs/verification-plan.md defines six test types (logic, detect, infer,
    lint, physical, hil), their harnesses and statuses, the YAML case format,
    and 188 tests that cover all 214 failure modes exactly once. Red tests
    state the desired outcome so they fail until the gap closes. Nine plant
    model knobs still to add are listed. tests/cases/ holds the first nine
    cases. The report script parses the plan, fails on an uncovered row,
    adds a Test column and a Tests section with a status filter.
2026-09-16 Cap the overtemp limit at 118 C and add the config-lint CI job
    `Pack overtemp limit` allowed 125 C, above the SF129E thermal fuse's
    118 C holding temperature, so an operator could set a limit at which the
    one-shot fuse opens before the firmware faults. The maximum is now 118,
    and because the number is `restore_value: true`, a second `on_boot` block
    at priority -100 (after every component has set up, so the restored value
    is in place) re-clamps a stored value above the new maximum and logs a
    warning. Nothing else in the control logic changes.
    `tests/lint_config.py` is the first automated test job from the
    verification plan: it runs every case in `tests/cases/` with
    `harness: ci-lint`, dumpin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
2026-09-16 Address the Copilot review: stale operator docs, J-09, T-B19 case
    The review's two "critical" findings do not hold, but three of the
    suppressed ones do.
    Real, and fixed:
    - docs/control-logic.md and docs/hardware.md still told an operator that a
    stored 120 °C survives an upgrade and must be reset by hand. Both now
    describe the 118 °C ceiling and the boot clamp, and are explicit that the
    clamp is a ceiling and not a reset to the default: a stored 115 °C still
    survives and still needs a manual change.
    - The J-09 catalogue row still cited the 125 °C maximum as an open gap.
    T-B20 covers J-09, so the row is restated around what is still open:
    `regen_hold_min` down to 0, `regen_te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
    [lint_config.py]
2026-09-16 Run the host verification cases headlessly in CI
    tests/run_cases.py executes every case file that is not `harness: ci-lint`
    against the native host build: one process and one prefs directory per
    case, connected over the ESPHome native API, applying `setup` and walking
    `steps` (set, wait_sim_min, wait_until, expect, press, restart). Results
    are judged against the case's declared status with the same semantics as
    the config lint — a green case that fails and a red case that passes are
    both errors — and a case that needs a `Sim *` knob the plant model does
    not have yet is skipped with that knob named.
    The host build needs no variant to run without a window:
    SDL_VIDEODRIVER=dummy renders th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
    [run_cases.py]
2026-09-16 Address the Copilot review: restart exit code, runner errors, chown
    - `restart` now requires a clean exit(0). It was getting SIGPIPE (-13)
    because the runner dropped the API connection before the process had
    finished writing to it, so waiting for the exit now comes first and a
    genuine crash during a simulated reboot fails the case instead of being
    reconnected to.
    - An exception from the runner itself is no longer folded into the case's
    verdict. It printed as `FAIL`, which a red case counts as its expected
    failure, so a broken runner could leave the job green. It is now a
    separate `ERR UNEXPECTED` line that always fails the job.
    - The host-cases job hands `esphome/.esphome` back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
    [run_cases.py]
2026-09-16 Bump the production version to 1.2.2
    A version-only release to exercise the Device Builder upgrade path from
    1.2.1 on the bench unit. No firmware change.
2026-09-17 Add the eight plant-model fault knobs for the host cases
    The detect and infer cases need a sensor or actuator to misbehave, and
    the plant model had no way to make one. Adds Sim Relay Stuck On A, Sim
    Probe 85C, Sim Probe Garbage A, Sim Case Probe Fault, Sim Probes
    Swapped, Sim RH Fault, Sim RH Frozen and Sim Fan Stalled, shaped like
    the existing Sim Probe A Fault.
    The sensor-fault knobs act only in the publish lines at the end of the
    plant tick, so the plant keeps integrating underneath one and the true
    value is back the moment the knob goes off; nothing they produce can
    reach a persisted global.
    Sim Fan Stalled needed the case model to notice the fan at all: the
    enclosure now settles at am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
    [hw-virtual.yaml]
2026-09-17 Model the air path so Sim Valve Stuck A means something
    The plant had no notion of valve position: outlet RH derived from the
    controller's active_pack and service_elapsed_s, both of which change on a
    commanded swap whether or not any air moved. A stuck valve modelled on
    top of that would have shown RH dropping to 1 % on a swap that never
    physically happened, which is the opposite of the symptom.
    Valve A now has a modelled position that follows the Valve A switch and
    latches while Sim Valve Stuck A is on. RH derives from which pack the
    air is actually flowing through and from a plant-owned service timer
    that resets only when a different pack comes on line. Both valves closed
    (the 500 ms wind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
    [hw-virtual.yaml]
2026-09-17 Document the new knobs and retire the "New Sim knobs" section
    docs/virtual-testing.md's knob table gains the nine switches, and the
    notes on the model now mention what the fan does to case temperature,
    which it did not do before this change.
    docs/verification-plan.md's "New Sim knobs" section described knobs that
    did not exist yet; it is replaced by a short note saying where they live
    and what the valve one models, since the table's contents are now the
    knob table in docs/virtual-testing.md. Its Sim Case Probe Fault row also
    misspelled T-B16 and T-B10 as "T-B1011"; the row is gone with the
    section. The skip paragraph and the "Still needed" note no longer claim
    the knobs are missing.
    Two te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
2026-09-17 Refresh the plant model summary at the top of hw-virtual
    The heater line still said the switch decides, which Sim Relay Stuck On A
    no longer makes true, and the case line predated the fan having any
    effect on enclosure temperature.
    [hw-virtual.yaml]
2026-09-17 Address the Copilot review
    The substantive point was real: T-B06 enabled Sim Probe 85C in setup, so
    the pack reached HEATING only because today's firmware accepts 85.0. Once
    the sentinel is rejected the reading is unavailable, the control tick
    returns on isnan(t_sb) before the state machine, and the pack would never
    leave WET — wait_until would time out and the case could never go green
    after the fix it was written for.
    The sentinel now goes on only once the pack is HEATING. Sim Heater Fault
    is gone: on from setup it latched the "not heating" fault before the
    sentinel could mask the probe, and applied later it would have let the
    pack warm first. Instead the thermal knobs are pinned slow (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
2026-09-18 Stop Home Assistant and the web server commanding the relays
    K-01/K-02: the four `Heater A/B` and `Valve A/B` switches were exposed to
    Home Assistant and to the unauthenticated web server on port 80, and the
    5 s control tick returned on `if (!id(dryer_enabled).state)` before both
    the overtemp check and `apply_outputs`. With `Dryer Enabled` off, one
    toggle from either place energised a 120 VAC heater indefinitely with no
    protection running; with it on the exposure was one tick.
    Both halves of the fix, per item 34 of docs/failure-modes.md:
    - The four switches are `internal: ${outputs_internal}`, true by default,
    so the production image has no commandable relay entity at all. Four
    read-on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
    [base.yaml, hw-virtual.yaml, lint_config.py]
2026-09-18 Record the K-01/K-02 fix in the catalogue, plan and guides
    - failure-modes.md: K-01 and K-02 lose their gap marks and say what 1.2.4
    does; K-03 and K-04 are narrowed (an automation or the web server can no
    longer reach a relay, only the tunables); issue 34 records the state.
    - verification-plan.md: T-K01 is green and describes the stray-command
    injectors it now uses, and T-K01L is the ci-lint half asserting the
    released image really has no commandable relay entity. A trailing letter
    on a test ID is now the documented way to put a second harness on one
    row, which failure-modes-report.py accepts and checks.
    - The two host cases that watched `Heater A` directly read the mirrors
    in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
2026-09-18 Drop the racy "relay came on" step from T-K01
    The first assertion watched for `Heater A Relay` going on after the stray
    command, which is a race against the very thing the case exists to prove:
    the control tick turning it back off. It held on the PR run and locally,
    and lost on main, failing the host-cases job on 7e007aa.
    The case now only asserts the relay is off again. That the injector bites
    is shown by its own log line and by the pre-fix run, where the relay was
    still on three ticks later.
2026-09-29 Move display DC to GPIO7 and RST to GPIO9
    GPIO7 (A4) was the unused pin on the 16-pin header; GPIO14 (A2) is now
    free. Updates the driver config, the pin map in CLAUDE.md, the pinout and
    hardware docs, and the wire routes in both wiring drawings.
    Boards wired DC->9 / RST->14 need rewiring before they take 1.2.4.
2026-09-30 Document the 1 kΩ relay-driver base pulldown
    The protoboard was built with 1 kΩ from each PN2222A base to GND instead
    of the specified 10 kΩ; it was tested and is being kept. Update the BOM,
    driver-stage diagram, harness notes, relay-board net list, failure mode
    A-23, test T-A23 and both wiring drawings to match, and record the base
    drive margin and expected meter readings in hardware.md.
    Claude-Session: https://claude.ai/code/session_015waKAARNfAT635um58hoha
2026-09-30 Move the case fan to GPIO8
    The protoboard's fan MOSFET gate is wired to GPIO8 (12-pin position 8),
    not GPIO6, and is staying there. GPIO8 is an ordinary output on the S2:
    not a strapping pin, not flash or USB, nothing else on the Thing Plus
    uses it, and the 10 kOhm gate pulldown keeps the fan off through boot.
    Updates the Case Fan switch pin and the pin comment in base.yaml, the pin
    map in CLAUDE.md, hardware.md and pinout-verification.md, and the fan
    wire route and labels in both wiring drawings. Unreleased 1.2.4 already
    carries the display DC/RST move, so this rides in the same version.
    Boards wired fan->6 need rewiring before they take 1.2.4.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
2026-09-30 Add a board continuity check for the protoboard build
    A pin-by-pin multimeter pass for after moving the build from the
    breadboard to the logic and relay boards: shorts, output channels,
    display header, 1-wire bus, power path, the relay board's mains side,
    and a sweep for bridges between neighbouring pads. Expected readings
    follow the 1 kOhm relay base pulldown and the fan on GPIO8. Linked from
    the protoboard build steps and the inspection checklist's first stage.
    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
2026-09-30 Document the 5.1 kOhm 1-wire pullup
    The protoboard was built with a 5.1 kOhm DQ pullup instead of 4.7 kOhm;
    it is fine for three DS18B20s on short leads and is being kept. Update
    the BOM, breadboard notes, net list, inspection checklist item B-10, both
    wiring drawings and the continuity check, and describe the climbing
    DQ readings the probes' protection diodes and the 3V3 decoupling
    capacitors produce on a meter.
    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
2026-10-08 Tell the two Thing Plus EN pins apart in the docs
    16-pin #1 and 12-pin #2 were both labelled "EN", but SparkFun's Eagle
    files show two different nets. 16-pin #1 is CHIP_PU, the ESP reset
    (R10 10k to 3.3 V, C8, RESET button S1, auto-reset Q2, JTAG !RESET),
    silkscreened RST on top and RESET on the back. 12-pin #2 is the AP2112
    LDO enable (R8 100k to VIN), silkscreened EN; pulling it low drops the
    3.3 V rail.
    Relabel them "RESET (EN/CHIP_PU)" and "LDO EN" in the continuity
    check, hardware.md and pinout-verification.md (whose net column had
    J4 pin 1 as EN), and "RST" / "LDO EN" on the two drawings.
2026-10-12 Add the ESP32-C6 Thing Plus board support design
    Second supported board alongside the S2: same socket, per-chip board
    packages with pin substitutions, one release manifest with two builds.
2026-10-12 Add the ESP32-C6 board support implementation plan
    Eleven tasks, each quoting config, scripts and doc edits that were applied
    and checked in a scratch copy first. Two spec corrections found on the way:
    the datasheet confirms GPIO8 low with GPIO9 low is an invalid boot mode,
    and the C6 CI variants are named c6-<build> so the existing cache restore
    prefixes cannot match them.
2026-10-12 Assert the five output pins in the config lint
    The lint runner's assertion keys may now be dotted, so a case can read a
    switch's pin.number. T-J12 pins the ESP32-S2's five output pins before the
    pin map moves into a board package.
2026-10-12 Move the ESP32-S2 board, logger port and pin map into a board package
    packages/board-s2.yaml now holds everything that depends on the chip: the
    esp32 block, the logger's UART and a table of pin_* substitutions by header
    position. The controller, sensor and display packages take their pins from
    those and hold no GPIO numbers, so a selector with no board package fails
    validation. The normalized config of all five builds is unchanged.
2026-10-12 Add the ESP32-C6 Thing Plus board package and its selectors
    packages/board-c6.yaml gives the SparkFun Thing Plus ESP32-C6 the same
    header positions the main board is wired to, with that chip's GPIOs. Two
    selectors use it: the production build (same device name, its own build
    directory) and a bench build. T-J12C pins the C6's five output pins, and
    the production-invariant lint cases now read the C6 selectors too.
    Nothing here has run on a C6 yet.
2026-10-12 Write one release manifest with a build per chip
    make-manifest.sh now takes <chip>=<build-dir> pairs and writes one
    esp-web-tools manifest with an ESP32-S2 and an ESP32-C6 build, each with
    chip-suffixed image names. It reads the chip id from each image header and
    refuses an image built for the other chip, so a mixed-up build directory
    cannot publish a unit an image it cannot run. tests/make_manifest_test.sh
    exercises it with stand-in images.
2026-10-12 Build and release an image per chip; version 1.3.0
    CI compiles the two ESP32-C6 selectors beside the S2 ones, with a toolchain
    cache per chip, and runs the release packaging check on each production
    image. The release workflow compiles both production selectors and
    publishes one manifest that lists both. 1.3.0 is the first version with an
    ESP32-C6 image.
2026-10-12 Record the ESP32-C6 Thing Plus pinout from SparkFun's schematic
    Adds SparkFun's Eagle schematic and board file for the Thing Plus ESP32-C6
    (commit fb7352f) and Espressif's ESP32-C6 and WROOM-1 datasheets, and a C6
    section in pinout-verification.md: both headers pin by pin, the nets each
    of our pins shares on that board, and the chip's boot-strap constraints.
    Read from the files only; nothing checked on a physical board.
2026-10-12 Document fitting and bringing up an ESP32-C6 board
    hardware.md gains the steps before a C6 goes in a socket (cut ALRT and
    SD_DET, keep the uSD slot empty, flash it out of the socket) and a table of
    each header position's GPIO on both boards. hardware-bringup.md gains the
    C6 bench steps, none of which has been run yet. The continuity check adds
    the four socket positions the C6 needs left unconnected.
2026-10-12 Catalogue the ESP32-C6 failure modes and their checks
    Six rows: a wrong pin in a board file (J-12, pinned in CI by T-J12 and
    T-J12C), the ALRT jumper left closed (D-18), a card in the uSD slot or
    SD_DET left closed (G-17), the weaker RESET pull-up (F-21), the GPIO8 boot
    strap against USB flashing in the socket (H-21) and an image for the wrong
    chip (H-22). Each has its test row, its issue, and for the three inspect
    rows a checklist item.
2026-10-12 Describe two boards and one release in the release docs, README and CLAUDE.md
2026-10-12 Correct three statements the branch review found
    H-22 and its test promised that esptool refuses an image for the other
    chip. Read from esptool's source, that holds for the C6 factory file on an
    S2 board but not the reverse: the S2 factory file starts with padding, so
    its header is never checked unless --chip names the board. The catalogue
    row, its test and the recovery text now say the file name and an explicit
    --chip are the protection.
    The 100 kOhm reading from 12-pin 6 to 3V3 is dropped as a check for the
    ALRT cut: it depends on meter lead polarity. No continuity across the
    jumper's pads is the test.
    packages/production.yaml's header still said one selector wraps it and
    that platform-e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
2026-10-14 Add the PCB design spec
    One fab-assembled KiCad board generated from code, replacing the two
    protoboards: decisions from the 2026-10-14 design conversation, the
    circuit, clearance rules, tooling, CI, verification and what stays
    unverified.
2026-10-14 Add the PCB design implementation plan
    Seventeen tasks from the KiCad locator to the first-article continuity
    check, with the pcbnew, kicad-cli and Freerouting behaviour each task
    relies on verified on this machine first.
2026-10-14 Add the hardware generator scaffold and KiCad locator
    Adds hardware/dryer_board with a KiCad tool locator (macOS bundle, then
    the Docker layout, then PATH, overridable by env vars) and a python -m
    dryer_board CLI with test and env commands. scripts/hardware.sh runs it
    under KiCad's bundled Python, which is the only interpreter with pcbnew,
    and filters the harmless wx assertion it prints on import. Ignores
    hardware/out/.
2026-10-14 Add an S-expression reader and writer for KiCad files
    Later tasks read KiCad symbol libraries and write schematic files, so the
    generator needs a small parser that keeps quoted tokens distinguishable
    from bare ones and a writer that emits KiCad's one-child-per-line layout.
2026-10-14 Describe the controller board as a parts and nets table
    pinmap.py maps header positions to functions and per-board GPIOs; circuit.py
    is the single table of parts, pins and nets that the schematic, board, BOM
    and position file will derive from, with check() enforcing the mains-net,
    reserved-pin and relay NC invariants. The LCSC catalogue test is an expected
    failure until the numbers are filled in.
2026-10-14 Guard the circuit table against low-voltage miswirings
    Add per-channel chain tests (relay, MOSFET, 24 V input, 5 V module, USB feed)
    so swapped heater identities, reversed diodes and fuses, and swapped regulator
    pins fail the suite. check() now requires every ESP socket position to match
    pinmap, so unowned positions (Qwiic I2C, free pins) must stay NC.
2026-10-14 Hold the firmware pin substitutions against the board's pin map
    The main board is wired by header position, and each board package
    names the GPIO behind each position. Nothing checked the two against
    each other, so a pin edit on one side could silently miswire the PCB.
    tests/test_pinmap.py parses the pin_* substitutions from both board
    packages with a regex (no PyYAML) and compares each mapped function's
    GPIO with the position table in hardware/dryer_board/pinmap.py. It runs
    in the lint-config CI job.
2026-10-14 Close the pin-map test's file handle
    substitutions() read the board package with a bare open(), leaving the
    handle to the garbage collector; -W default flagged it as a
    ResourceWarning on both board tests. Read it in a with block instead.
2026-10-14 Read stock symbols and footprints, flattening derived symbols
    libs.py loads KiCad's stock symbol libraries, merging a derived symbol
    (extends) with its parent as KiCad embeds it, and finds footprints and
    their pad numbers and positions, so the generator and tests can check
    circuit.py against the real libraries.
2026-10-14 Generate the schematic as a labelled grid from the circuit table
    Each part sits in its own cell with a global label on every pin and a
    no-connect on every NC pin, so the schematic is derived from circuit.py
    and KiCad's own netlist export can be checked against the model. The
    project-local symbol and footprint tables are written alongside, with a
    minimal .kicad_pro, because kicad-cli ignores the tables without one and
    ERC then warns about every library.
2026-10-14 Write the project file with netclasses and the mains clearance rules
    generate now writes dryer-controller.kicad_pro (netclasses in the schema
    KiCad 10 reads, DRC severities) and the .kicad_dru mains rules: 6 mm mains
    to SELV, 3.5 mm inside relay_pads, 1.5 mm mains tracks, 1 mm mains edge.
    Tests build a red and a green two-track board with pcbnew and run kicad-cli
    DRC to prove the rule is actually enforced.
2026-10-14 Build the board from the placement table with pcbnew
    placement.py holds the board outline, the isolation slot, the antenna
    keep-out, relay rule areas, the GND pour and every footprint's position
    and silkscreen. board.py turns that and the circuit model into the
    .kicad_pcb: footprints with their nets, netclasses, rule areas and pours,
    keeping tracks across a rebuild unless --fresh. `generate` now writes the
    board after the schematic, and the unrouted board passes DRC with only
    unconnected items.
    The file is deterministic: KiCad's UUID generator is seeded, and the
    board's connectivity is built before the zone fill, without which a new
    board saves its pours empty. Items are removed with Delete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
2026-10-14 Hold SELV copper 6 mm from the relay NC contacts
    Pad 4 of each relay is the NC contact. It has no net, so no copper goes
    to it, but COM connects to it whenever the coil is off, so it is live
    mains. Netless, it resolved to the Default class and none of the mains
    rules saw it: SELV copper could pass 0.2 mm from it and DRC stayed
    clean. A rule now names K1 and K2 pad 4 and keeps every non-mains item
    6 mm away; it comes after the relay_pads relaxation so that cannot lower
    it. memberOfFootprint('K*') does not match in KiCad 10.0.6, so both
    relays are named.
    drc_report also ignored kicad-cli's exit status and read whatever report
    file was already there, so a board that failed to load returned a s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
2026-10-14 Route the board with Freerouting in Docker and keep the result
    route.py exports the DSN, runs Freerouting 2.5.0 in a container (no Java on
    the host), imports the SES and rewrites the project file that SaveBoard
    resets. Routing is not deterministic, so the routed board is committed and
    CI never routes. 344 tracks; 31 pads still unconnected, left for the next task.
2026-10-14 Drop KiCad's duplicate image handler chatter from the hardware.sh output
    pcbnew.LoadBoard prints twelve 'Adding duplicate image handler' debug lines
    when it runs after other pcbnew calls in one process (the route test after
    the board tests). It is wx registering its handlers twice inside KiCad, so
    filter it beside the existing traits-assert filter to keep test output clean.
2026-10-14 Gate the routed board on DRC, full routing and the antenna keep-out
    test_routed_board runs against the committed board: DRC clean, no
    unconnected pads, no copper in the antenna keep-out, 1.5 mm mains
    tracks, bare relay NC pads. `check` runs ERC and DRC on the committed
    files, prints both reports and exits 1 on any violation.
    Getting there changed how the board is routed. KiCad's DSN export turns
    every rule area into a full keepout, so the fill-only mains zone walled
    off the relay coil pads and every mains net (31 pads unconnected). With
    it opened, Freerouting routed mains blind to the custom rules it cannot
    read: mains tracks 1-4 mm from the coil pads and the live NC pads, and
    necked down t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
2026-10-14 Keep mains copper 6 mm from the mounting holes
    L_IN ran round the top-right corner 1.19 mm from H2's hole, where an
    M3 head or washer would bear on live, unfused copper; the spec wants
    6 mm. A "mains to mounting holes" rule now gives MAINS copper a 6 mm
    hole clearance to every non-plated hole, so DRC and the gate see it.
    The two mains-to-SELV rules also matched the relays' netless NC pads,
    which are at mains potential; they now exclude pad 4 of K1 and K2, and
    "relay NC contact is live" still holds SELV 6 mm off them. With that,
    the mains copper is re-laid: L_IN (F.Cu) and L_FUSED (B.Cu) share a
    spine at x 85 between the coil and contact pads, the switched lines
    reach J_MAINS from the left a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
2026-10-14 Check the committed KiCad files against the generator in CI
    check now compares the committed project with what the model would generate
    before running ERC and DRC: schematic netlist, rules, library tables and
    project file, then board footprints, positions, pad nets, rule areas and the
    locked 1.5 mm mains copper from placement.MAINS_TRACKS (no vias on mains
    nets). SELV routing is not compared since the router is not deterministic.
    Comparison is semantic, so a GUI re-save that only reformats still passes.
    netlist_from_kicad now writes its netlist to a temporary directory so
    reading the committed sheet leaves the project directory clean.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
2026-10-14 Export fab files, JLCPCB BOM and CPL, and review renders
    Add an export command that writes the gerber zip with drill files, a JLCPCB
    BOM and CPL, the schematic PDF, a top SVG and two 3D renders from the
    committed project, and copies the four review files to docs/hardware.
    Mounting holes are now excluded from the BOM so the fab BOM lists only parts.
    README gains an Ordering section.
2026-10-14 Make the JLCPCB BOM designators plain comma lists
    kicad-cli marks references that do not end in a digit (J_24V) with a
    trailing '?' and collapses runs into ranges (D5-D7); JLCPCB wants neither.
    Pass an empty --ref-range-delimiter (accepted by 10.0.6) and strip the '?'
    in a post-process step. A new test requires the BOM designators to equal
    the CPL's plus TP1-TP9.
2026-10-14 Check and export the board in CI with the KiCad 10 image
    Add hardware.yml: pin-map test, unit tests, generator sync/ERC/DRC and the
    fab exports run in kicad/kicad:10.0, uploaded as an artifact, with a
    release job for pcb-* tags. The export gains --no-docs so CI leaves the
    committed review files in docs/hardware/ alone. build.yml ignores
    hardware/** so board changes do not rebuild the firmware.
2026-10-14 Pin every part to an LCSC number and settle the switch, fuse holder and header footprints
    Every part in circuit.py now carries a JLCPCB/LCSC number. Its description
    names the maker part and says whether it is basic or extended. The numbers
    were looked up on 2026-10-14 and all of them offer assembly. U1 is
    hand-fitted: MornSun's K7805-1000R3 is not stocked at LCSC or Mouser, and
    the TRACO TSR 1-2450 the footprint is drawn for is named as the source.
    The catalogue test is no longer an expected failure.
    The DORABO pluggable headers, the pin header and the sockets match their
    stock KiCad footprints in pitch, pin count and hole size, so those stay.
    Two parts get local footprints:
    - SW1 is a SOFN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
2026-10-14 Drill the pluggable headers to their datasheet holes and clear F1 off the slot
    The DORABO headers have square pins: 1.0 mm on the 5.08 mm parts and
    0.8 mm on the 3.5 mm part. Their drawings ask for Ø1.7 and Ø1.4 holes,
    because the pin's diagonal governs. The stock Phoenix footprints drill
    1.4 and 1.2. Local copies of the four Phoenix footprints now carry the
    datasheet drills, with pads widened to keep a 0.3 mm ring:
    - the 5.08 mm headers: 2.3 x 3.6 mm pads, 2.78 mm between pad edges;
    - J_SENS: 2.0 x 3.6 mm pads.
    F1 moves 0.3 mm right to (77.3, 7) so its body clears the slot. Its L_IN
    pad now sits 6.3 mm from the SELV pour instead of exactly 6.0. The L_IN
    and L_FUSED track ends follow it.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
2026-10-14 Document the PCB: BOM, pinouts, LEDs, failure modes, inspection and release flow
    docs/hardware.md gains a "Printed circuit board (rev A)" section: the BOM
    generated from circuit.py, header pinouts, the LED table, the SW-USB rule,
    the relay NO/NC derivation, the mains layout and DRC rules, a desk review
    of the clearances against IEC 62368-1 (marked unverified), the CJ2310 gate
    drive and the USB-pin drop budget with the TSR 1-2450's tolerance. The
    protoboard section becomes the previous build.
    The relay's COM-to-coil pad gap is recorded as measured on the committed
    board (3.51 mm), not the spec's estimated 3.8 mm.
    failure-modes.md records the PCB mitigation in A-15, F-03, G-09 and G-11
    and a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
2026-10-14 Qualify the protoboard-only parts and checks now that a PCB exists
    CLAUDE.md's driver bullets, the top BOM table in docs/hardware.md and the
    inspection items A-04, A-06, F-10 and F-19 described only the protoboard
    (PN2222A, IRLZ44N, MP1584, JP-USB, the harness), which an inspector would
    apply to a PCB and reject a good board. Each now says which build it
    covers, with a PCB variant where one is needed. The datasheet index links
    both BOMs, since the retitled heading moved its anchor.
2026-10-14 Add the PCB first-article continuity check
    New "PCB rev A" section in docs/board-continuity-check.md, ahead of the
    protoboard steps, with eight numbered items: shorts (including the slot
    on the MΩ range), relay NO/NC identity, fuse path, plug keying, driver
    resistances, power path (diodes, SW-USB slider, TP4/TP3/12-pin 3
    voltages), the LED table and mains isolation. hardware.md already cites
    "PCB section, item 6" for the voltage check, and the numbering matches.
    Pin numbers and nets were checked against circuit.py; all expected values
    are derived, not measured. hardware-bringup.md section 1 points PCB
    builds at it first.
2026-10-14 Add SW-USB ON/OFF legends and fix review points in the PCB check
    The continuity check told the technician to find the ON position on the
    silkscreen, but the board had only the "OFF before any USB-C" line. Add
    "ON" (above pin 1) and "OFF" (above pin 3) legends at SW1, regenerate
    the board and review files (DRC 0 violations, 0 unconnected), and define
    OFF electrically in the check.
    Item 4 claimed the 6-pin loads plug cannot enter J_MAINS; both are
    5.08 mm, so it can. Drop that row and say so in hardware.md. Also make
    the 12-pin 3 drop reading ESP-in only, simplify the coil row, drop the
    duplicate D11 row, state the item 7 power state and the J_24V probe
    polarity.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
2026-10-14 Refresh the PCB review renders
2026-10-14 Hold L-side mains copper 1.6 mm apart and stop the relay-area relaxation leaking
    The L_FUSED stub to J_MAINS pin 7 ran 1.22 mm (copper edge to edge)
    from K1's NO pad (L_SW_A). It now runs at y 32.3 and jogs up onto the
    pad: 2.00 mm. The closest L-side pair on the board is now 1.80 mm
    (L_IN spine to K2 pad 3); L to N stays at 1.55 mm.
    KiCad's insideArea tests the whole item, so a mains segment that
    touched a relay_pads area got the 3.5 mm relaxation along its full
    length. The x 85 spines are split at y 11/33/49, the L_FUSED diagonal
    at (87, 12) and the L_IN feed and L_FUSED stub at x 87, so only the
    pieces at the relay pads are relaxed; a placement test holds that.
    New DRC rule "mains L to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
2026-10-14 Keep tracks and vias out from under the 5 V converter
    TRACO's TSR-1 datasheet says not to route under the converter; the
    routed board had 34 track segments inside U1's courtyard. A new
    u1_keepout rule area (both copper layers, tracks and vias forbidden,
    pours and pads allowed) covers the courtyard from its top to y 29.5.
    Down to y 30, the pad row's centre line, the router left nine
    connections unrouted (U1 pads 1 and 3 among them), so it stops 0.5 mm
    short, the fallback the review allowed.
    With the area in place Freerouting necked a GND track to 0.18 mm, under
    the 0.2 mm minimum, to pass R17's pad; R17 moves 0.5 mm down to y 36.5
    and the route is clean. Re-routed with 200 passes: DRC 0 viol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
2026-10-14 Compare rule-area and board-outline geometry in the sync check
    board_diffs compared rule areas by name and count only and never looked
    at Edge.Cuts, so a moved relay area or a deleted slot segment passed.
    board.py now lists the rule areas (name, rectangle, what each forbids)
    and the Edge.Cuts outlines in rule_areas() and edge_outlines(); build
    lays them from those lists and check_sync compares each area's outline
    and its no-fills/tracks/vias/pads flags, and the board rectangle and
    slot polygons, one to one within 0.01 mm (KiCad's load/save rounding).
    Every missing, extra or changed item is reported.
    New tests (red against the old check, green now): a relay area moved
    2 mm, a cleared u1_keep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
2026-10-14 Clear footprint references off the silkscreen labels
    The J_MAINS reference printed across the pin 4 "N" and pin 5 "HTR B"
    labels; R18, C5 and C6 sat on the J_DISP legend; the LED references
    covered "24V", "5V", "VLV A", "VLV B"; and "FAN" was under R15's
    reference. board.py now hides the silkscreen reference of the
    footprints in placement.HIDDEN_REFS (J_MAINS, R18, C5, C6, D8, D9, D10,
    D12, D13); their names stay on F.Fab. The J_MAINS pin labels move to
    x 95.5, clear of the pin-1 triangle "L IN" touched, and "FAN" moves
    above D10 to match the valve labels. Checked on zoomed 3D renders of
    the mains header, the display strip and the LED block. DRC 0
    violations, 0 unconnected.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
2026-10-14 Make the fab-order files match what is fitted
    U1's value was K7805-1000R3 while the fitted part is the TRACO TSR 1-2450
    from Mouser; the value is now TSR 1-2450 and the description names the
    Mouser source and the MornSun part as the unstocked alternative. The
    hardware.md BOM row follows.
    Test points TP1-TP9 were in the BOM with no LCSC number, contradicting
    "test points are not parts"; the schematic now marks them not in BOM, so
    the BOM designators equal the CPL's exactly and every BOM line but U1
    carries an LCSC number (both tests red on the old schematic).
    The release step attached out/*.csv, which picks up KiCad's own position
    file; it now attaches the -bom and -cpl files only, and rele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
2026-10-14 Document the review fixes and qualify the remaining protoboard-only text
    hardware.md: the J_LOADS-into-J_MAINS mis-plug is self-limiting (the
    board then gets no mains, the 24 V supply included, since it is fed from
    J_MAINS pins 7/8); the rule table gains the 1.6 mm L-to-L rule; the
    clearance narrative gives the measured L-to-L minimum (1.80 mm), the
    moved L_FUSED stub (2.00 mm from K1's NO pad), the COM pads' 5.0 mm to
    the SELV pour inside the relay areas, the segment split at the area
    edges, and 6.3 mm as the closest mains-to-SELV pair outside them. The
    PCB section and CLAUDE.md's rev A item regain the two dropped
    unverified items: board thermal and the USB-C overhang.
    The spec's As built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
2026-10-15 Split the design into a controller board and a mains board (review of 2026-10-15)
    The single 110 x 85 mm board becomes two: dryer-controller (76 x 85 mm:
    the socketed Thing Plus, 24 V in, the 5 V module, SW-USB, the three MOSFET
    stages, sensor and display headers, test points) and dryer-mains (64 x 85
    mm: F1, both relays with their driver stages, J_MAINS), joined by the
    protoboard harness's keyed JST-XH 4-way link (J_RLY / J_CTRL: 5 V, GND,
    heater A, heater B). The 1 k base series resistors stay on the controller
    and the pulldowns on the mains board, as the protoboard had them. The mains
    board is the single board's mains strip moved 48 mm left and 6 mm down on a
    2 mm wider board, so the meas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
2026-10-15 Add the design for fitting the two boards to the enclosure spaces
    The reviewer's spaces are 85 x 70 and 45 x 70 mm; the split in 63e7ad3
    gave 76 x 85 and 64 x 85. This records the re-layout agreed with the
    owner: the Thing Plus along the controller board's long edge, the mains
    board's SELV strip, slot and mains zone re-cut to 45 mm, every rule and
    part unchanged.
2026-10-15 Add the plan for fitting the boards to the enclosure spaces
    Four tasks: outline and fit tests with the new geometry constants, routing
    both boards clean, measured clearance margins in the suite, and the docs
    and renders.
2026-10-15 Fit the controller and mains boards to 85 x 70 and 45 x 70 mm
    The reviewer's enclosure spaces are 85 x 70 mm (controller) and 45 x 70 mm
    (mains); the split boards were 76 x 85 and 64 x 85. New tests pin the
    outlines before DRC: each board's declared size and Edge.Cuts geometry,
    the corner holes 4 mm in, every courtyard inside the outline (the ESP
    sockets, J_MAINS and the M4 head courtyards excepted), no hole under the
    Thing Plus body, and the same link pinout on J_RLY and J_CTRL.
    Controller: the Thing Plus lies along the long edge, USB-C face 3 mm past
    the left edge, antenna keep-out at the right end starting past the last
    socket pads (a no-pads keep-out cannot cover them). J_RLY and J_SENS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
2026-10-15 Keep the link header 6 mm from the relay COM pads and bound the plug overhang
    Review of the 45 x 70 mains board: J_CTRL's +5V pin sat 5.67 mm from K1's
    COM, passing only on the relay-area 3.5 mm relaxation, which exists for
    the relay's own coil-to-COM geometry. J_CTRL moves down to pins y 33-40.5
    (6.32 mm from K1's COM, 11.21 from K2's) and driver B is re-stacked down
    the edge column below it, with only R6 in the second column, so every
    strip pad keeps the plain 6 mm from both COM pads.
    test_courtyards_inside no longer exempts J_MAINS and the ESP sockets
    outright: J_MAINS may leave the mains board's right edge by at most
    5.1 mm and nowhere else, and the sockets must lie inside (the Thing Pl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
2026-10-15 Route both boards at their enclosure sizes
    Both boards are routed with Freerouting 2.5.0 (200 passes) and are DRC
    clean with every pad connected: controller 477 tracks, mains 171.
    The router copy now carries what the router could not see:
    - a 0.55 mm keep-out band inside the outline, since Freerouting keeps
    only its 0.2 mm clearance from the edge and the project needs 0.5;
    - a keep-out round each mains pad or track outside the relay areas,
    grown by 5.85 mm (6.05 with the router's own clearance), so SELV
    routes in the strip keep the 6 mm "mains to selv" rule beside F1's
    pad 1 (6.07 mm measured, COIL_A).
    After the import, a track the optimiser necked below the project's
    0.2 mm minimum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
2026-10-15 Measure the mains board's clearance margins in the suite
    Also judge relay-area membership by the real copper outline, cover the
    relay NC pads in the saved-fill test, and refresh the mains.py comments.
2026-10-15 Test mains to board edge, count NC pads as L-side nets, tidy margins test
2026-10-15 Document the boards at their enclosure sizes
2026-10-15 Print the unclipped SELV-to-COM minimum, strip figure second
2026-10-16 Make the mains plug vertical and the fuse holder 12.5 mm after the second review
    JWardT3D (PR #49, 2026-10-15): a wall borders the mains space, so the
    plug's wires must leave perpendicular to the board; the fuse holders on
    hand measure about 12.5 mm pitch with a 25.7 x 10 mm body.
    J_MAINS becomes the vertical DORABO DB2EV-5.08-8P-GN (LCSC C395787) on a
    local copy of the Phoenix MSTBVA 8-pin footprint drilled 1.7 mm, placed
    at (39.5, 17.94) rotated 270 so pin 1 is the top pin and the body's
    deeper side faces the edge; the housing no longer overhangs the board,
    and test_outlines no longer allows any overhang. The DB2EV's own drawing
    is not retrieved: the entry direction, the hole size and the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
2026-10-16 Fit the fab-fitted 15 mm fuse holder after the reviewer confirmed the on-hand pitch
    JWardT3D (PR #49, 2026-10-15): the holders on hand are about 22 mm
    pitch after all (the 12.5 mm came from the listing's picture); the hole
    pattern, the USB-C overhang, the vertical plug and the strip-to-COM
    clearance stand; the plug's screws should face away from the wall.
    Their 25.8 mm BLX-A body and the vertical plug do not both fit: with
    mains copper 1 mm from the slot the body runs from x 10.35 to 36.15,
    0.56 mm into the plug's body and 1 mm into its courtyard at 35.16
    (strip, slot, clearance, holder and plug body add up to 45.6 mm across
    the 45 mm board). F1 therefore returns to the single-board rev A's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
2026-10-16 Add the PCBWay quote packet to the hardware README
    JWardT3D (PR #49, 2026-10-16) kept the design as laid out and asked for
    a PCBWay estimate. The request needs an account and contact details, so
    a person files it; the README now carries everything the form asks for:
    where the gerbers, BOM, CPL and schematics come from (the CI artifact or
    a local export), the board parameters (size, stackup, finish, minimum
    track, clearance and hole, the mains board's isolation slot, the holes,
    the quantity), the per-board assembly counts (controller 26 lines, 43
    placements with U1 excluded; mains 9 lines, 15 placements), the parts
    whose sourcing to confirm, and the steps on the site.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
2026-10-17 Write the CPL for JLCPCB: pad-centre positions and per-package rotations
    JWardT3D's JLCPCB upload (PR #49, 2026-10-16) showed the connectors
    180 degrees out and shifted, the ESP sockets 90 degrees out and
    shifted, and the SOT-23 and electrolytic parts 180 degrees out. Two
    causes: KiCad's position file gives each footprint's anchor, which is
    pin 1 on every through-hole part here (up to 19 mm from the body
    centre on the 16-pin socket), while JLCPCB places at Mid X/Y; and
    KiCad's zero rotation is not JLCPCB's library orientation for several
    packages.
    export.jlc_cpl now takes the board and writes the centre of each
    part's pads (x as KiCad's, y negated as in its file) and a rotation
    corrected by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
2026-10-17 Note that JLCPCB draws a box for parts without a 3D model
    JWardT3D (PR #49, 2026-10-16) saw the fuse holder rendered as a flat
    rectangle in JLCPCB's 3D review. Their part page for C48603682 lists an
    EasyEDA footprint and no 3D model, so the box is their placeholder; the
    XFCN drawing matches the footprint (pins 15 mm apart, 1.6 mm holes,
    24.4 x 9.4 x 15 mm body). The ordering steps now say what to check
    instead: the 2D view and the BOM match.
