jrytio/desiccant-dryer/(notices)

Notices in the files:
hardware/dryer-mains/dryer-mains.kicad_pcb:
dryer mains board rev A AGPL-3.0
hardware/dryer-controller/dryer-controller.kicad_pcb:
ESP32 desiccant dryer controller rev A AGPL-3.0 github.com/jrytio/desiccant-dryer
parts and their libraries:
SparkFun-Aesthetics: Licensing: Creative Commons ShareAlike 4.0 International - https://creativecommons.org/licenses/by-sa/4.0
SparkFun-Aesthetics: Released under the Creative Commons Attribution Share-Alike 4.0 License
SparkFun-Aesthetics: https://creativecommons.org/licenses/by-sa/4.0
